rasusmilch/HAB/Weather_Balloon_Info/Sparkfun Geiger/Geiger_Counter-V_HW4.0_FW1.2/README.md

Geiger Counter
========================================
[Geiger Counter
*Geiger Counter (SEN-11345)*](https://www.sparkfun.com/products/11345)

This USB powered Geiger Counter is equipped with an ATMega328 that can be programmed in-circuit. Out of the box, the board works
at 9600 bps over any serial terminal and generates random bits in reaction to background radiation.

Repository Contents
-------------------
* **/Firmware** - Firmware that ships on the Geiger Counter
* **/Hardware** - All Eagle design files (.brd, .sch)
* **/Production** - Test bed files and production panel files

Product Versions
----------------
* [SEN-11345](https://www.sparkfun.com/products/11345)- Version 2.1. Current.
* [SEN-10742](https://www.sparkfun.com/products/retired/10742)- Version 1.2-Retired. 

Version History
---------------
* [v21](https://github.com/sparkfun/Geiger_Counter/tree/HW_2.1_FW_2.1) GitHub version 2.1 files.
* [v12](https://github.com/sparkfun/Geiger_Counter/tree/v12) GitHub version 1.2 files. 

License Information
-------------------
The hardware is released under [Creative Commons ShareAlike 4.0 International](https://creativecommons.org/licenses/by-sa/4.0/).
The code is beerware; if you see me (or any other SparkFun employee) at the local, and you've found our code helpful, please buy us a round!

Distributed as-is; no warranty is given.
