rasusmilch/HAB/Weather_Balloon_Info/Sparkfun Geiger/Geiger_Counter-V_HW4.0_FW1.2/firmware/default_firmware/README.md

This is v12 firmware, which ships on all Geiger Counter boards currently. It is a random number generator.
