rasusmilch/HAB/Weather_Balloon/Documentation/UML_Doxygen/latex/arduino-_zero_regs_2_r_e_a_d_m_e_8md.tex

\hypertarget{arduino-_zero_regs_2_r_e_a_d_m_e_8md}{}\section{Weather\+\_\+\+Balloon/library/arduino-\/\+Zero\+Regs/\+R\+E\+A\+D\+ME.md File Reference}
\label{arduino-_zero_regs_2_r_e_a_d_m_e_8md}\index{Weather\+\_\+\+Balloon/library/arduino-\/\+Zero\+Regs/\+R\+E\+A\+D\+M\+E.\+md@{Weather\+\_\+\+Balloon/library/arduino-\/\+Zero\+Regs/\+R\+E\+A\+D\+M\+E.\+md}}
