rasusmilch/HAB/Weather_Balloon/Documentation/UML_Doxygen/latex/arduino-ms5xxx-master_2_l_i_c_e_n_s_e_8md.tex

\hypertarget{arduino-ms5xxx-master_2_l_i_c_e_n_s_e_8md}{}\section{Weather\+\_\+\+Balloon/library/arduino-\/ms5xxx-\/master/\+L\+I\+C\+E\+N\+SE.md File Reference}
\label{arduino-ms5xxx-master_2_l_i_c_e_n_s_e_8md}\index{Weather\+\_\+\+Balloon/library/arduino-\/ms5xxx-\/master/\+L\+I\+C\+E\+N\+S\+E.\+md@{Weather\+\_\+\+Balloon/library/arduino-\/ms5xxx-\/master/\+L\+I\+C\+E\+N\+S\+E.\+md}}
