rasusmilch/HAB/Weather_Balloon/Documentation/UML_Doxygen/latex/device_8h.tex

\hypertarget{device_8h}{}\section{Weather\+\_\+\+Balloon/library/\+Lib\+A\+P\+R\+S/device.h File Reference}
\label{device_8h}\index{Weather\+\_\+\+Balloon/library/\+Lib\+A\+P\+R\+S/device.\+h@{Weather\+\_\+\+Balloon/library/\+Lib\+A\+P\+R\+S/device.\+h}}
{\ttfamily \#include \char`\"{}constants.\+h\char`\"{}}\\*
Include dependency graph for device.\+h\+:
\nopagebreak
\begin{figure}[H]
\begin{center}
\leavevmode
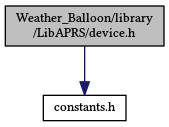
[picture p1: Weather_Balloon/Documentation/UML_Doxygen/html/device_8h__incl.png]

\end{center}
\end{figure}
This graph shows which files directly or indirectly include this file\+:
\nopagebreak
\begin{figure}[H]
\begin{center}
\leavevmode
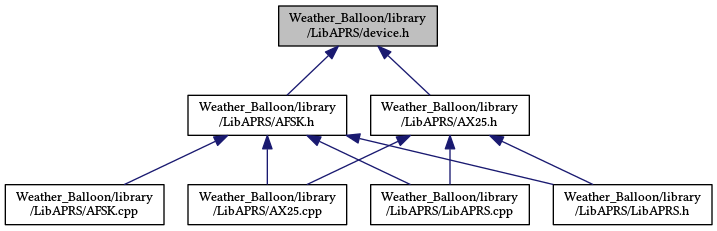
[picture p2: Weather_Balloon/Documentation/UML_Doxygen/html/device_8h__dep__incl.png]

\end{center}
\end{figure}
\subsection*{Macros}
\begin{DoxyCompactItemize}
\item 
\#define \hyperlink{device_8h_a7c97fac2f222d841b9b657b47b2aed87}{T\+A\+R\+G\+E\+T\+\_\+\+C\+PU}~\hyperlink{constants_8h_ab21c12c8b945e012e7cad672d64c6805}{m328p}
\item 
\#define \hyperlink{device_8h_a43bafb28b29491ec7f871319b5a3b2f8}{F\+\_\+\+C\+PU}~16000000
\item 
\#define \hyperlink{device_8h_ae0c5f12cd1a193d30e4e05bbe86ce45e}{F\+R\+E\+Q\+U\+E\+N\+C\+Y\+\_\+\+C\+O\+R\+R\+E\+C\+T\+I\+ON}~0
\item 
\#define \hyperlink{device_8h_a9e83bcb5c8fb1fd1712fc7c454546da9}{C\+O\+N\+F\+I\+G\+\_\+\+A\+F\+S\+K\+\_\+\+D\+A\+C\+\_\+\+S\+A\+M\+P\+L\+E\+R\+A\+TE}~9600
\item 
\#define \hyperlink{device_8h_afbdc123b0b82a37ee0e8272c6e39e66c}{D\+A\+C\+\_\+\+P\+O\+RT}~P\+O\+R\+TD
\item 
\#define \hyperlink{device_8h_a4f88bd60347c4c0ff4344fc8614f390c}{D\+A\+C\+\_\+\+D\+DR}~D\+D\+RD
\item 
\#define \hyperlink{device_8h_a663daa01e565aee93c6f20c5845b90b4}{L\+E\+D\+\_\+\+P\+O\+RT}~P\+O\+R\+TB
\item 
\#define \hyperlink{device_8h_a2eb4252b35effe1188cb61b6124fa617}{L\+E\+D\+\_\+\+D\+DR}~D\+D\+RB
\item 
\#define \hyperlink{device_8h_a1c6ce969ab3d12ac37f62c399a1e02c1}{A\+D\+C\+\_\+\+P\+O\+RT}~P\+O\+R\+TC
\item 
\#define \hyperlink{device_8h_a6f53fbd627478c7f56cdb17b5aa3ff44}{A\+D\+C\+\_\+\+D\+DR}~D\+D\+RC
\end{DoxyCompactItemize}

\subsection{Macro Definition Documentation}
\index{device.\+h@{device.\+h}!A\+D\+C\+\_\+\+D\+DR@{A\+D\+C\+\_\+\+D\+DR}}
\index{A\+D\+C\+\_\+\+D\+DR@{A\+D\+C\+\_\+\+D\+DR}!device.\+h@{device.\+h}}
\subsubsection[{\texorpdfstring{A\+D\+C\+\_\+\+D\+DR}{ADC\_DDR}}]{\setlength{\rightskip}{0pt plus 5cm}\#define A\+D\+C\+\_\+\+D\+DR~D\+D\+RC}\hypertarget{device_8h_a6f53fbd627478c7f56cdb17b5aa3ff44}{}\label{device_8h_a6f53fbd627478c7f56cdb17b5aa3ff44}

Definition at line 29 of file device.\+h.

\index{device.\+h@{device.\+h}!A\+D\+C\+\_\+\+P\+O\+RT@{A\+D\+C\+\_\+\+P\+O\+RT}}
\index{A\+D\+C\+\_\+\+P\+O\+RT@{A\+D\+C\+\_\+\+P\+O\+RT}!device.\+h@{device.\+h}}
\subsubsection[{\texorpdfstring{A\+D\+C\+\_\+\+P\+O\+RT}{ADC\_PORT}}]{\setlength{\rightskip}{0pt plus 5cm}\#define A\+D\+C\+\_\+\+P\+O\+RT~P\+O\+R\+TC}\hypertarget{device_8h_a1c6ce969ab3d12ac37f62c399a1e02c1}{}\label{device_8h_a1c6ce969ab3d12ac37f62c399a1e02c1}

Definition at line 28 of file device.\+h.

\index{device.\+h@{device.\+h}!C\+O\+N\+F\+I\+G\+\_\+\+A\+F\+S\+K\+\_\+\+D\+A\+C\+\_\+\+S\+A\+M\+P\+L\+E\+R\+A\+TE@{C\+O\+N\+F\+I\+G\+\_\+\+A\+F\+S\+K\+\_\+\+D\+A\+C\+\_\+\+S\+A\+M\+P\+L\+E\+R\+A\+TE}}
\index{C\+O\+N\+F\+I\+G\+\_\+\+A\+F\+S\+K\+\_\+\+D\+A\+C\+\_\+\+S\+A\+M\+P\+L\+E\+R\+A\+TE@{C\+O\+N\+F\+I\+G\+\_\+\+A\+F\+S\+K\+\_\+\+D\+A\+C\+\_\+\+S\+A\+M\+P\+L\+E\+R\+A\+TE}!device.\+h@{device.\+h}}
\subsubsection[{\texorpdfstring{C\+O\+N\+F\+I\+G\+\_\+\+A\+F\+S\+K\+\_\+\+D\+A\+C\+\_\+\+S\+A\+M\+P\+L\+E\+R\+A\+TE}{CONFIG\_AFSK\_DAC\_SAMPLERATE}}]{\setlength{\rightskip}{0pt plus 5cm}\#define C\+O\+N\+F\+I\+G\+\_\+\+A\+F\+S\+K\+\_\+\+D\+A\+C\+\_\+\+S\+A\+M\+P\+L\+E\+R\+A\+TE~9600}\hypertarget{device_8h_a9e83bcb5c8fb1fd1712fc7c454546da9}{}\label{device_8h_a9e83bcb5c8fb1fd1712fc7c454546da9}

Definition at line 20 of file device.\+h.

\index{device.\+h@{device.\+h}!D\+A\+C\+\_\+\+D\+DR@{D\+A\+C\+\_\+\+D\+DR}}
\index{D\+A\+C\+\_\+\+D\+DR@{D\+A\+C\+\_\+\+D\+DR}!device.\+h@{device.\+h}}
\subsubsection[{\texorpdfstring{D\+A\+C\+\_\+\+D\+DR}{DAC\_DDR}}]{\setlength{\rightskip}{0pt plus 5cm}\#define D\+A\+C\+\_\+\+D\+DR~D\+D\+RD}\hypertarget{device_8h_a4f88bd60347c4c0ff4344fc8614f390c}{}\label{device_8h_a4f88bd60347c4c0ff4344fc8614f390c}

Definition at line 25 of file device.\+h.

\index{device.\+h@{device.\+h}!D\+A\+C\+\_\+\+P\+O\+RT@{D\+A\+C\+\_\+\+P\+O\+RT}}
\index{D\+A\+C\+\_\+\+P\+O\+RT@{D\+A\+C\+\_\+\+P\+O\+RT}!device.\+h@{device.\+h}}
\subsubsection[{\texorpdfstring{D\+A\+C\+\_\+\+P\+O\+RT}{DAC\_PORT}}]{\setlength{\rightskip}{0pt plus 5cm}\#define D\+A\+C\+\_\+\+P\+O\+RT~P\+O\+R\+TD}\hypertarget{device_8h_afbdc123b0b82a37ee0e8272c6e39e66c}{}\label{device_8h_afbdc123b0b82a37ee0e8272c6e39e66c}

Definition at line 24 of file device.\+h.

\index{device.\+h@{device.\+h}!F\+\_\+\+C\+PU@{F\+\_\+\+C\+PU}}
\index{F\+\_\+\+C\+PU@{F\+\_\+\+C\+PU}!device.\+h@{device.\+h}}
\subsubsection[{\texorpdfstring{F\+\_\+\+C\+PU}{F\_CPU}}]{\setlength{\rightskip}{0pt plus 5cm}\#define F\+\_\+\+C\+PU~16000000}\hypertarget{device_8h_a43bafb28b29491ec7f871319b5a3b2f8}{}\label{device_8h_a43bafb28b29491ec7f871319b5a3b2f8}

Definition at line 12 of file device.\+h.

\index{device.\+h@{device.\+h}!F\+R\+E\+Q\+U\+E\+N\+C\+Y\+\_\+\+C\+O\+R\+R\+E\+C\+T\+I\+ON@{F\+R\+E\+Q\+U\+E\+N\+C\+Y\+\_\+\+C\+O\+R\+R\+E\+C\+T\+I\+ON}}
\index{F\+R\+E\+Q\+U\+E\+N\+C\+Y\+\_\+\+C\+O\+R\+R\+E\+C\+T\+I\+ON@{F\+R\+E\+Q\+U\+E\+N\+C\+Y\+\_\+\+C\+O\+R\+R\+E\+C\+T\+I\+ON}!device.\+h@{device.\+h}}
\subsubsection[{\texorpdfstring{F\+R\+E\+Q\+U\+E\+N\+C\+Y\+\_\+\+C\+O\+R\+R\+E\+C\+T\+I\+ON}{FREQUENCY\_CORRECTION}}]{\setlength{\rightskip}{0pt plus 5cm}\#define F\+R\+E\+Q\+U\+E\+N\+C\+Y\+\_\+\+C\+O\+R\+R\+E\+C\+T\+I\+ON~0}\hypertarget{device_8h_ae0c5f12cd1a193d30e4e05bbe86ce45e}{}\label{device_8h_ae0c5f12cd1a193d30e4e05bbe86ce45e}

Definition at line 16 of file device.\+h.

\index{device.\+h@{device.\+h}!L\+E\+D\+\_\+\+D\+DR@{L\+E\+D\+\_\+\+D\+DR}}
\index{L\+E\+D\+\_\+\+D\+DR@{L\+E\+D\+\_\+\+D\+DR}!device.\+h@{device.\+h}}
\subsubsection[{\texorpdfstring{L\+E\+D\+\_\+\+D\+DR}{LED\_DDR}}]{\setlength{\rightskip}{0pt plus 5cm}\#define L\+E\+D\+\_\+\+D\+DR~D\+D\+RB}\hypertarget{device_8h_a2eb4252b35effe1188cb61b6124fa617}{}\label{device_8h_a2eb4252b35effe1188cb61b6124fa617}

Definition at line 27 of file device.\+h.

\index{device.\+h@{device.\+h}!L\+E\+D\+\_\+\+P\+O\+RT@{L\+E\+D\+\_\+\+P\+O\+RT}}
\index{L\+E\+D\+\_\+\+P\+O\+RT@{L\+E\+D\+\_\+\+P\+O\+RT}!device.\+h@{device.\+h}}
\subsubsection[{\texorpdfstring{L\+E\+D\+\_\+\+P\+O\+RT}{LED\_PORT}}]{\setlength{\rightskip}{0pt plus 5cm}\#define L\+E\+D\+\_\+\+P\+O\+RT~P\+O\+R\+TB}\hypertarget{device_8h_a663daa01e565aee93c6f20c5845b90b4}{}\label{device_8h_a663daa01e565aee93c6f20c5845b90b4}

Definition at line 26 of file device.\+h.

\index{device.\+h@{device.\+h}!T\+A\+R\+G\+E\+T\+\_\+\+C\+PU@{T\+A\+R\+G\+E\+T\+\_\+\+C\+PU}}
\index{T\+A\+R\+G\+E\+T\+\_\+\+C\+PU@{T\+A\+R\+G\+E\+T\+\_\+\+C\+PU}!device.\+h@{device.\+h}}
\subsubsection[{\texorpdfstring{T\+A\+R\+G\+E\+T\+\_\+\+C\+PU}{TARGET\_CPU}}]{\setlength{\rightskip}{0pt plus 5cm}\#define T\+A\+R\+G\+E\+T\+\_\+\+C\+PU~{\bf m328p}}\hypertarget{device_8h_a7c97fac2f222d841b9b657b47b2aed87}{}\label{device_8h_a7c97fac2f222d841b9b657b47b2aed87}

Definition at line 8 of file device.\+h.
