rasusmilch/HAB/Weather_Balloon/Documentation/UML_Doxygen/latex/hierarchy.tex

\section{Class Hierarchy}
This inheritance list is sorted roughly, but not completely, alphabetically\+:\begin{DoxyCompactList}
\item \contentsline{section}{accel\+Settings}{\pageref{_l_s_m9_d_s1___types_8h}}{}
\item \contentsline{section}{Adafruit\+\_\+\+Sensor}{\pageref{class_adafruit___sensor}}{}
\begin{DoxyCompactList}
\item \contentsline{section}{Adafruit\+\_\+\+A\+D\+X\+L345\+\_\+\+Unified}{\pageref{class_adafruit___a_d_x_l345___unified}}{}
\item \contentsline{section}{Adafruit\+\_\+\+T\+S\+L2561\+\_\+\+Unified}{\pageref{class_adafruit___t_s_l2561___unified}}{}
\end{DoxyCompactList}
\item \contentsline{section}{Adafruit\+\_\+\+S\+H\+T31}{\pageref{class_adafruit___s_h_t31}}{}
\item \contentsline{section}{Adafruit\+\_\+\+S\+I1145}{\pageref{class_adafruit___s_i1145}}{}
\item B\+L\+E\+Peripheral\begin{DoxyCompactList}
\item \contentsline{section}{B\+L\+E\+Stream}{\pageref{class_b_l_e_stream}}{}
\end{DoxyCompactList}
\item \contentsline{section}{cid\+\_\+t}{\pageref{_sd_info_8h}}{}
\item \contentsline{section}{csd1\+\_\+t}{\pageref{_sd_info_8h}}{}
\item \contentsline{section}{csd2\+\_\+t}{\pageref{_sd_info_8h}}{}
\item \contentsline{section}{csd\+\_\+t}{\pageref{_sd_info_8h}}{}
\item \contentsline{section}{Dallas\+Temperature}{\pageref{class_dallas_temperature}}{}
\item \contentsline{section}{data\+\_\+struct}{\pageref{_weather___balloon_8cpp}}{}
\item \contentsline{section}{data\+\_\+struct.\+accel}{\pageref{_weather___balloon_8cpp}}{}
\item \contentsline{section}{data\+\_\+struct.\+battery}{\pageref{_weather___balloon_8cpp}}{}
\item \contentsline{section}{data\+\_\+struct.\+enabled}{\pageref{_weather___balloon_8cpp}}{}
\item \contentsline{section}{data\+\_\+struct.\+found}{\pageref{_weather___balloon_8cpp}}{}
\item \contentsline{section}{data\+\_\+struct.\+geiger}{\pageref{_weather___balloon_8cpp}}{}
\item \contentsline{section}{data\+\_\+struct.\+gps}{\pageref{_weather___balloon_8cpp}}{}
\item \contentsline{section}{data\+\_\+struct.\+gyro}{\pageref{_weather___balloon_8cpp}}{}
\item \contentsline{section}{data\+\_\+struct.\+mag}{\pageref{_weather___balloon_8cpp}}{}
\item \contentsline{section}{data\+\_\+struct.\+ms5607}{\pageref{_weather___balloon_8cpp}}{}
\item \contentsline{section}{data\+\_\+struct.\+pwm}{\pageref{_weather___balloon_8cpp}}{}
\item \contentsline{section}{data\+\_\+struct.\+sht31}{\pageref{_weather___balloon_8cpp}}{}
\item \contentsline{section}{data\+\_\+struct.\+temp}{\pageref{_weather___balloon_8cpp}}{}
\item \contentsline{section}{data\+\_\+struct.\+tsl}{\pageref{_weather___balloon_8cpp}}{}
\item \contentsline{section}{Date\+Time}{\pageref{class_date_time}}{}
\item \contentsline{section}{device\+Settings}{\pageref{_l_s_m9_d_s1___types_8h}}{}
\item \contentsline{section}{D\+S3231}{\pageref{class_d_s3231}}{}
\item \contentsline{section}{eeprom\+\_\+struct}{\pageref{_weather___balloon_8cpp}}{}
\item \contentsline{section}{Filter\+Derivative}{\pageref{struct_filter_derivative}}{}
\item \contentsline{section}{Filter\+One\+Pole}{\pageref{struct_filter_one_pole}}{}
\item \contentsline{section}{Filter\+One\+Pole\+Cascade}{\pageref{struct_filter_one_pole_cascade}}{}
\item \contentsline{section}{Filter\+Two\+Pole}{\pageref{struct_filter_two_pole}}{}
\item \contentsline{section}{Firmata\+Class}{\pageref{class_firmata_class}}{}
\item \contentsline{section}{Firmata\+Feature}{\pageref{class_firmata_feature}}{}
\begin{DoxyCompactList}
\item \contentsline{section}{Serial\+Firmata}{\pageref{class_serial_firmata}}{}
\end{DoxyCompactList}
\item \contentsline{section}{gyro\+Settings}{\pageref{_l_s_m9_d_s1___types_8h}}{}
\item \contentsline{section}{I\+M\+U\+Settings}{\pageref{_l_s_m9_d_s1___types_8h}}{}
\item \contentsline{section}{Led\+Control}{\pageref{class_led_control}}{}
\item \contentsline{section}{L\+S\+M9\+D\+S1}{\pageref{class_l_s_m9_d_s1}}{}
\item \contentsline{section}{M\+A\+G3110}{\pageref{class_m_a_g3110}}{}
\item \contentsline{section}{mag\+Settings}{\pageref{_l_s_m9_d_s1___types_8h}}{}
\item \contentsline{section}{M\+A\+X17043}{\pageref{class_m_a_x17043}}{}
\item \contentsline{section}{M\+S5xxx}{\pageref{class_m_s5xxx}}{}
\begin{DoxyCompactList}
\item \contentsline{section}{M\+S5611}{\pageref{class_m_s5611}}{}
\end{DoxyCompactList}
\item \contentsline{section}{One\+Wire}{\pageref{class_one_wire}}{}
\item \contentsline{section}{P\+ID}{\pageref{class_p_i_d}}{}
\item \contentsline{section}{Port\+\_\+\+Pin}{\pageref{_zero_regs_8cpp}}{}
\item \contentsline{section}{Raw\+Degrees}{\pageref{struct_raw_degrees}}{}
\item \contentsline{section}{R\+T\+C\+\_\+\+D\+S1307}{\pageref{class_r_t_c___d_s1307}}{}
\item \contentsline{section}{R\+T\+C\+\_\+\+D\+S3231}{\pageref{class_r_t_c___d_s3231}}{}
\item \contentsline{section}{R\+T\+C\+\_\+\+D\+S3234}{\pageref{class_r_t_c___d_s3234}}{}
\item \contentsline{section}{R\+T\+C\+\_\+\+Millis}{\pageref{class_r_t_c___millis}}{}
\item \contentsline{section}{R\+T\+C\+Alarm\+Time}{\pageref{_d_s3231_8h}}{}
\item \contentsline{section}{R\+T\+C\+Date\+Time}{\pageref{_d_s3231_8h}}{}
\item \contentsline{section}{R\+T\+C\+Zero}{\pageref{class_r_t_c_zero}}{}
\item \contentsline{section}{Running\+Statistics}{\pageref{struct_running_statistics}}{}
\item \contentsline{section}{Sd2\+Card}{\pageref{class_sd2_card}}{}
\item \contentsline{section}{sd\+\_\+data}{\pageref{_weather___balloon_8cpp}}{}
\item \contentsline{section}{sensor\+\_\+t}{\pageref{_adafruit___sensor_8h}}{}
\item \contentsline{section}{sensors\+\_\+color\+\_\+t}{\pageref{_adafruit___sensor_8h}}{}
\item \contentsline{section}{sensors\+\_\+color\+\_\+t.\+\_\+\+\_\+unnamed\+\_\+\+\_\+}{\pageref{_adafruit___sensor_8h}}{}
\item \contentsline{section}{sensors\+\_\+color\+\_\+t.\+\_\+\+\_\+unnamed\+\_\+\+\_\+.\+\_\+\+\_\+unnamed\+\_\+\+\_\+}{\pageref{_adafruit___sensor_8h}}{}
\item \contentsline{section}{sensors\+\_\+event\+\_\+t}{\pageref{_adafruit___sensor_8h}}{}
\item \contentsline{section}{sensors\+\_\+event\+\_\+t.\+\_\+\+\_\+unnamed\+\_\+\+\_\+}{\pageref{_adafruit___sensor_8h}}{}
\item \contentsline{section}{sensors\+\_\+vec\+\_\+t}{\pageref{_adafruit___sensor_8h}}{}
\item \contentsline{section}{sensors\+\_\+vec\+\_\+t.\+\_\+\+\_\+unnamed\+\_\+\+\_\+}{\pageref{_adafruit___sensor_8h}}{}
\item \contentsline{section}{sensors\+\_\+vec\+\_\+t.\+\_\+\+\_\+unnamed\+\_\+\+\_\+.\+\_\+\+\_\+unnamed\+\_\+\+\_\+}{\pageref{_adafruit___sensor_8h}}{}
\item \contentsline{section}{sensors\+\_\+vec\+\_\+t.\+\_\+\+\_\+unnamed\+\_\+\+\_\+.\+\_\+\+\_\+unnamed\+\_\+\+\_\+}{\pageref{_adafruit___sensor_8h}}{}
\item Stream\begin{DoxyCompactList}
\item \contentsline{section}{B\+L\+E\+Stream}{\pageref{class_b_l_e_stream}}{}
\item \contentsline{section}{Ethernet\+Client\+Stream}{\pageref{class_ethernet_client_stream}}{}
\item \contentsline{section}{Wi\+Fi\+Stream}{\pageref{class_wi_fi_stream}}{}
\begin{DoxyCompactList}
\item \contentsline{section}{Wi\+Fi\+Client\+Stream}{\pageref{class_wi_fi_client_stream}}{}
\item \contentsline{section}{Wi\+Fi\+Server\+Stream}{\pageref{class_wi_fi_server_stream}}{}
\end{DoxyCompactList}
\end{DoxyCompactList}
\item \contentsline{section}{temperature\+Settings}{\pageref{_l_s_m9_d_s1___types_8h}}{}
\item \contentsline{section}{Tiny\+G\+P\+S\+Custom}{\pageref{class_tiny_g_p_s_custom}}{}
\item \contentsline{section}{Tiny\+G\+P\+S\+Date}{\pageref{struct_tiny_g_p_s_date}}{}
\item \contentsline{section}{Tiny\+G\+P\+S\+Decimal}{\pageref{struct_tiny_g_p_s_decimal}}{}
\begin{DoxyCompactList}
\item \contentsline{section}{Tiny\+G\+P\+S\+Altitude}{\pageref{struct_tiny_g_p_s_altitude}}{}
\item \contentsline{section}{Tiny\+G\+P\+S\+Course}{\pageref{struct_tiny_g_p_s_course}}{}
\item \contentsline{section}{Tiny\+G\+P\+S\+Speed}{\pageref{struct_tiny_g_p_s_speed}}{}
\end{DoxyCompactList}
\item \contentsline{section}{Tiny\+G\+P\+S\+Integer}{\pageref{struct_tiny_g_p_s_integer}}{}
\item \contentsline{section}{Tiny\+G\+P\+S\+Location}{\pageref{struct_tiny_g_p_s_location}}{}
\item \contentsline{section}{Tiny\+G\+P\+S\+Plus}{\pageref{class_tiny_g_p_s_plus}}{}
\item \contentsline{section}{Tiny\+G\+P\+S\+Time}{\pageref{struct_tiny_g_p_s_time}}{}
\item \contentsline{section}{Zero\+Reg\+Options}{\pageref{_zero_regs_8h}}{}
\end{DoxyCompactList}
