rasusmilch/HAB/Weather_Balloon/Documentation/UML_Doxygen/latex/md_Weather_Balloon_library_Adafruit_TSL2561-master_README.tex

\#\+Adafruit T\+S\+L2561 Light Sensor Driver \#

This driver is for the Adafruit T\+S\+L2561 Breakout, and is based on Adafruit\textquotesingle{}s Unified Sensor Library (\hyperlink{class_adafruit___sensor}{Adafruit\+\_\+\+Sensor}).

The driver supports manual or \textquotesingle{}auto\textquotesingle{} gain. Adjusting the gain allows you to make the sensor more or less \textquotesingle{}sensitive\textquotesingle{} to light (depending on if you are indoors or outdoors, for example)\+: 
\begin{DoxyCode}
1 tsl.setGain(TSL2561\_GAIN\_1X);      /* No gain ... use in bright light to avoid sensor saturation */
2 tsl.setGain(TSL2561\_GAIN\_16X);     /* 16x gain ... use in low light to boost sensitivity */
3 tsl.enableAutoGain(true);          /* Auto-gain ... switches automatically between 1x and 16x */
\end{DoxyCode}

The driver also supports as automatic clipping detection, and will return \textquotesingle{}65536\textquotesingle{} lux when the sensor is saturated and data is unreliable. tsl.\+get\+Event will return false in case of saturation and true in case of valid light data.

\subsection*{About the T\+S\+L2561}

The T\+S\+L2561 is a 16-\/bit digital (I2C) light sensor, with adjustable gain and \textquotesingle{}integration time\textquotesingle{}.

Adjusting the \textquotesingle{}integration time\textquotesingle{} essentially increases the resolution of the device, since the analog converter inside the chip has time to take more samples. The integration time can be set as follows\+: 
\begin{DoxyCode}
1 tsl.setIntegrationTime(TSL2561\_INTEGRATIONTIME\_13MS);      /* fast but low resolution */
2 tsl.setIntegrationTime(TSL2561\_INTEGRATIONTIME\_101MS);  /* medium resolution and speed   */
3 tsl.setIntegrationTime(TSL2561\_INTEGRATIONTIME\_402MS);  /* 16-bit data but slowest conversions */
\end{DoxyCode}

One of the big advantages of the T\+S\+L2561 is that it is capable of measuring both broadband (visible plus infrared) and infrared light thanks to two distinct sensing units on the device. This is important in certain lighting environments to be able to read the light level reliably.

More information on the T\+S\+L2561 can be found in the datasheet\+: \href{http://www.adafruit.com/datasheets/TSL2561.pdf}{\tt http\+://www.\+adafruit.\+com/datasheets/\+T\+S\+L2561.\+pdf}

\subsection*{What is the Adafruit Unified Sensor Library?}

The Adafruit Unified Sensor Library (\hyperlink{class_adafruit___sensor}{Adafruit\+\_\+\+Sensor}) provides a common interface and data type for any supported sensor. It defines some basic information about the sensor (sensor limits, etc.), and returns standard SI units of a specific type and scale for each supported sensor type.

It provides a simple abstraction layer between your application and the actual sensor HW, allowing you to drop in any comparable sensor with only one or two lines of code to change in your project (essentially the constructor since the functions to read sensor data and get information about the sensor are defined in the base \hyperlink{class_adafruit___sensor}{Adafruit\+\_\+\+Sensor} class).

This is imporant useful for two reasons\+:

1.) You can use the data right away because it\textquotesingle{}s already converted to SI units that you understand and can compare, rather than meaningless values like 0..1023.

2.) Because SI units are standardised in the sensor library, you can also do quick sanity checks working with new sensors, or drop in any comparable sensor if you need better sensitivity or if a lower cost unit becomes available, etc.

Light sensors will always report units in lux, gyroscopes will always report units in rad/s, etc. ... freeing you up to focus on the data, rather than digging through the datasheet to understand what the sensor\textquotesingle{}s raw numbers really mean.

\subsection*{About this Driver}

Adafruit invests time and resources providing this open source code. Please support Adafruit and open-\/source hardware by purchasing products from Adafruit!

Written by Kevin (K\+T\+O\+WN) Townsend for Adafruit Industries.
