rasusmilch/HAB/Weather_Balloon/Documentation/UML_Doxygen/latex/md_Weather_Balloon_library_Arduino-Temperature-Control-Library_README.tex

\subsection*{Usage}

This library supports the following devices \+:

\begin{DoxyItemize}
\item D\+S18\+B20
\item D\+S18\+S20 -\/ Please note there appears to be an issue with this series.
\item D\+S1822
\item D\+S1820
\end{DoxyItemize}

You will need a pull-\/up resistor of about 5 K\+Ohm between the 1-\/\+Wire data line and your 5V power. If you are using the D\+S18\+B20, ground pins 1 and 3. The centre pin is the data line \textquotesingle{}1-\/wire\textquotesingle{}.

We have included a \char`\"{}\+R\+E\+Q\+U\+I\+R\+E\+S\+N\+E\+W\char`\"{} and \char`\"{}\+R\+E\+Q\+U\+I\+R\+E\+S\+A\+L\+A\+R\+M\+S\char`\"{} definition. If you want to slim down the code feel free to use either of these by including

\begin{DoxyVerb}#define REQUIRESNEW 
\end{DoxyVerb}

or \begin{DoxyVerb}#define REQUIRESALARMS
\end{DoxyVerb}

at the top of \hyperlink{_dallas_temperature_8h}{Dallas\+Temperature.\+h}

\subsection*{Credits}

The \hyperlink{class_one_wire}{One\+Wire} code has been derived from \href{http://www.arduino.cc/playground/Learning/OneWire}{\tt http\+://www.\+arduino.\+cc/playground/\+Learning/\+One\+Wire}. Miles Burton \href{mailto:miles@mnetcs.com}{\tt miles@mnetcs.\+com} originally developed this library. Tim Newsome \href{mailto:nuisance@casualhacker.net}{\tt nuisance@casualhacker.\+net} added support for multiple sensors on the same bus. Guil Barros \mbox{[}\href{mailto:gfbarros@bappos.com}{\tt gfbarros@bappos.\+com}\mbox{]} added get\+Temp\+By\+Address (v3.\+5) Rob Tillaart \mbox{[}\href{mailto:rob.tillaart@gmail.com}{\tt rob.\+tillaart@gmail.\+com}\mbox{]} added async modus (v3.\+7.\+0)

\subsection*{Website}

You can find the latest version of the library at \href{http://milesburton.com/index.php?title=Dallas_Temperature_Control_Library}{\tt http\+://milesburton.\+com/index.\+php?title=\+Dallas\+\_\+\+Temperature\+\_\+\+Control\+\_\+\+Library}

\section*{License}

This library is free software; you can redistribute it and/or modify it under the terms of the G\+NU Lesser General Public License as published by the Free Software Foundation; either version 2.\+1 of the License, or (at your option) any later version.

This library is distributed in the hope that it will be useful, but W\+I\+T\+H\+O\+UT A\+NY W\+A\+R\+R\+A\+N\+TY; without even the implied warranty of M\+E\+R\+C\+H\+A\+N\+T\+A\+B\+I\+L\+I\+TY or F\+I\+T\+N\+E\+SS F\+OR A P\+A\+R\+T\+I\+C\+U\+L\+AR P\+U\+R\+P\+O\+SE. See the G\+NU Lesser General Public License for more details.

You should have received a copy of the G\+NU Lesser General Public License along with this library; if not, write to the Free Software Foundation, Inc., 51 Franklin St, Fifth Floor, Boston, MA 02110-\/1301 U\+SA
