rasusmilch/HAB/Weather_Balloon/Documentation/UML_Doxygen/latex/md_Weather_Balloon_library_arduino-ZeroRegs_README.tex

prints the configuration registers for the Arduino Zero (and similar boards)

{\bfseries Intended Audience\+:} advanced users who have already looked at the S\+AM D21 datasheet

\subsection*{Simple Example }

\begin{DoxyCode}
\textcolor{preprocessor}{#include <\hyperlink{_zero_regs_8h}{ZeroRegs.h}>}
\textcolor{keywordtype}{void} \hyperlink{_m_a_x17043___simple_8cpp_a4fc01d736fe50cf5b977f755b675f11d}{setup}() \{
    SerialUSB.begin(9600);
    \textcolor{keywordflow}{while} (! SerialUSB) \{\}  \textcolor{comment}{// wait for serial monitor to attach}
    \hyperlink{_zero_regs_8h_struct_zero_reg_options}{ZeroRegOptions} opts = \{ SerialUSB, \textcolor{keyword}{false} \};
    \hyperlink{_zero_regs_8cpp_af97a7289c40861b813fab70cfb71db67}{printZeroRegs}(opts);
\}
\end{DoxyCode}

\subsection*{Function Reference }

\subsubsection*{struct \hyperlink{_zero_regs_8h_struct_zero_reg_options}{Zero\+Reg\+Options}}

\tabulinesep=1mm
\begin{longtabu} spread 0pt [c]{*3{|X[-1]}|}
\hline
\rowcolor{\tableheadbgcolor}{\bf type }&{\bf name }&{\bf description  }\\\cline{1-3}
\endfirsthead
\hline
\endfoot
\hline
\rowcolor{\tableheadbgcolor}{\bf type }&{\bf name }&{\bf description  }\\\cline{1-3}
\endhead
{\ttfamily Stream\&} &{\ttfamily ser} &stream used for printing output \\\cline{1-3}
{\ttfamily bool} &{\ttfamily show\+Disabled} &whether to show itmes which are disabled \\\cline{1-3}
\end{longtabu}

\subsubsection*{void \hyperlink{_zero_regs_8h_af97a7289c40861b813fab70cfb71db67}{print\+Zero\+Regs(\+Zero\+Reg\+Options \&opts)}}

Prints out configuration registers, as many as the library knows how.

\subsubsection*{void \hyperlink{_zero_regs_8h_a147a30d688c41a0d39922ca6d2cd6bfb}{print\+Zero\+Reg\+A\+C(\+Zero\+Reg\+Options \&opts)} -- {\bfseries N\+OT Y\+ET I\+M\+P\+L\+E\+M\+E\+N\+T\+ED}}

Prints out the configuration registers for the {\ttfamily AC} peripheral.

\subsubsection*{void \hyperlink{_zero_regs_8h_a67d77c008fc2ce98d2d78168aa64e9d8}{print\+Zero\+Reg\+A\+D\+C(\+Zero\+Reg\+Options \&opts)} -- {\bfseries N\+OT Y\+ET I\+M\+P\+L\+E\+M\+E\+N\+T\+ED}}

Prints out the configuration registers for the {\ttfamily A\+DC} peripheral.

\subsubsection*{void \hyperlink{_zero_regs_8h_a1095e7bbe04b7d3f6b4d58d8e7a42df8}{print\+Zero\+Reg\+D\+A\+C(\+Zero\+Reg\+Options \&opts)} -- {\bfseries N\+OT Y\+ET I\+M\+P\+L\+E\+M\+E\+N\+T\+ED}}

Prints out the configuration registers for the {\ttfamily D\+AC} peripheral.

\subsubsection*{void \hyperlink{_zero_regs_8h_a9a5372cd2135bb853cfdbf3db45dd79c}{print\+Zero\+Reg\+D\+M\+A\+C(\+Zero\+Reg\+Options \&opts)} -- {\bfseries N\+OT Y\+ET I\+M\+P\+L\+E\+M\+E\+N\+T\+ED}}

Prints out the configuration registers for the {\ttfamily D\+M\+AC} peripheral.

\subsubsection*{void \hyperlink{_zero_regs_8h_a06b2995104e4c1cbc2f61e11e3a3e484}{print\+Zero\+Reg\+D\+S\+U(\+Zero\+Reg\+Options \&opts)} -- {\bfseries N\+OT Y\+ET I\+M\+P\+L\+E\+M\+E\+N\+T\+ED}}

Prints out the configuration registers for the {\ttfamily D\+SU} peripheral.

\subsubsection*{void \hyperlink{_zero_regs_8h_ac587593ee2a9ae02c2cfc677fe773c28}{print\+Zero\+Reg\+E\+I\+C(\+Zero\+Reg\+Options \&opts)}}

Prints out the configuration registers for the {\ttfamily E\+IC} peripheral.

\subsubsection*{void \hyperlink{_zero_regs_8h_aab346cdb76613ed12e521b2e3ab8e585}{print\+Zero\+Reg\+E\+V\+S\+Y\+S(\+Zero\+Reg\+Options \&opts)}}

Prints out the configuration registers for the {\ttfamily E\+V\+S\+YS} peripheral.

\subsubsection*{void \hyperlink{_zero_regs_8h_a4f780af586626841f0bfd07761caae27}{print\+Zero\+Reg\+G\+C\+L\+K(\+Zero\+Reg\+Options \&opts)}}

Prints out the configuration registers for the {\ttfamily G\+C\+LK} peripheral.

\subsubsection*{void \hyperlink{_zero_regs_8h_ad986e6312220f31739dbe2c5e4c9326d}{print\+Zero\+Reg\+I2\+S(\+Zero\+Reg\+Options \&opts)} -- {\bfseries N\+OT Y\+ET I\+M\+P\+L\+E\+M\+E\+N\+T\+ED}}

Prints out the configuration registers for the {\ttfamily I2S} peripheral.

\subsubsection*{void \hyperlink{_zero_regs_8h_aaac9e29b52fd1df890dfa14c2f502420}{print\+Zero\+Reg\+M\+T\+B(\+Zero\+Reg\+Options \&opts)} -- {\bfseries N\+OT Y\+ET I\+M\+P\+L\+E\+M\+E\+N\+T\+ED}}

Prints out the configuration registers for the {\ttfamily M\+TB} peripheral.

\subsubsection*{void \hyperlink{_zero_regs_8h_a6db7f49d374fa825b83040a5acaf04b2}{print\+Zero\+Reg\+N\+V\+M\+C\+T\+R\+L(\+Zero\+Reg\+Options \&opts)}}

Prints out the configuration registers for the {\ttfamily N\+V\+M\+C\+T\+RL} peripheral.

\subsubsection*{void print\+Zero\+Reg\+P\+A\+Cs(\+Zero\+Reg\+Options \&opts)}

Prints out the configuration registers for the {\ttfamily P\+AC} peripherals.

\subsubsection*{void \hyperlink{_zero_regs_8h_a1807ae19c29483ee063bd225c40e0d36}{print\+Zero\+Reg\+P\+M(\+Zero\+Reg\+Options \&opts)}}

Prints out the configuration registers for the {\ttfamily PM} peripheral.

\subsubsection*{void \hyperlink{_zero_regs_8h_ac515fdec9d58f6339d3e38cc33c6f74f}{print\+Zero\+Reg\+P\+O\+R\+T(\+Zero\+Reg\+Options \&opts)}}

Prints out the configuration registers for the {\ttfamily P\+O\+RT} peripheral.

\subsubsection*{void \hyperlink{_zero_regs_8h_abd5756f7cbf2e09db78469867a6c5051}{print\+Zero\+Reg\+R\+T\+C(\+Zero\+Reg\+Options \&opts)}}

Prints out the configuration registers for the {\ttfamily R\+TC} peripheral.

\subsubsection*{void \hyperlink{_zero_regs_8h_a91755cc900313248c2a65a925cd46c41}{print\+Zero\+Reg\+S\+B\+M\+A\+T\+R\+I\+X(\+Zero\+Reg\+Options \&opts)}}

Prints out the configuration registers for the {\ttfamily S\+B\+M\+A\+T\+R\+IX} peripheral.

\subsubsection*{void \hyperlink{_zero_regs_8h_a7db1a4f0d10e2e3efcd108837d85ee49}{print\+Zero\+Reg\+S\+E\+R\+C\+O\+M(\+Zero\+Reg\+Options \&opts, Sercom$\ast$ sercom, uint8\+\_\+t idx)}}

Prints out the configuration registers for a {\ttfamily S\+E\+R\+C\+OM} peripheral.

\subsubsection*{void \hyperlink{_zero_regs_8h_a7b606cb3f1144532412356243668c1ce}{print\+Zero\+Reg\+S\+Y\+S\+C\+T\+R\+L(\+Zero\+Reg\+Options \&opts)}}

Prints out the configuration registers for the {\ttfamily S\+Y\+S\+C\+T\+RL} peripheral.

\subsubsection*{void \hyperlink{_zero_regs_8h_a0f776ca1e5a274dd72257e015eba2f98}{print\+Zero\+Reg\+T\+C(\+Zero\+Reg\+Options \&opts, Tc$\ast$ tc, uint8\+\_\+t idx)} -- {\bfseries N\+OT Y\+ET I\+M\+P\+L\+E\+M\+E\+N\+T\+ED}}

Prints out the configuration registers for a {\ttfamily TC} peripheral.

\subsubsection*{void \hyperlink{_zero_regs_8h_acdcf41658b0d0b0747a170019743e2b8}{print\+Zero\+Reg\+T\+C\+C(\+Zero\+Reg\+Options \&opts, Tcc$\ast$ tcc, uint8\+\_\+t idx)} -- {\bfseries N\+OT Y\+ET I\+M\+P\+L\+E\+M\+E\+N\+T\+ED}}

Prints out the configuration registers for a {\ttfamily T\+CC} peripheral.

\subsubsection*{void \hyperlink{_zero_regs_8h_a0f50e185fe18ba9749b55a6d7ac781f1}{print\+Zero\+Reg\+U\+S\+B(\+Zero\+Reg\+Options \&opts)} -- {\bfseries N\+OT Y\+ET I\+M\+P\+L\+E\+M\+E\+N\+T\+ED}}

Prints out the configuration registers for the {\ttfamily U\+SB} peripheral.

\subsubsection*{void \hyperlink{_zero_regs_8h_a8dd36048a3979014ebb8d385046c91e1}{print\+Zero\+Reg\+W\+D\+T(\+Zero\+Reg\+Options \&opts)}}

Prints out the configuration registers for the {\ttfamily W\+DT} peripheral.

\subsection*{License }

This code is licensed under the M\+IT license. See the {\ttfamily L\+I\+C\+E\+N\+SE} file for details.
