rasusmilch/HAB/Weather_Balloon/Documentation/UML_Doxygen/latex/md_Weather_Balloon_library_LedControl-master_README.tex

\hyperlink{class_led_control}{Led\+Control} is an \href{http://arduino.cc}{\tt Arduino} library for M\+A\+X7219 and M\+A\+X7221 Led display drivers. The code also works with the \href{https://www.pjrc.com/teensy/}{\tt Teensy (3.\+1)}

\subsection*{Documentation }

Documentation for the library is on the \href{http://wayoda.github.io/LedControl/}{\tt Github Project Pages}

\subsection*{Download }

The lastest binary version of the Library is always available from the \href{https://github.com/wayoda/LedControl/releases}{\tt Led\+Control Release Page}

\subsection*{Install }

The library can be installed using the \href{http://arduino.cc/en/Guide/Libraries}{\tt standard Arduino library install procedure}
