rasusmilch/HAB/Weather_Balloon/Documentation/UML_Doxygen/latex/md_Weather_Balloon_library_SparkFun_LSM9DS1_README.tex

\href{https://www.sparkfun.com/products/13284}{\tt }

{\itshape \href{https://www.sparkfun.com/products/13284}{\tt L\+S\+M9\+D\+S1 Breakout Board (S\+E\+N-\/13284)}}

This is a breakout board for ST Micro\textquotesingle{}s \hyperlink{class_l_s_m9_d_s1}{L\+S\+M9\+D\+S1} -- a 3D accelerometer, gyroscope, and magnetometer.

\subsection*{Repository Contents }

\begin{DoxyItemize}
\item $\ast$$\ast$/examples$\ast$$\ast$ -\/ Example sketches for the library (.ino). Run these from the Arduino I\+DE.
\item $\ast$$\ast$/extras$\ast$$\ast$ -\/ \hyperlink{class_l_s_m9_d_s1}{L\+S\+M9\+D\+S1} documentation.
\item $\ast$$\ast$/src$\ast$$\ast$ -\/ Source files for the library (.cpp, .h).
\item {\bfseries keywords.\+txt} -\/ Keywords from this library that will be highlighted in the Arduino I\+DE.
\item {\bfseries library.\+properties} -\/ General library properties for the Arduino package manager.
\end{DoxyItemize}

\subsection*{Documentation }

\begin{DoxyItemize}
\item {\bfseries \href{https://learn.sparkfun.com/tutorials/installing-an-arduino-library}{\tt Installing an Arduino Library Guide}} -\/ Basic information on how to install an Arduino library.
\item {\bfseries \href{https://github.com/sparkfun/LSM9DS1_Breakout}{\tt Product Repository}} -\/ Main repository (including hardware files) for the \hyperlink{class_l_s_m9_d_s1}{L\+S\+M9\+D\+S1} Breakout.
\item {\bfseries \href{https://learn.sparkfun.com/tutorials/lsm9ds1-breakout-hookup-guide}{\tt L\+S\+M9\+D\+S1 Breakout Hookup Guide}} -\/ Basic hookup guide for the \hyperlink{class_l_s_m9_d_s1}{L\+S\+M9\+D\+S1} Breakout.
\end{DoxyItemize}

\subsection*{Products that use this Library }

\begin{DoxyItemize}
\item \href{https://www.sparkfun.com/products/13284}{\tt L\+S\+M9\+D\+S1 Breakout Board (S\+E\+N-\/13284)}-\/ \hyperlink{class_l_s_m9_d_s1}{L\+S\+M9\+D\+S1} Breakout board.
\end{DoxyItemize}

\subsection*{Version History }

\begin{DoxyItemize}
\item \href{https://github.com/sparkfun/SparkFun_LSM9DS1_Arduino_Library/releases/tag/V_1.0.0}{\tt V 1.\+0.\+0} -\/ Initial release
\end{DoxyItemize}

\subsection*{License Information }

This product is \+\_\+$\ast$$\ast$open source$\ast$$\ast$\+\_\+!

The {\bfseries code} is beerware; if you see me (or any other Spark\+Fun employee) at the local, and you\textquotesingle{}ve found our code helpful, please buy us a round!

Please use, reuse, and modify these files as you see fit. Please maintain attribution to Spark\+Fun Electronics and release anything derivative under the same license.

Distributed as-\/is; no warranty is given.

\begin{DoxyItemize}
\item Your friends at Spark\+Fun. 
\end{DoxyItemize}
