rasusmilch/HAB/Weather_Balloon_Info/AVR/28Pins-Schematic-Page.pdf

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
D | D
C | C
B | B
A | A

Size:

Date:

DWG NO

Revision:

Sheet | of

Title:

Page Contents:

(c) 2015 FEDEVEL Academy

V1I1

[03] - 28PINS SCHEMATIC.SchDoc
3. 4. 2015

28Pins

3 | 5

[No Variations]

Variant:

Checked by

# 28PINS - SCHEMATIC

http://www.fedevel.com/academy

# 5VD-D+IDG 1234

10

5

86

97
11

J7
10118193-0001LF

USER_BUTTON_BUF

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
AD4/SDA

AD5/SCL

IO8

IO9

SS

MOSI

MISO

SCK

+AREF

+AREF

AD4/SDA

AD5/SCL

D4
Orange

D3
Orange

16U2_TX_LED
16U2_RX_LED

16U2_PB4

16U2_PB5

16U2_PB6

16U2_PB7

16U2_TXD
16U2_RXD

MOSI

D1
Green

# POWER LED

MISO
SCK
328P_RESETn

16U2_RESETn

SCK

16U2_RESETn

16U2_BUF_RESETn

D5
BAT54HT1G

16U2_RESETn

328P_RESETn

16U2_HDR_RESETn

1

2

3

4

SW2

1825910-6

C26
100n

R19
10k

C31
100n

C30
100n

R21
10k

C29
100n

C33
100n

C8
100n

C17
100n
1k | R11
1k | R10

R4
10k

R14
10k

C20
100n

C23
100n

C24
100n

+

1

2

C1
100u / 10V

+

1

2

C2
100u / 10V

+5V

1 | 2

FB2

MPZ2012S601AT000

1 1 | 2 2 | 3 3 | 4 4 | 5 5 | 6 6 | 7 7 | 8 8 | 9 9 | 10 10

J4

HDR FMALE 1x10 2.54mm

1 1 | 2 2 | 3 3 | 4 4 | 5 5 | 6 6 | 7 7 | 8 8

J3

HDR FMALE 1x8 2.54mm

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
SN74AHC1G09DBVR | AND
| 1
| 2

4

5

3

U7
SN74AHC1G09DBVR

AND

1

2

4

5

3

U4
SN74AHC1G09DBVR

328P_AUTORESETn

C11

100n

1k | R12

16U2PROG_328P_RESETn

16U2PROG_328P_RESETn

16U2_MOSI

16U2_MISO

16U2_SCLK

+5V | +3V3
| C16 100n

C15
100n
1 | 1
2 | 2
3 | 3
4 | 4
5 | 5
6 | 6
7 | 7
8 | 8

J1

HDR FMALE 1x8 2.54mm

C5
100n

C6
100n
1 | 2

FB1

MPZ2012S601AT000 | C3
10uF / 16V

C19
10uF / 16V

C21
10uF / 16V

C4
100n

+5V_USB

0R R8

C13
10uF / 16V
+5V | +3V3

328P_BUF_RESETn

D6
BAT54HT1G

328P_RESETn
1

2

3

4

SW1

1825910-6

R20
10k

C28
100n

C32
100n

AND

1

2

4

5

3

U6
SN74AHC1G09DBVR

328P_AUTORESETn

R18
10k
RESET (16U2) | RESET (328P) | USER BUTTON

# USER LED

328P

16U2

# 3V3 LDO

# micro USB

# POWER ICSP

JP3

# ICSP1

JP2

JP1

# IOH

AD

# IOL

IO8

328P_RESETn
16U2_PB4

328P_RESETn
+5V/3V3_328P_VCC

+5V/3V3_16U2

BUTTON_RESETn | USER_BUTTON

+3V3_16U2_UCAP

16U2_16MHZ_XTAL2

16U2_16MHZ_XTAL1

328P_16MHZ_XTAL1

328P_16MHZ_XTAL2

CON_USB_N

CON_USB_P

USB_N
USB_P

GND

1 1
2 2
3 3
4 4

JP3

HDR 1x4

1 1 | 2 | 2
3 3 | 4 | 4
5 5 | 6 | 6

J5

HDR 2x3

1 1 | 2 | 2
3 3 | 4 | 4
5 5 | 6 | 6

J6

HDR 2x3

R1
100k
22R | R6
22R | R7
1u | C7

Z1
CG0603MLC-05E

Z2
CG0603MLC-05E
16U2_SCLK_R | 22R | R5

### 28-DIP SOCKET

SCKT FOR U1

28-DIP Socket

# DIP SOCKET

# POWER PADS

J8

4MMx1.5MM

J9

4MMx1.5MM

+5V

# MOUNTING HOLES

BOARD MOUNTING HOLES

Mounting holes 7.4mm pad 3.2mm drill

MH1 | MH2 | MH3

ONE IN EACH CORNER

# FIDUCIALS

FID1 | FID2 | FID3 | FID4

FIDICIALS 4x TOP

1 1 | 2 | 2 3 3 | 4 | 4

JP2

HDR 2x2

1 1
2 2
3 3

JP1

HDR 1x3

LINK1

LINK

C22
10uF / 16V
1 | 2

FB3

MPZ2012S601AT000

+5V/3V3_328P_AVCC | SCK_R | 22R | R13

C14
100n

LINK2

LINK

# http://www.28pins.com

(c) 2015 Designed by FEDEVEL Academy http://www.fedevel.com/academy. Based on Arduino: http://www.arduino.cc. Released under Creative Commons Attribution-ShareAlike 3.0 Unported.
This means you can use it on your own derived works, in part or completely, as long as you also adopt the same licence. You find the complete text of the licence here.: http://creativecommons.org/licenses/by-sa/3.0/legalcode
Reset Button | User Button

## Differential pair

DESIGN NOTE:
This LED is inverted:
- SCK High = LED
OFF
- SCK Low = LED ON

DESIGN NOTE:
Pin 8 (VIN) is not
supported

DESIGN NOTE:

About JP3:
1) DebugWire support - Short 1&2. This was added to support possible debugWire debugging (programming?) of 328P through 16U2. In this case, the 16U2 needs to have a correct firmware and has to behave as a debugWire tool.
2) ISP programmer mode - Short 2&3. In this case, take a cable and connect J5 & J6 together. Upload AVRISP MKII firmware into 16U2 and you can program 328P. Example of AVRISP MKII firmware can be found at LUFA projects: http://www.fourwalledcubicle.com/LUFA.php (Tip: remap LEDs of the default AVRISP MKII LUFA project to the RX and TX LEDs on the 28Pin board)
3) ISP header - Short 3 & 4. In this mode, the ICSP1 header is used as a standard ISP header

DESIGN NOTE:

About JP1:
1) Autoreset Enabled - Short 1&2. In this case, 16U2 is used to reset 328P when firmware inside 328P is updated from Arduino IDE.
2) 16U2 DFU mode Enabled - Short 2&3. 16U2 HWB pin is sampled by 16U2 during RESET. If pulled low, then after Reset the 16U2 will go into DFU mode (it's the mode when you can flash 16U2 firmware through USB and Atmel Flip software: http://www.atmel.com/tools/flip.aspx ).
22R | R23 | 22R | R24 | 22R | R25

MH4

XTAL1 1

XTAL2 / PC0 2

GND 3

VCC 4

AIN2 / PCINT11 / PC2 | | | | | | | | 5
OC.0B / INT0 / PD0 | 6 AIN0 / INT1 / PD1 | 7 RXD1 / AIN1 / INT2 / PD2 | 8 TXD1 / INT3 / PD3 | 9 AIN3 / INT5 / PD4 | 10 XCK / AIN4 / PCINT12 / PD5 | 11 RTS / AIN5 / INT6 / PD6 | 12 CTS / HWB / T0 / AIN6 / INT7 / PD7 | 13
SS / PCINT0 / PB0 | 14 SCLK / PCINT1 / PB1 | 15 PDI / MOSI / PCINT2 / PB2 | 16 PDO / MISO / PCINT3 / PB3 | 17 T1 / PCINT4 / PB4 | 18 PCINT5 / PB5 | 19 PCINT6 / PB6 | 20 OC.0A / OC.1C / PCINT7 / PB7 | 21
CLKO / ICP1 / INT4 / PC7 | 22
OC.1A / PCINT8 / PC6 | 23

PC1 / RESET / DW 24

OC.1B / PCINT9 / PC5 | 25
PCINT10 / PC4 | 26

UCAP 27

UGND 28

D+ 29 | D- 30
UVCC 31 | AVCC 32

U2

ATMEGA16U2-AU

PC6 / PCINT14 / RESET 1

RXD / PCINT16 / PD0 | 2 TXD / PCINT17 / PD1 | 3 INT0 / PCINT18 / PD2 | 4 OC2B / INT1 / PCINT19 / PD3 | 5 XCK / T0 / PCINT20 / PD4 | 6

VCC 7

GND_1 8

PB6 / PCINT6 / TOSC1 / XTAL1 9

PB7 / PCINT7 / TOSC2 / XTAL2 10

OC0B / T1 / PCINT21 / PD5 | 11 OC0A / AIN0 / PCINT22 / PD6 | 12 AIN1 / PCINT23 / PD7 | 13
CLKO / ICP1 / PCINT0 / PB0 | 14 OC1A / PCINT1 / PB1 | 15 SS / OC1B / PCINT2 / PB2 | 16 MOSI / OC2A / PCINT3 / PB3 | 17 MISO / PCINT4 / PB4 | 18 SCK / PCINT5 / PB5 | 19 AVCC 20 | AREF 21

GND_2 22

PCINT8 / ADC0 / PC0 | 23 PCINT9 / ADC1 / PC1 | 24 PCINT10 / ADC2 / PC2 | 25 PCINT11 / ADC3 / PC3 | 26 SDA / PCINT12 / ADC4 / PC4 | 27 SCL / PCINT13 / ADC5 / PC5 | 28

U1

ATMEGA328P-PU

C34
10uF / 16V

+5V/3V3

+5V/3V3

+5V/3V3 | +5V/3V3 | +5V/3V3

+5V/3V3

+5V/3V3

+5V/3V3

+5V/3V3

+5V/3V3 | +5V/3V3
+5V/3V3 +5V/3V3 | +5V/3V3 | +5V/3V3 +5V/3V3

+5V/3V3

+5V/3V3 | +5V/3V3

+5V/3V3

+5V/3V3

+5V/3V3

+5V

C12
10uF / 16V

R17
560R

R15
560R

R2
560R

R3
560R
18p | C27
18p | C25
18p | C9
18p | C10

R26
0R NF | NF

+5V/3V3

SHDN 1

IN 2

GND 3

OUT | 4
SENSE | 5

EPAD 6

U3

TL1963A-33DCQR

560R R22

## Learn Schematic and PCB Design - ONLINE

+5V/3V3

1

1

2

2

3

3

JP4
HDR 1x3

# Power Selection

+5V | +5V/3V3 | +3V3 R27

0R

NF

R28
0RNF | DESIGN NOTE: This board can be powered from micro USB

connector (J7) or a single +3.3V power rail (through J1 pin 4). If +3.3V is used, fit R26 and R28. In this case, JP4 & R27 must NOT be fitted, otherwise the board may be damaged.

DESIGN NOTE:
This board supports 5V or 3V3 voltage level on the IO pins:
1) 5V IO - Fit everything as defined in this schematic. NF means, do not fit this component.
2) 3.3V IO - Remove R27, Fit R28, *Replace Y1 (change from 16MHz to 10MHz), *Replace Y2 (change from 16MHz to 8MHz).
3) Both 5V and 3V3, selected through JP4 - Remove R27, Remove R28, Fit JP4, *Replace Y1 (change from 16MHz to 10MHz), *Replace Y2 (change from 16MHz to 8MHz).

*Note: The 16MHz crystals are not recommended for 3.3V operation. We need to adjust their values, thatsh why the change.

IMPORTANT: Once you change the crystal value, you may need to re-compile your source code.

1 1 | 2 2 | 3 3 | 4 4 | 5 5 | 6 6

J2

HDR FMALE 1x6 2.54mm

LAYOUT NOTE:
1) Route all the POWER tracks with minimum track width 0.4mm.
2) Route all the other tracks by 0.4mm and change them by the end of the design to 0.2mm. To change all of them at once, use this filter "(not InNet('+*') and not InNet('GND')) and IsTrack and (OnLayer('L1') or OnLayer ('L2'))" and then set 0.2mm width in PCB Inspector panel.

Y2

ABM7-16.000MHZ-D2Y-T

Y1

ABM7-16.000MHZ-D2Y-T

L1
2u2 / 2A

D2
Orange
