rasusmilch/HAB/Weather_Balloon/Documentation/UML_Doxygen/latex/constants_8h.tex

\hypertarget{constants_8h}{}\section{Weather\+\_\+\+Balloon/library/\+Lib\+A\+P\+R\+S/constants.h File Reference}
\label{constants_8h}\index{Weather\+\_\+\+Balloon/library/\+Lib\+A\+P\+R\+S/constants.\+h@{Weather\+\_\+\+Balloon/library/\+Lib\+A\+P\+R\+S/constants.\+h}}
This graph shows which files directly or indirectly include this file\+:
\nopagebreak
\begin{figure}[H]
\begin{center}
\leavevmode
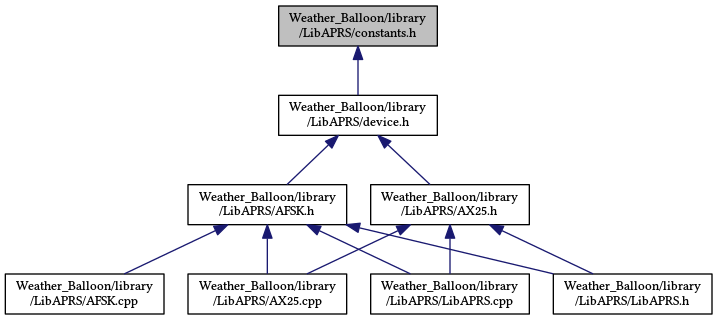
[picture p30: Weather_Balloon/Documentation/UML_Doxygen/html/constants_8h__dep__incl.png]

\end{center}
\end{figure}
\subsection*{Macros}
\begin{DoxyCompactItemize}
\item 
\#define \hyperlink{constants_8h_ab21c12c8b945e012e7cad672d64c6805}{m328p}~0x01
\item 
\#define \hyperlink{constants_8h_aea46a6aa09a8e59c584bbd10c9ec2cda}{m1284p}~0x02
\item 
\#define \hyperlink{constants_8h_a1cdf793c0063bc1d49ef376fa038f8a7}{m644p}~0x03
\item 
\#define \hyperlink{constants_8h_afb85aba9013ac48aedc1a81b7c2ff2ff}{R\+E\+F\+\_\+3\+V3}~0x01
\end{DoxyCompactItemize}

\subsection{Macro Definition Documentation}
\index{constants.\+h@{constants.\+h}!m1284p@{m1284p}}
\index{m1284p@{m1284p}!constants.\+h@{constants.\+h}}
\subsubsection[{\texorpdfstring{m1284p}{m1284p}}]{\setlength{\rightskip}{0pt plus 5cm}\#define m1284p~0x02}\hypertarget{constants_8h_aea46a6aa09a8e59c584bbd10c9ec2cda}{}\label{constants_8h_aea46a6aa09a8e59c584bbd10c9ec2cda}

Definition at line 2 of file constants.\+h.

\index{constants.\+h@{constants.\+h}!m328p@{m328p}}
\index{m328p@{m328p}!constants.\+h@{constants.\+h}}
\subsubsection[{\texorpdfstring{m328p}{m328p}}]{\setlength{\rightskip}{0pt plus 5cm}\#define m328p~0x01}\hypertarget{constants_8h_ab21c12c8b945e012e7cad672d64c6805}{}\label{constants_8h_ab21c12c8b945e012e7cad672d64c6805}

Definition at line 1 of file constants.\+h.

\index{constants.\+h@{constants.\+h}!m644p@{m644p}}
\index{m644p@{m644p}!constants.\+h@{constants.\+h}}
\subsubsection[{\texorpdfstring{m644p}{m644p}}]{\setlength{\rightskip}{0pt plus 5cm}\#define m644p~0x03}\hypertarget{constants_8h_a1cdf793c0063bc1d49ef376fa038f8a7}{}\label{constants_8h_a1cdf793c0063bc1d49ef376fa038f8a7}

Definition at line 3 of file constants.\+h.

\index{constants.\+h@{constants.\+h}!R\+E\+F\+\_\+3\+V3@{R\+E\+F\+\_\+3\+V3}}
\index{R\+E\+F\+\_\+3\+V3@{R\+E\+F\+\_\+3\+V3}!constants.\+h@{constants.\+h}}
\subsubsection[{\texorpdfstring{R\+E\+F\+\_\+3\+V3}{REF\_3V3}}]{\setlength{\rightskip}{0pt plus 5cm}\#define R\+E\+F\+\_\+3\+V3~0x01}\hypertarget{constants_8h_afb85aba9013ac48aedc1a81b7c2ff2ff}{}\label{constants_8h_afb85aba9013ac48aedc1a81b7c2ff2ff}

Definition at line 5 of file constants.\+h.
