rasusmilch/HAB/Weather_Balloon/Documentation/UML_Doxygen/latex/pgmspace_8h.tex

\hypertarget{pgmspace_8h}{}\section{Weather\+\_\+\+Balloon/library/\+Adafruit\+\_\+\+T\+S\+L2561-\/master/pgmspace.h File Reference}
\label{pgmspace_8h}\index{Weather\+\_\+\+Balloon/library/\+Adafruit\+\_\+\+T\+S\+L2561-\/master/pgmspace.\+h@{Weather\+\_\+\+Balloon/library/\+Adafruit\+\_\+\+T\+S\+L2561-\/master/pgmspace.\+h}}
{\ttfamily \#include $<$inttypes.\+h$>$}\\*
Include dependency graph for pgmspace.\+h\+:\nopagebreak
\begin{figure}[H]
\begin{center}
\leavevmode
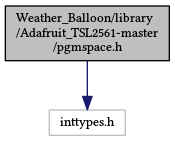
[picture p32: Weather_Balloon/Documentation/UML_Doxygen/html/pgmspace_8h__incl.png]

\end{center}
\end{figure}
This graph shows which files directly or indirectly include this file\+:\nopagebreak
\begin{figure}[H]
\begin{center}
\leavevmode
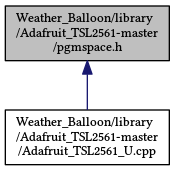
[picture p33: Weather_Balloon/Documentation/UML_Doxygen/html/pgmspace_8h__dep__incl.png]

\end{center}
\end{figure}
\subsection*{Macros}
\begin{DoxyCompactItemize}
\item 
\#define \hyperlink{pgmspace_8h_a75acaba9e781937468d0911423bc0c35}{P\+R\+O\+G\+M\+EM}
\item 
\#define \hyperlink{pgmspace_8h_a963f816fc88a5d8479c285ed4c630229}{P\+G\+M\+\_\+P}~const char $\ast$
\item 
\#define \hyperlink{pgmspace_8h_a73809107539df84eaf01f6a4dea4fbff}{P\+S\+TR}(str)~(str)
\item 
\#define \hyperlink{pgmspace_8h_ae74941b597bdd8ffb5c35f45b636946b}{strcpy\+\_\+P}(dest,  src)~strcpy((dest), (src))
\item 
\#define \hyperlink{pgmspace_8h_a2ca9304dda7dc2472812baa9e9ede965}{strcat\+\_\+P}(dest,  src)~strcat((dest), (src))
\item 
\#define \hyperlink{pgmspace_8h_abbb2cd396dde2d1575948bb16ce2853a}{strcmp\+\_\+P}(a,  b)~strcmp((a), (b))
\item 
\#define \hyperlink{pgmspace_8h_a48c60b057902adf805797f183286728d}{pgm\+\_\+read\+\_\+byte}(addr)~($\ast$(const unsigned char $\ast$)(addr))
\item 
\#define \hyperlink{pgmspace_8h_a910fb5f01313d339d3b835d45e1e5ad0}{pgm\+\_\+read\+\_\+word}(addr)~($\ast$(const unsigned short $\ast$)(addr))
\item 
\#define \hyperlink{pgmspace_8h_a73cf3e57e32321cb193b3cc4b041cc6c}{pgm\+\_\+read\+\_\+dword}(addr)~($\ast$(const unsigned long $\ast$)(addr))
\item 
\#define \hyperlink{pgmspace_8h_a334426a3824fc08cee3a557ded696128}{pgm\+\_\+read\+\_\+float}(addr)~($\ast$(const float $\ast$)(addr))
\item 
\#define \hyperlink{pgmspace_8h_ad2b71a6faa0583b51569b531a443cb0a}{pgm\+\_\+read\+\_\+byte\+\_\+near}(addr)~\hyperlink{_date_strings_8cpp_a48c60b057902adf805797f183286728d}{pgm\+\_\+read\+\_\+byte}(addr)
\item 
\#define \hyperlink{pgmspace_8h_a515a845ea5139d8cf1c7f09ad6dad243}{pgm\+\_\+read\+\_\+word\+\_\+near}(addr)~\hyperlink{_date_strings_8cpp_a910fb5f01313d339d3b835d45e1e5ad0}{pgm\+\_\+read\+\_\+word}(addr)
\item 
\#define \hyperlink{pgmspace_8h_a27619bf0e01033f6049a11a6d5d754f3}{pgm\+\_\+read\+\_\+dword\+\_\+near}(addr)~\hyperlink{pgmspace_8h_a73cf3e57e32321cb193b3cc4b041cc6c}{pgm\+\_\+read\+\_\+dword}(addr)
\item 
\#define \hyperlink{pgmspace_8h_a93b33ee6ceaf1dd3ebcfa6f4c96f8b27}{pgm\+\_\+read\+\_\+float\+\_\+near}(addr)~\hyperlink{pgmspace_8h_a334426a3824fc08cee3a557ded696128}{pgm\+\_\+read\+\_\+float}(addr)
\item 
\#define \hyperlink{pgmspace_8h_a96c2bf865e6b08ed5f881ad25f5d47d4}{pgm\+\_\+read\+\_\+byte\+\_\+far}(addr)~\hyperlink{_date_strings_8cpp_a48c60b057902adf805797f183286728d}{pgm\+\_\+read\+\_\+byte}(addr)
\item 
\#define \hyperlink{pgmspace_8h_a3aaf70e2e58f5749ccbcd36032b1d1b3}{pgm\+\_\+read\+\_\+word\+\_\+far}(addr)~\hyperlink{_date_strings_8cpp_a910fb5f01313d339d3b835d45e1e5ad0}{pgm\+\_\+read\+\_\+word}(addr)
\item 
\#define \hyperlink{pgmspace_8h_a2829b030e67c660d451045dd1ee6b1e9}{pgm\+\_\+read\+\_\+dword\+\_\+far}(addr)~\hyperlink{pgmspace_8h_a73cf3e57e32321cb193b3cc4b041cc6c}{pgm\+\_\+read\+\_\+dword}(addr)
\item 
\#define \hyperlink{pgmspace_8h_ac9201560d03a0cfa240d0421a22c74d1}{pgm\+\_\+read\+\_\+float\+\_\+far}(addr)~\hyperlink{pgmspace_8h_a334426a3824fc08cee3a557ded696128}{pgm\+\_\+read\+\_\+float}(addr)
\end{DoxyCompactItemize}
\subsection*{Typedefs}
\begin{DoxyCompactItemize}
\item 
typedef void \hyperlink{pgmspace_8h_a132cade895232da163e344f296267817}{prog\+\_\+void}
\item 
typedef char \hyperlink{pgmspace_8h_a8c58c1a4bc98cdbf19a2a070cf889524}{prog\+\_\+char}
\item 
typedef unsigned char \hyperlink{pgmspace_8h_a5c79ab4508e17a83c5d89c787cbd6774}{prog\+\_\+uchar}
\item 
typedef int8\+\_\+t \hyperlink{pgmspace_8h_ae2aefb42a042fa5cb20e06f7fcfa327e}{prog\+\_\+int8\+\_\+t}
\item 
typedef uint8\+\_\+t \hyperlink{pgmspace_8h_a1292f2f164a1997206e9cf714f2372fe}{prog\+\_\+uint8\+\_\+t}
\item 
typedef int16\+\_\+t \hyperlink{pgmspace_8h_a8a3c5c6e2c14ced6f6bb5c68ffc70082}{prog\+\_\+int16\+\_\+t}
\item 
typedef uint16\+\_\+t \hyperlink{pgmspace_8h_a05ca2f20b55933ad782917161d54287d}{prog\+\_\+uint16\+\_\+t}
\item 
typedef int32\+\_\+t \hyperlink{pgmspace_8h_a9d67538d7ddfd038ce8b0068d03dd679}{prog\+\_\+int32\+\_\+t}
\item 
typedef uint32\+\_\+t \hyperlink{pgmspace_8h_a0756e93e3e7d572f24952cbd8e35b158}{prog\+\_\+uint32\+\_\+t}
\end{DoxyCompactItemize}

\subsection{Detailed Description}
\begin{DoxyAuthor}{Author}
Mike Roberts
\end{DoxyAuthor}
\hypertarget{pgmspace_8h_LICENSE}{}\subsection{L\+I\+C\+E\+N\+SE}\label{pgmspace_8h_LICENSE}
Software License Agreement (B\+SD License)

Copyright (c) 2013, Mike Roberts All rights reserved.

Redistribution and use in source and binary forms, with or without modification, are permitted provided that the following conditions are met\+:
\begin{DoxyEnumerate}
\item Redistributions of source code must retain the above copyright notice, this list of conditions and the following disclaimer.
\item Redistributions in binary form must reproduce the above copyright notice, this list of conditions and the following disclaimer in the documentation and/or other materials provided with the distribution.
\item Neither the name of the copyright holders nor the names of its contributors may be used to endorse or promote products derived from this software without specific prior written permission.
\end{DoxyEnumerate}

T\+H\+IS S\+O\+F\+T\+W\+A\+RE IS P\+R\+O\+V\+I\+D\+ED BY T\+HE C\+O\+P\+Y\+R\+I\+G\+HT H\+O\+L\+D\+E\+RS \textquotesingle{}\textquotesingle{}AS IS\textquotesingle{}\textquotesingle{} A\+ND A\+NY E\+X\+P\+R\+E\+SS OR I\+M\+P\+L\+I\+ED W\+A\+R\+R\+A\+N\+T\+I\+ES, I\+N\+C\+L\+U\+D\+I\+NG, B\+UT N\+OT L\+I\+M\+I\+T\+ED TO, T\+HE I\+M\+P\+L\+I\+ED W\+A\+R\+R\+A\+N\+T\+I\+ES OF M\+E\+R\+C\+H\+A\+N\+T\+A\+B\+I\+L\+I\+TY A\+ND F\+I\+T\+N\+E\+SS F\+OR A P\+A\+R\+T\+I\+C\+U\+L\+AR P\+U\+R\+P\+O\+SE A\+RE D\+I\+S\+C\+L\+A\+I\+M\+ED. IN NO E\+V\+E\+NT S\+H\+A\+LL T\+HE C\+O\+P\+Y\+R\+I\+G\+HT H\+O\+L\+D\+ER BE L\+I\+A\+B\+LE F\+OR A\+NY D\+I\+R\+E\+CT, I\+N\+D\+I\+R\+E\+CT, I\+N\+C\+I\+D\+E\+N\+T\+AL, S\+P\+E\+C\+I\+AL, E\+X\+E\+M\+P\+L\+A\+RY, OR C\+O\+N\+S\+E\+Q\+U\+E\+N\+T\+I\+AL D\+A\+M\+A\+G\+ES (I\+N\+C\+L\+U\+D\+I\+NG, B\+UT N\+OT L\+I\+M\+I\+T\+ED TO, P\+R\+O\+C\+U\+R\+E\+M\+E\+NT OF S\+U\+B\+S\+T\+I\+T\+U\+TE G\+O\+O\+DS OR S\+E\+R\+V\+I\+C\+ES; L\+O\+SS OF U\+SE, D\+A\+TA, OR P\+R\+O\+F\+I\+TS; OR B\+U\+S\+I\+N\+E\+SS I\+N\+T\+E\+R\+R\+U\+P\+T\+I\+ON) H\+O\+W\+E\+V\+ER C\+A\+U\+S\+ED A\+ND ON A\+NY T\+H\+E\+O\+RY OF L\+I\+A\+B\+I\+L\+I\+TY, W\+H\+E\+T\+H\+ER IN C\+O\+N\+T\+R\+A\+CT, S\+T\+R\+I\+CT L\+I\+A\+B\+I\+L\+I\+TY, OR T\+O\+RT (I\+N\+C\+L\+U\+D\+I\+NG N\+E\+G\+L\+I\+G\+E\+N\+CE OR O\+T\+H\+E\+R\+W\+I\+SE) A\+R\+I\+S\+I\+NG IN A\+NY W\+AY O\+UT OF T\+HE U\+SE OF T\+H\+IS S\+O\+F\+T\+W\+A\+RE, E\+V\+EN IF A\+D\+V\+I\+S\+ED OF T\+HE P\+O\+S\+S\+I\+B\+I\+L\+I\+TY OF S\+U\+CH D\+A\+M\+A\+GE. 

\subsection{Macro Definition Documentation}
\index{pgmspace.\+h@{pgmspace.\+h}!P\+G\+M\+\_\+P@{P\+G\+M\+\_\+P}}
\index{P\+G\+M\+\_\+P@{P\+G\+M\+\_\+P}!pgmspace.\+h@{pgmspace.\+h}}
\subsubsection[{\texorpdfstring{P\+G\+M\+\_\+P}{PGM\_P}}]{\setlength{\rightskip}{0pt plus 5cm}\#define P\+G\+M\+\_\+P~const char $\ast$}\hypertarget{pgmspace_8h_a963f816fc88a5d8479c285ed4c630229}{}\label{pgmspace_8h_a963f816fc88a5d8479c285ed4c630229}

Definition at line 43 of file pgmspace.\+h.

\index{pgmspace.\+h@{pgmspace.\+h}!pgm\+\_\+read\+\_\+byte@{pgm\+\_\+read\+\_\+byte}}
\index{pgm\+\_\+read\+\_\+byte@{pgm\+\_\+read\+\_\+byte}!pgmspace.\+h@{pgmspace.\+h}}
\subsubsection[{\texorpdfstring{pgm\+\_\+read\+\_\+byte}{pgm\_read\_byte}}]{\setlength{\rightskip}{0pt plus 5cm}\#define pgm\+\_\+read\+\_\+byte(
\begin{DoxyParamCaption}
\item[{}]{addr}
\end{DoxyParamCaption}
)~($\ast$(const unsigned char $\ast$)(addr))}\hypertarget{pgmspace_8h_a48c60b057902adf805797f183286728d}{}\label{pgmspace_8h_a48c60b057902adf805797f183286728d}

Definition at line 60 of file pgmspace.\+h.

Referenced by One\+Wire\+::crc8(), Date\+Time\+::\+Date\+Time(), D\+S3231\+::is\+Alarm2(), and D\+S3231\+::set\+Date\+Time().

\index{pgmspace.\+h@{pgmspace.\+h}!pgm\+\_\+read\+\_\+byte\+\_\+far@{pgm\+\_\+read\+\_\+byte\+\_\+far}}
\index{pgm\+\_\+read\+\_\+byte\+\_\+far@{pgm\+\_\+read\+\_\+byte\+\_\+far}!pgmspace.\+h@{pgmspace.\+h}}
\subsubsection[{\texorpdfstring{pgm\+\_\+read\+\_\+byte\+\_\+far}{pgm\_read\_byte\_far}}]{\setlength{\rightskip}{0pt plus 5cm}\#define pgm\+\_\+read\+\_\+byte\+\_\+far(
\begin{DoxyParamCaption}
\item[{}]{addr}
\end{DoxyParamCaption}
)~{\bf pgm\+\_\+read\+\_\+byte}(addr)}\hypertarget{pgmspace_8h_a96c2bf865e6b08ed5f881ad25f5d47d4}{}\label{pgmspace_8h_a96c2bf865e6b08ed5f881ad25f5d47d4}

Definition at line 69 of file pgmspace.\+h.

\index{pgmspace.\+h@{pgmspace.\+h}!pgm\+\_\+read\+\_\+byte\+\_\+near@{pgm\+\_\+read\+\_\+byte\+\_\+near}}
\index{pgm\+\_\+read\+\_\+byte\+\_\+near@{pgm\+\_\+read\+\_\+byte\+\_\+near}!pgmspace.\+h@{pgmspace.\+h}}
\subsubsection[{\texorpdfstring{pgm\+\_\+read\+\_\+byte\+\_\+near}{pgm\_read\_byte\_near}}]{\setlength{\rightskip}{0pt plus 5cm}\#define pgm\+\_\+read\+\_\+byte\+\_\+near(
\begin{DoxyParamCaption}
\item[{}]{addr}
\end{DoxyParamCaption}
)~{\bf pgm\+\_\+read\+\_\+byte}(addr)}\hypertarget{pgmspace_8h_ad2b71a6faa0583b51569b531a443cb0a}{}\label{pgmspace_8h_ad2b71a6faa0583b51569b531a443cb0a}

Definition at line 65 of file pgmspace.\+h.

Referenced by Led\+Control\+::set\+Char(), and Led\+Control\+::set\+Digit().

\index{pgmspace.\+h@{pgmspace.\+h}!pgm\+\_\+read\+\_\+dword@{pgm\+\_\+read\+\_\+dword}}
\index{pgm\+\_\+read\+\_\+dword@{pgm\+\_\+read\+\_\+dword}!pgmspace.\+h@{pgmspace.\+h}}
\subsubsection[{\texorpdfstring{pgm\+\_\+read\+\_\+dword}{pgm\_read\_dword}}]{\setlength{\rightskip}{0pt plus 5cm}\#define pgm\+\_\+read\+\_\+dword(
\begin{DoxyParamCaption}
\item[{}]{addr}
\end{DoxyParamCaption}
)~($\ast$(const unsigned long $\ast$)(addr))}\hypertarget{pgmspace_8h_a73cf3e57e32321cb193b3cc4b041cc6c}{}\label{pgmspace_8h_a73cf3e57e32321cb193b3cc4b041cc6c}

Definition at line 62 of file pgmspace.\+h.

\index{pgmspace.\+h@{pgmspace.\+h}!pgm\+\_\+read\+\_\+dword\+\_\+far@{pgm\+\_\+read\+\_\+dword\+\_\+far}}
\index{pgm\+\_\+read\+\_\+dword\+\_\+far@{pgm\+\_\+read\+\_\+dword\+\_\+far}!pgmspace.\+h@{pgmspace.\+h}}
\subsubsection[{\texorpdfstring{pgm\+\_\+read\+\_\+dword\+\_\+far}{pgm\_read\_dword\_far}}]{\setlength{\rightskip}{0pt plus 5cm}\#define pgm\+\_\+read\+\_\+dword\+\_\+far(
\begin{DoxyParamCaption}
\item[{}]{addr}
\end{DoxyParamCaption}
)~{\bf pgm\+\_\+read\+\_\+dword}(addr)}\hypertarget{pgmspace_8h_a2829b030e67c660d451045dd1ee6b1e9}{}\label{pgmspace_8h_a2829b030e67c660d451045dd1ee6b1e9}

Definition at line 71 of file pgmspace.\+h.

\index{pgmspace.\+h@{pgmspace.\+h}!pgm\+\_\+read\+\_\+dword\+\_\+near@{pgm\+\_\+read\+\_\+dword\+\_\+near}}
\index{pgm\+\_\+read\+\_\+dword\+\_\+near@{pgm\+\_\+read\+\_\+dword\+\_\+near}!pgmspace.\+h@{pgmspace.\+h}}
\subsubsection[{\texorpdfstring{pgm\+\_\+read\+\_\+dword\+\_\+near}{pgm\_read\_dword\_near}}]{\setlength{\rightskip}{0pt plus 5cm}\#define pgm\+\_\+read\+\_\+dword\+\_\+near(
\begin{DoxyParamCaption}
\item[{}]{addr}
\end{DoxyParamCaption}
)~{\bf pgm\+\_\+read\+\_\+dword}(addr)}\hypertarget{pgmspace_8h_a27619bf0e01033f6049a11a6d5d754f3}{}\label{pgmspace_8h_a27619bf0e01033f6049a11a6d5d754f3}

Definition at line 67 of file pgmspace.\+h.

\index{pgmspace.\+h@{pgmspace.\+h}!pgm\+\_\+read\+\_\+float@{pgm\+\_\+read\+\_\+float}}
\index{pgm\+\_\+read\+\_\+float@{pgm\+\_\+read\+\_\+float}!pgmspace.\+h@{pgmspace.\+h}}
\subsubsection[{\texorpdfstring{pgm\+\_\+read\+\_\+float}{pgm\_read\_float}}]{\setlength{\rightskip}{0pt plus 5cm}\#define pgm\+\_\+read\+\_\+float(
\begin{DoxyParamCaption}
\item[{}]{addr}
\end{DoxyParamCaption}
)~($\ast$(const float $\ast$)(addr))}\hypertarget{pgmspace_8h_a334426a3824fc08cee3a557ded696128}{}\label{pgmspace_8h_a334426a3824fc08cee3a557ded696128}

Definition at line 63 of file pgmspace.\+h.

\index{pgmspace.\+h@{pgmspace.\+h}!pgm\+\_\+read\+\_\+float\+\_\+far@{pgm\+\_\+read\+\_\+float\+\_\+far}}
\index{pgm\+\_\+read\+\_\+float\+\_\+far@{pgm\+\_\+read\+\_\+float\+\_\+far}!pgmspace.\+h@{pgmspace.\+h}}
\subsubsection[{\texorpdfstring{pgm\+\_\+read\+\_\+float\+\_\+far}{pgm\_read\_float\_far}}]{\setlength{\rightskip}{0pt plus 5cm}\#define pgm\+\_\+read\+\_\+float\+\_\+far(
\begin{DoxyParamCaption}
\item[{}]{addr}
\end{DoxyParamCaption}
)~{\bf pgm\+\_\+read\+\_\+float}(addr)}\hypertarget{pgmspace_8h_ac9201560d03a0cfa240d0421a22c74d1}{}\label{pgmspace_8h_ac9201560d03a0cfa240d0421a22c74d1}

Definition at line 72 of file pgmspace.\+h.

\index{pgmspace.\+h@{pgmspace.\+h}!pgm\+\_\+read\+\_\+float\+\_\+near@{pgm\+\_\+read\+\_\+float\+\_\+near}}
\index{pgm\+\_\+read\+\_\+float\+\_\+near@{pgm\+\_\+read\+\_\+float\+\_\+near}!pgmspace.\+h@{pgmspace.\+h}}
\subsubsection[{\texorpdfstring{pgm\+\_\+read\+\_\+float\+\_\+near}{pgm\_read\_float\_near}}]{\setlength{\rightskip}{0pt plus 5cm}\#define pgm\+\_\+read\+\_\+float\+\_\+near(
\begin{DoxyParamCaption}
\item[{}]{addr}
\end{DoxyParamCaption}
)~{\bf pgm\+\_\+read\+\_\+float}(addr)}\hypertarget{pgmspace_8h_a93b33ee6ceaf1dd3ebcfa6f4c96f8b27}{}\label{pgmspace_8h_a93b33ee6ceaf1dd3ebcfa6f4c96f8b27}

Definition at line 68 of file pgmspace.\+h.

\index{pgmspace.\+h@{pgmspace.\+h}!pgm\+\_\+read\+\_\+word@{pgm\+\_\+read\+\_\+word}}
\index{pgm\+\_\+read\+\_\+word@{pgm\+\_\+read\+\_\+word}!pgmspace.\+h@{pgmspace.\+h}}
\subsubsection[{\texorpdfstring{pgm\+\_\+read\+\_\+word}{pgm\_read\_word}}]{\setlength{\rightskip}{0pt plus 5cm}\#define pgm\+\_\+read\+\_\+word(
\begin{DoxyParamCaption}
\item[{}]{addr}
\end{DoxyParamCaption}
)~($\ast$(const unsigned short $\ast$)(addr))}\hypertarget{pgmspace_8h_a910fb5f01313d339d3b835d45e1e5ad0}{}\label{pgmspace_8h_a910fb5f01313d339d3b835d45e1e5ad0}

Definition at line 61 of file pgmspace.\+h.

\index{pgmspace.\+h@{pgmspace.\+h}!pgm\+\_\+read\+\_\+word\+\_\+far@{pgm\+\_\+read\+\_\+word\+\_\+far}}
\index{pgm\+\_\+read\+\_\+word\+\_\+far@{pgm\+\_\+read\+\_\+word\+\_\+far}!pgmspace.\+h@{pgmspace.\+h}}
\subsubsection[{\texorpdfstring{pgm\+\_\+read\+\_\+word\+\_\+far}{pgm\_read\_word\_far}}]{\setlength{\rightskip}{0pt plus 5cm}\#define pgm\+\_\+read\+\_\+word\+\_\+far(
\begin{DoxyParamCaption}
\item[{}]{addr}
\end{DoxyParamCaption}
)~{\bf pgm\+\_\+read\+\_\+word}(addr)}\hypertarget{pgmspace_8h_a3aaf70e2e58f5749ccbcd36032b1d1b3}{}\label{pgmspace_8h_a3aaf70e2e58f5749ccbcd36032b1d1b3}

Definition at line 70 of file pgmspace.\+h.

\index{pgmspace.\+h@{pgmspace.\+h}!pgm\+\_\+read\+\_\+word\+\_\+near@{pgm\+\_\+read\+\_\+word\+\_\+near}}
\index{pgm\+\_\+read\+\_\+word\+\_\+near@{pgm\+\_\+read\+\_\+word\+\_\+near}!pgmspace.\+h@{pgmspace.\+h}}
\subsubsection[{\texorpdfstring{pgm\+\_\+read\+\_\+word\+\_\+near}{pgm\_read\_word\_near}}]{\setlength{\rightskip}{0pt plus 5cm}\#define pgm\+\_\+read\+\_\+word\+\_\+near(
\begin{DoxyParamCaption}
\item[{}]{addr}
\end{DoxyParamCaption}
)~{\bf pgm\+\_\+read\+\_\+word}(addr)}\hypertarget{pgmspace_8h_a515a845ea5139d8cf1c7f09ad6dad243}{}\label{pgmspace_8h_a515a845ea5139d8cf1c7f09ad6dad243}

Definition at line 66 of file pgmspace.\+h.

\index{pgmspace.\+h@{pgmspace.\+h}!P\+R\+O\+G\+M\+EM@{P\+R\+O\+G\+M\+EM}}
\index{P\+R\+O\+G\+M\+EM@{P\+R\+O\+G\+M\+EM}!pgmspace.\+h@{pgmspace.\+h}}
\subsubsection[{\texorpdfstring{P\+R\+O\+G\+M\+EM}{PROGMEM}}]{\setlength{\rightskip}{0pt plus 5cm}\#define P\+R\+O\+G\+M\+EM}\hypertarget{pgmspace_8h_a75acaba9e781937468d0911423bc0c35}{}\label{pgmspace_8h_a75acaba9e781937468d0911423bc0c35}

Definition at line 42 of file pgmspace.\+h.

Referenced by One\+Wire\+::search().

\index{pgmspace.\+h@{pgmspace.\+h}!P\+S\+TR@{P\+S\+TR}}
\index{P\+S\+TR@{P\+S\+TR}!pgmspace.\+h@{pgmspace.\+h}}
\subsubsection[{\texorpdfstring{P\+S\+TR}{PSTR}}]{\setlength{\rightskip}{0pt plus 5cm}\#define P\+S\+TR(
\begin{DoxyParamCaption}
\item[{}]{str}
\end{DoxyParamCaption}
)~(str)}\hypertarget{pgmspace_8h_a73809107539df84eaf01f6a4dea4fbff}{}\label{pgmspace_8h_a73809107539df84eaf01f6a4dea4fbff}

Definition at line 44 of file pgmspace.\+h.

\index{pgmspace.\+h@{pgmspace.\+h}!strcat\+\_\+P@{strcat\+\_\+P}}
\index{strcat\+\_\+P@{strcat\+\_\+P}!pgmspace.\+h@{pgmspace.\+h}}
\subsubsection[{\texorpdfstring{strcat\+\_\+P}{strcat\_P}}]{\setlength{\rightskip}{0pt plus 5cm}\#define strcat\+\_\+P(
\begin{DoxyParamCaption}
\item[{}]{dest, }
\item[{}]{src}
\end{DoxyParamCaption}
)~strcat((dest), (src))}\hypertarget{pgmspace_8h_a2ca9304dda7dc2472812baa9e9ede965}{}\label{pgmspace_8h_a2ca9304dda7dc2472812baa9e9ede965}

Definition at line 57 of file pgmspace.\+h.

\index{pgmspace.\+h@{pgmspace.\+h}!strcmp\+\_\+P@{strcmp\+\_\+P}}
\index{strcmp\+\_\+P@{strcmp\+\_\+P}!pgmspace.\+h@{pgmspace.\+h}}
\subsubsection[{\texorpdfstring{strcmp\+\_\+P}{strcmp\_P}}]{\setlength{\rightskip}{0pt plus 5cm}\#define strcmp\+\_\+P(
\begin{DoxyParamCaption}
\item[{}]{a, }
\item[{}]{b}
\end{DoxyParamCaption}
)~strcmp((a), (b))}\hypertarget{pgmspace_8h_abbb2cd396dde2d1575948bb16ce2853a}{}\label{pgmspace_8h_abbb2cd396dde2d1575948bb16ce2853a}

Definition at line 58 of file pgmspace.\+h.

\index{pgmspace.\+h@{pgmspace.\+h}!strcpy\+\_\+P@{strcpy\+\_\+P}}
\index{strcpy\+\_\+P@{strcpy\+\_\+P}!pgmspace.\+h@{pgmspace.\+h}}
\subsubsection[{\texorpdfstring{strcpy\+\_\+P}{strcpy\_P}}]{\setlength{\rightskip}{0pt plus 5cm}\#define strcpy\+\_\+P(
\begin{DoxyParamCaption}
\item[{}]{dest, }
\item[{}]{src}
\end{DoxyParamCaption}
)~strcpy((dest), (src))}\hypertarget{pgmspace_8h_ae74941b597bdd8ffb5c35f45b636946b}{}\label{pgmspace_8h_ae74941b597bdd8ffb5c35f45b636946b}

Definition at line 56 of file pgmspace.\+h.

\subsection{Typedef Documentation}
\index{pgmspace.\+h@{pgmspace.\+h}!prog\+\_\+char@{prog\+\_\+char}}
\index{prog\+\_\+char@{prog\+\_\+char}!pgmspace.\+h@{pgmspace.\+h}}
\subsubsection[{\texorpdfstring{prog\+\_\+char}{prog\_char}}]{\setlength{\rightskip}{0pt plus 5cm}typedef char {\bf prog\+\_\+char}}\hypertarget{pgmspace_8h_a8c58c1a4bc98cdbf19a2a070cf889524}{}\label{pgmspace_8h_a8c58c1a4bc98cdbf19a2a070cf889524}

Definition at line 47 of file pgmspace.\+h.

\index{pgmspace.\+h@{pgmspace.\+h}!prog\+\_\+int16\+\_\+t@{prog\+\_\+int16\+\_\+t}}
\index{prog\+\_\+int16\+\_\+t@{prog\+\_\+int16\+\_\+t}!pgmspace.\+h@{pgmspace.\+h}}
\subsubsection[{\texorpdfstring{prog\+\_\+int16\+\_\+t}{prog\_int16\_t}}]{\setlength{\rightskip}{0pt plus 5cm}typedef int16\+\_\+t {\bf prog\+\_\+int16\+\_\+t}}\hypertarget{pgmspace_8h_a8a3c5c6e2c14ced6f6bb5c68ffc70082}{}\label{pgmspace_8h_a8a3c5c6e2c14ced6f6bb5c68ffc70082}

Definition at line 51 of file pgmspace.\+h.

\index{pgmspace.\+h@{pgmspace.\+h}!prog\+\_\+int32\+\_\+t@{prog\+\_\+int32\+\_\+t}}
\index{prog\+\_\+int32\+\_\+t@{prog\+\_\+int32\+\_\+t}!pgmspace.\+h@{pgmspace.\+h}}
\subsubsection[{\texorpdfstring{prog\+\_\+int32\+\_\+t}{prog\_int32\_t}}]{\setlength{\rightskip}{0pt plus 5cm}typedef int32\+\_\+t {\bf prog\+\_\+int32\+\_\+t}}\hypertarget{pgmspace_8h_a9d67538d7ddfd038ce8b0068d03dd679}{}\label{pgmspace_8h_a9d67538d7ddfd038ce8b0068d03dd679}

Definition at line 53 of file pgmspace.\+h.

\index{pgmspace.\+h@{pgmspace.\+h}!prog\+\_\+int8\+\_\+t@{prog\+\_\+int8\+\_\+t}}
\index{prog\+\_\+int8\+\_\+t@{prog\+\_\+int8\+\_\+t}!pgmspace.\+h@{pgmspace.\+h}}
\subsubsection[{\texorpdfstring{prog\+\_\+int8\+\_\+t}{prog\_int8\_t}}]{\setlength{\rightskip}{0pt plus 5cm}typedef int8\+\_\+t {\bf prog\+\_\+int8\+\_\+t}}\hypertarget{pgmspace_8h_ae2aefb42a042fa5cb20e06f7fcfa327e}{}\label{pgmspace_8h_ae2aefb42a042fa5cb20e06f7fcfa327e}

Definition at line 49 of file pgmspace.\+h.

\index{pgmspace.\+h@{pgmspace.\+h}!prog\+\_\+uchar@{prog\+\_\+uchar}}
\index{prog\+\_\+uchar@{prog\+\_\+uchar}!pgmspace.\+h@{pgmspace.\+h}}
\subsubsection[{\texorpdfstring{prog\+\_\+uchar}{prog\_uchar}}]{\setlength{\rightskip}{0pt plus 5cm}typedef unsigned char {\bf prog\+\_\+uchar}}\hypertarget{pgmspace_8h_a5c79ab4508e17a83c5d89c787cbd6774}{}\label{pgmspace_8h_a5c79ab4508e17a83c5d89c787cbd6774}

Definition at line 48 of file pgmspace.\+h.

\index{pgmspace.\+h@{pgmspace.\+h}!prog\+\_\+uint16\+\_\+t@{prog\+\_\+uint16\+\_\+t}}
\index{prog\+\_\+uint16\+\_\+t@{prog\+\_\+uint16\+\_\+t}!pgmspace.\+h@{pgmspace.\+h}}
\subsubsection[{\texorpdfstring{prog\+\_\+uint16\+\_\+t}{prog\_uint16\_t}}]{\setlength{\rightskip}{0pt plus 5cm}typedef uint16\+\_\+t {\bf prog\+\_\+uint16\+\_\+t}}\hypertarget{pgmspace_8h_a05ca2f20b55933ad782917161d54287d}{}\label{pgmspace_8h_a05ca2f20b55933ad782917161d54287d}

Definition at line 52 of file pgmspace.\+h.

\index{pgmspace.\+h@{pgmspace.\+h}!prog\+\_\+uint32\+\_\+t@{prog\+\_\+uint32\+\_\+t}}
\index{prog\+\_\+uint32\+\_\+t@{prog\+\_\+uint32\+\_\+t}!pgmspace.\+h@{pgmspace.\+h}}
\subsubsection[{\texorpdfstring{prog\+\_\+uint32\+\_\+t}{prog\_uint32\_t}}]{\setlength{\rightskip}{0pt plus 5cm}typedef uint32\+\_\+t {\bf prog\+\_\+uint32\+\_\+t}}\hypertarget{pgmspace_8h_a0756e93e3e7d572f24952cbd8e35b158}{}\label{pgmspace_8h_a0756e93e3e7d572f24952cbd8e35b158}

Definition at line 54 of file pgmspace.\+h.

\index{pgmspace.\+h@{pgmspace.\+h}!prog\+\_\+uint8\+\_\+t@{prog\+\_\+uint8\+\_\+t}}
\index{prog\+\_\+uint8\+\_\+t@{prog\+\_\+uint8\+\_\+t}!pgmspace.\+h@{pgmspace.\+h}}
\subsubsection[{\texorpdfstring{prog\+\_\+uint8\+\_\+t}{prog\_uint8\_t}}]{\setlength{\rightskip}{0pt plus 5cm}typedef uint8\+\_\+t {\bf prog\+\_\+uint8\+\_\+t}}\hypertarget{pgmspace_8h_a1292f2f164a1997206e9cf714f2372fe}{}\label{pgmspace_8h_a1292f2f164a1997206e9cf714f2372fe}

Definition at line 50 of file pgmspace.\+h.

\index{pgmspace.\+h@{pgmspace.\+h}!prog\+\_\+void@{prog\+\_\+void}}
\index{prog\+\_\+void@{prog\+\_\+void}!pgmspace.\+h@{pgmspace.\+h}}
\subsubsection[{\texorpdfstring{prog\+\_\+void}{prog\_void}}]{\setlength{\rightskip}{0pt plus 5cm}typedef void {\bf prog\+\_\+void}}\hypertarget{pgmspace_8h_a132cade895232da163e344f296267817}{}\label{pgmspace_8h_a132cade895232da163e344f296267817}

Definition at line 46 of file pgmspace.\+h.
