rasusmilch/HAB/Weather_Balloon/Documentation/UML_Doxygen/latex/unioncsd__t.tex

\hypertarget{unioncsd__t}{}\section{csd\+\_\+t Union Reference}
\label{unioncsd__t}\index{csd\+\_\+t@{csd\+\_\+t}}

{\ttfamily \#include $<$Sd\+Info.\+h$>$}

Collaboration diagram for csd\+\_\+t\+:\nopagebreak
\begin{figure}[H]
\begin{center}
\leavevmode
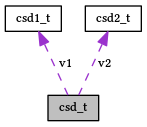
[picture p34: Weather_Balloon/Documentation/UML_Doxygen/html/unioncsd__t__coll__graph.png]

\end{center}
\end{figure}
\subsection*{Public Attributes}
\begin{DoxyCompactItemize}
\item 
\hyperlink{_sd_info_8h_a4dc5a2aea3d7715c82094bce06e1b3a7}{csd1\+\_\+t} \hyperlink{unioncsd__t_acb1d09f122f32629d8d6faa9edcc943b}{v1}
\item 
\hyperlink{_sd_info_8h_a3e07997926302b26d47ffb0535da9d01}{csd2\+\_\+t} \hyperlink{unioncsd__t_a19b60555856c9a485bcf4a84c248bfea}{v2}
\end{DoxyCompactItemize}

\subsection{Detailed Description}

Definition at line 228 of file Sd\+Info.\+h.

\subsection{Member Data Documentation}
\index{csd\+\_\+t@{csd\+\_\+t}!v1@{v1}}
\index{v1@{v1}!csd\+\_\+t@{csd\+\_\+t}}
\subsubsection[{\texorpdfstring{v1}{v1}}]{\setlength{\rightskip}{0pt plus 5cm}{\bf csd1\+\_\+t} csd\+\_\+t\+::v1}\hypertarget{unioncsd__t_acb1d09f122f32629d8d6faa9edcc943b}{}\label{unioncsd__t_acb1d09f122f32629d8d6faa9edcc943b}

Definition at line 229 of file Sd\+Info.\+h.

\index{csd\+\_\+t@{csd\+\_\+t}!v2@{v2}}
\index{v2@{v2}!csd\+\_\+t@{csd\+\_\+t}}
\subsubsection[{\texorpdfstring{v2}{v2}}]{\setlength{\rightskip}{0pt plus 5cm}{\bf csd2\+\_\+t} csd\+\_\+t\+::v2}\hypertarget{unioncsd__t_a19b60555856c9a485bcf4a84c248bfea}{}\label{unioncsd__t_a19b60555856c9a485bcf4a84c248bfea}

Definition at line 230 of file Sd\+Info.\+h.

The documentation for this union was generated from the following file\+:\begin{DoxyCompactItemize}
\item 
Weather\+\_\+\+Balloon/library/\+S\+D-\/master/\hyperlink{_sd_info_8h}{Sd\+Info.\+h}\end{DoxyCompactItemize}
