rasusmilch/HAB/Weather_Balloon/Documentation/UML_Doxygen/latex/wifi_config_8h.tex

\hypertarget{wifi_config_8h}{}\section{Weather\+\_\+\+Balloon/library/\+Firmata/examples/\+Standard\+Firmata\+Wi\+Fi/wifi\+Config.h File Reference}
\label{wifi_config_8h}\index{Weather\+\_\+\+Balloon/library/\+Firmata/examples/\+Standard\+Firmata\+Wi\+Fi/wifi\+Config.\+h@{Weather\+\_\+\+Balloon/library/\+Firmata/examples/\+Standard\+Firmata\+Wi\+Fi/wifi\+Config.\+h}}
\subsection*{Macros}
\begin{DoxyCompactItemize}
\item 
\#define \hyperlink{wifi_config_8h_ac42367fe5c999ec6650de83e9d72fe8c}{S\+E\+R\+V\+E\+R\+\_\+\+P\+O\+RT}~3030
\item 
\#define \hyperlink{wifi_config_8h_a4b5942a797892f1fed6ef1b5d6f2f81d}{W\+I\+F\+I\+\_\+\+W\+P\+A\+\_\+\+S\+E\+C\+U\+R\+I\+TY}
\end{DoxyCompactItemize}
\subsection*{Functions}
\begin{DoxyCompactItemize}
\item 
\hyperlink{class_wi_fi_server_stream}{Wi\+Fi\+Server\+Stream} \hyperlink{wifi_config_8h_a77a9d2319914e80a4858a3c76ec39113}{stream} (\hyperlink{wifi_config_8h_ac42367fe5c999ec6650de83e9d72fe8c}{S\+E\+R\+V\+E\+R\+\_\+\+P\+O\+RT})
\end{DoxyCompactItemize}
\subsection*{Variables}
\begin{DoxyCompactItemize}
\item 
char \hyperlink{wifi_config_8h_a375b545f86fd7e1d5d44926f28b75800}{ssid} \mbox{[}$\,$\mbox{]} = \char`\"{}your\+\_\+network\+\_\+name\char`\"{}
\item 
char \hyperlink{wifi_config_8h_af835aa6ca63e9a101de93aac1f859878}{wpa\+\_\+passphrase} \mbox{[}$\,$\mbox{]} = \char`\"{}your\+\_\+wpa\+\_\+passphrase\char`\"{}
\end{DoxyCompactItemize}

\subsection{Macro Definition Documentation}
\index{wifi\+Config.\+h@{wifi\+Config.\+h}!S\+E\+R\+V\+E\+R\+\_\+\+P\+O\+RT@{S\+E\+R\+V\+E\+R\+\_\+\+P\+O\+RT}}
\index{S\+E\+R\+V\+E\+R\+\_\+\+P\+O\+RT@{S\+E\+R\+V\+E\+R\+\_\+\+P\+O\+RT}!wifi\+Config.\+h@{wifi\+Config.\+h}}
\subsubsection[{\texorpdfstring{S\+E\+R\+V\+E\+R\+\_\+\+P\+O\+RT}{SERVER\_PORT}}]{\setlength{\rightskip}{0pt plus 5cm}\#define S\+E\+R\+V\+E\+R\+\_\+\+P\+O\+RT~3030}\hypertarget{wifi_config_8h_ac42367fe5c999ec6650de83e9d72fe8c}{}\label{wifi_config_8h_ac42367fe5c999ec6650de83e9d72fe8c}

Definition at line 133 of file wifi\+Config.\+h.

\index{wifi\+Config.\+h@{wifi\+Config.\+h}!W\+I\+F\+I\+\_\+\+W\+P\+A\+\_\+\+S\+E\+C\+U\+R\+I\+TY@{W\+I\+F\+I\+\_\+\+W\+P\+A\+\_\+\+S\+E\+C\+U\+R\+I\+TY}}
\index{W\+I\+F\+I\+\_\+\+W\+P\+A\+\_\+\+S\+E\+C\+U\+R\+I\+TY@{W\+I\+F\+I\+\_\+\+W\+P\+A\+\_\+\+S\+E\+C\+U\+R\+I\+TY}!wifi\+Config.\+h@{wifi\+Config.\+h}}
\subsubsection[{\texorpdfstring{W\+I\+F\+I\+\_\+\+W\+P\+A\+\_\+\+S\+E\+C\+U\+R\+I\+TY}{WIFI\_WPA\_SECURITY}}]{\setlength{\rightskip}{0pt plus 5cm}\#define W\+I\+F\+I\+\_\+\+W\+P\+A\+\_\+\+S\+E\+C\+U\+R\+I\+TY}\hypertarget{wifi_config_8h_a4b5942a797892f1fed6ef1b5d6f2f81d}{}\label{wifi_config_8h_a4b5942a797892f1fed6ef1b5d6f2f81d}

Definition at line 148 of file wifi\+Config.\+h.

\subsection{Function Documentation}
\index{wifi\+Config.\+h@{wifi\+Config.\+h}!stream@{stream}}
\index{stream@{stream}!wifi\+Config.\+h@{wifi\+Config.\+h}}
\subsubsection[{\texorpdfstring{stream(\+S\+E\+R\+V\+E\+R\+\_\+\+P\+O\+R\+T)}{stream(SERVER\_PORT)}}]{\setlength{\rightskip}{0pt plus 5cm}{\bf Wi\+Fi\+Server\+Stream} stream (
\begin{DoxyParamCaption}
\item[{{\bf S\+E\+R\+V\+E\+R\+\_\+\+P\+O\+RT}}]{}
\end{DoxyParamCaption}
)}\hypertarget{wifi_config_8h_a77a9d2319914e80a4858a3c76ec39113}{}\label{wifi_config_8h_a77a9d2319914e80a4858a3c76ec39113}

\subsection{Variable Documentation}
\index{wifi\+Config.\+h@{wifi\+Config.\+h}!ssid@{ssid}}
\index{ssid@{ssid}!wifi\+Config.\+h@{wifi\+Config.\+h}}
\subsubsection[{\texorpdfstring{ssid}{ssid}}]{\setlength{\rightskip}{0pt plus 5cm}char ssid\mbox{[}$\,$\mbox{]} = \char`\"{}your\+\_\+network\+\_\+name\char`\"{}}\hypertarget{wifi_config_8h_a375b545f86fd7e1d5d44926f28b75800}{}\label{wifi_config_8h_a375b545f86fd7e1d5d44926f28b75800}

Definition at line 119 of file wifi\+Config.\+h.

Referenced by Wi\+Fi\+Stream\+::begin().

\index{wifi\+Config.\+h@{wifi\+Config.\+h}!wpa\+\_\+passphrase@{wpa\+\_\+passphrase}}
\index{wpa\+\_\+passphrase@{wpa\+\_\+passphrase}!wifi\+Config.\+h@{wifi\+Config.\+h}}
\subsubsection[{\texorpdfstring{wpa\+\_\+passphrase}{wpa\_passphrase}}]{\setlength{\rightskip}{0pt plus 5cm}char wpa\+\_\+passphrase\mbox{[}$\,$\mbox{]} = \char`\"{}your\+\_\+wpa\+\_\+passphrase\char`\"{}}\hypertarget{wifi_config_8h_af835aa6ca63e9a101de93aac1f859878}{}\label{wifi_config_8h_af835aa6ca63e9a101de93aac1f859878}

Definition at line 151 of file wifi\+Config.\+h.
