rasusmilch/HAB/Weather_Balloon/Board/g8060.png

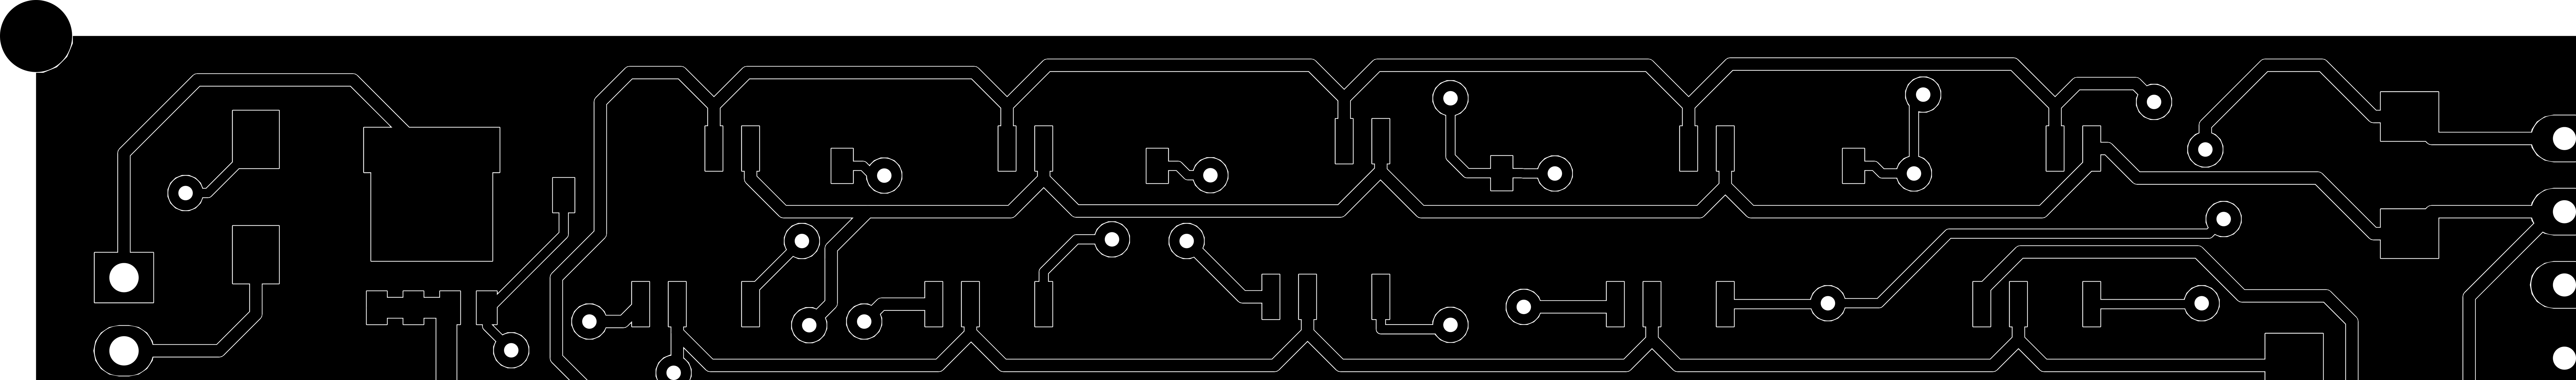
Weather_Balloon/Board/g8060.png
