rasusmilch/HAB/Weather_Balloon/Board/Weather Balloon-F.Cu.svg.png

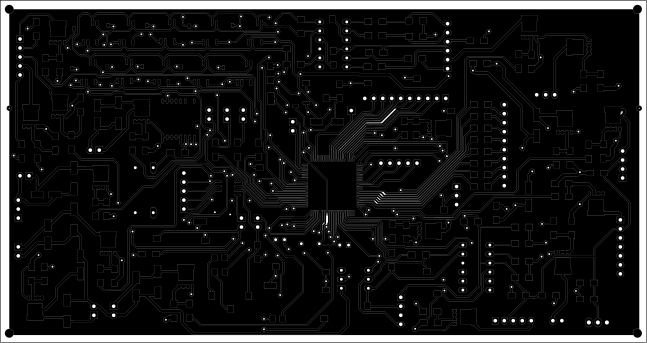
Weather_Balloon/Board/Weather Balloon-F.Cu.svg.png
