rasusmilch/HAB/Weather_Balloon/Data/Flight_1/accel_alt.png

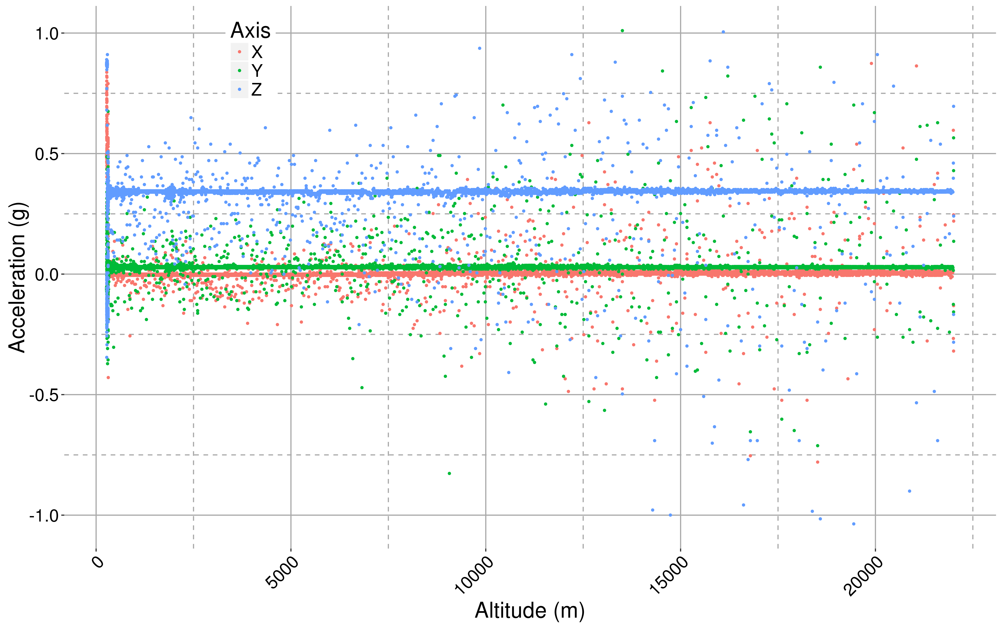
Weather_Balloon/Data/Flight_1/accel_alt.png
