rasusmilch/HAB/Weather_Balloon/Data/Flight_1/accel_alt_10_min.png

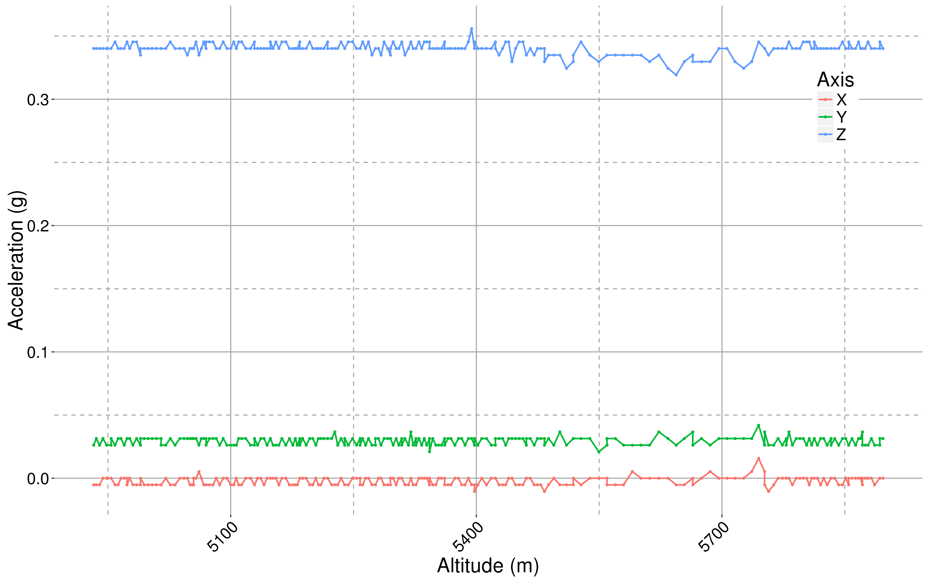
Weather_Balloon/Data/Flight_1/accel_alt_10_min.png
