rasusmilch/HAB/Weather_Balloon/Data/Flight_1/accel_mag_altitude.png

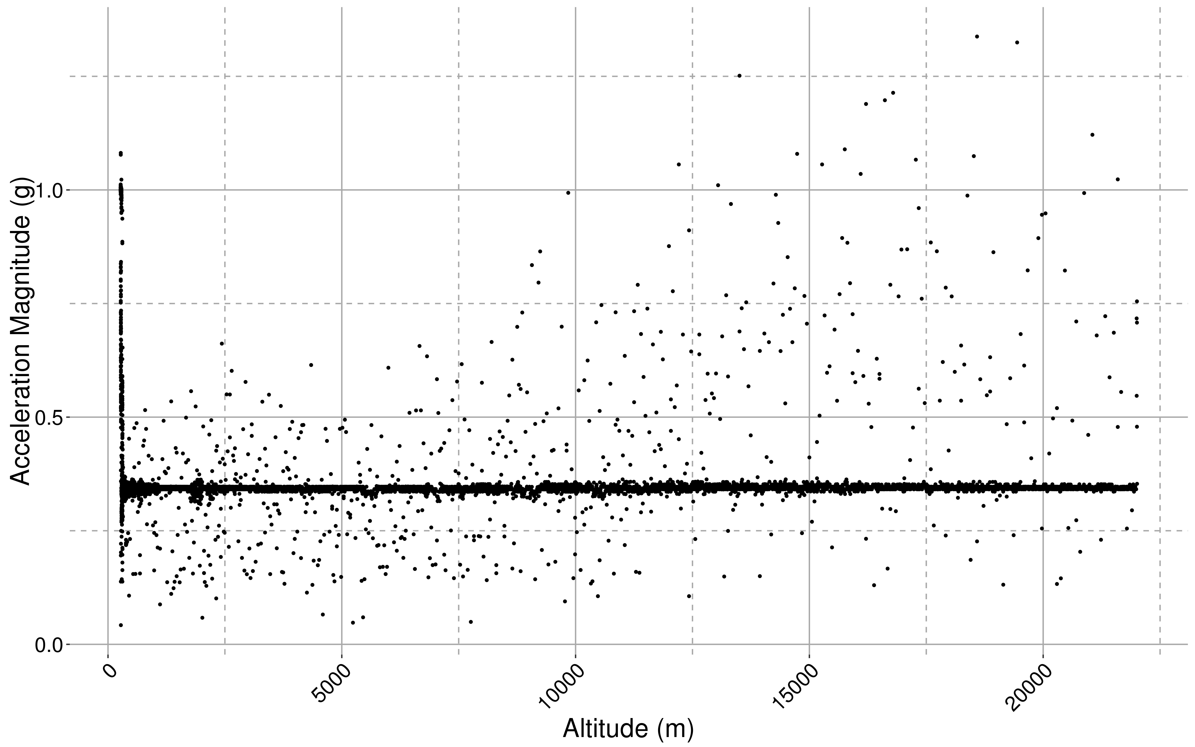
Weather_Balloon/Data/Flight_1/accel_mag_altitude.png
