rasusmilch/HAB/Weather_Balloon/Data/Flight_1/accel_mag_time_10_min.png

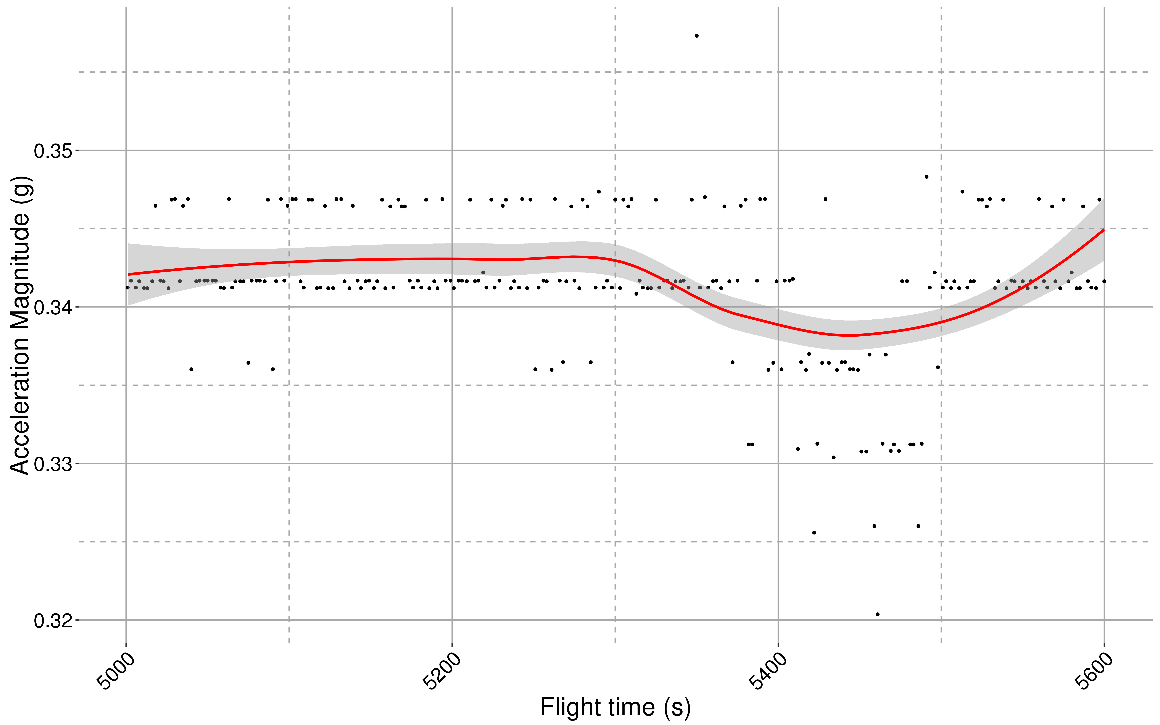
Weather_Balloon/Data/Flight_1/accel_mag_time_10_min.png
