rasusmilch/HAB/Weather_Balloon/Data/Flight_1/altitude_time.png

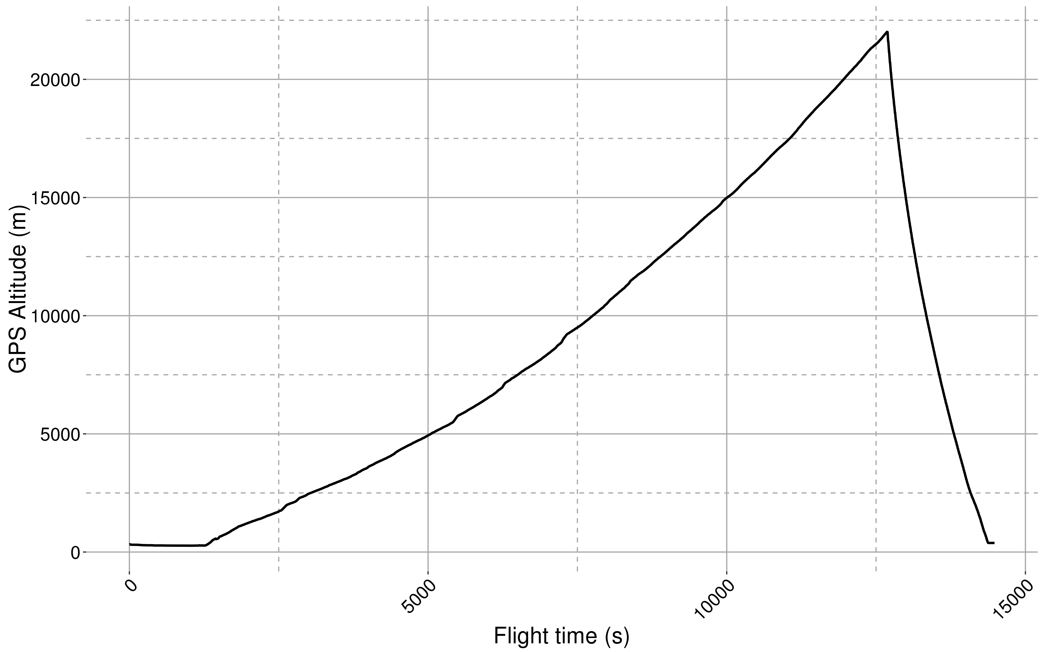
Weather_Balloon/Data/Flight_1/altitude_time.png
