rasusmilch/HAB/Weather_Balloon/Data/Flight_1/decent_accel_alt.png

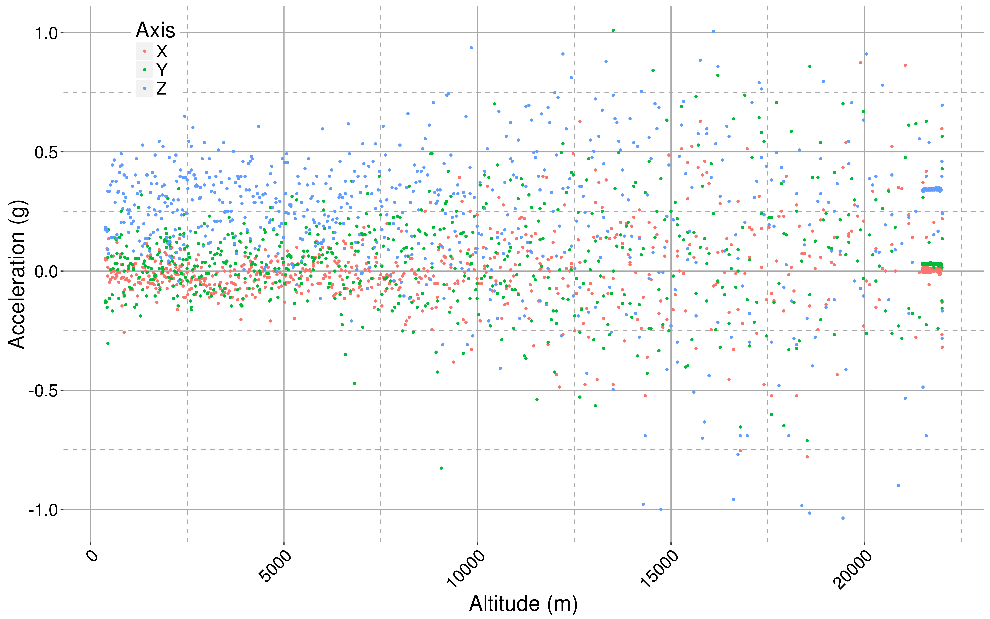
Weather_Balloon/Data/Flight_1/decent_accel_alt.png
