rasusmilch/HAB/Weather_Balloon/Data/Flight_1/decent_accel_time.png

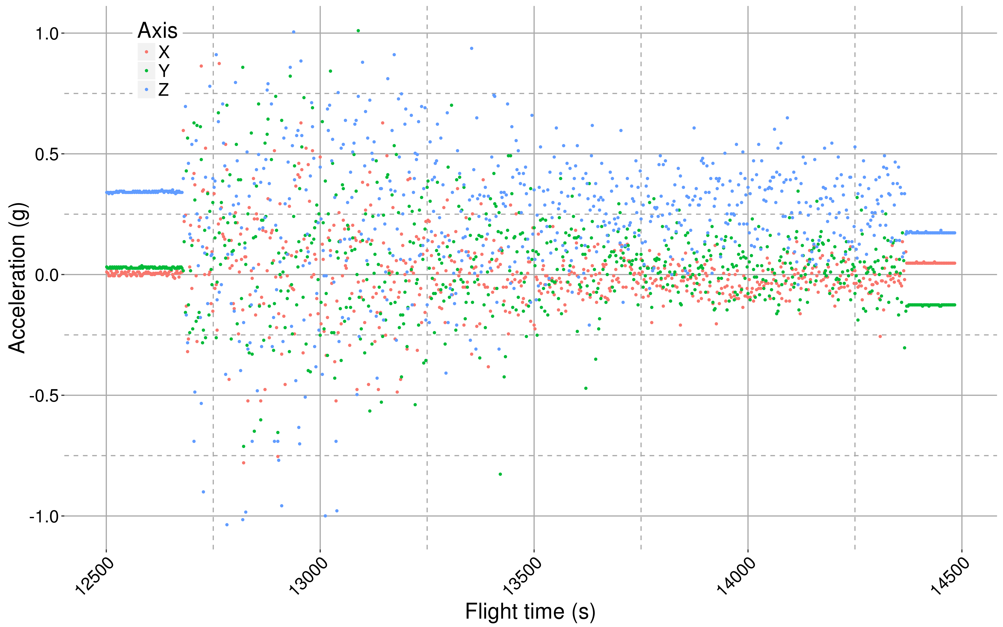
Weather_Balloon/Data/Flight_1/decent_accel_time.png
