rasusmilch/HAB/Weather_Balloon/Data/Flight_1/decent_gyro_time.png

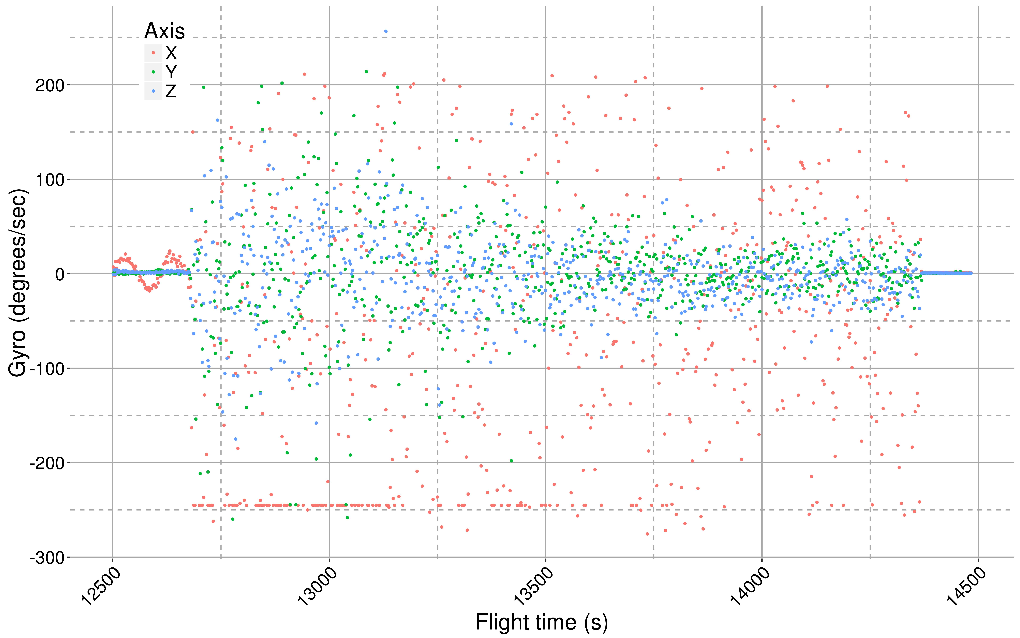
Weather_Balloon/Data/Flight_1/decent_gyro_time.png
