rasusmilch/HAB/Weather_Balloon/Data/Flight_1/external_altitude.png

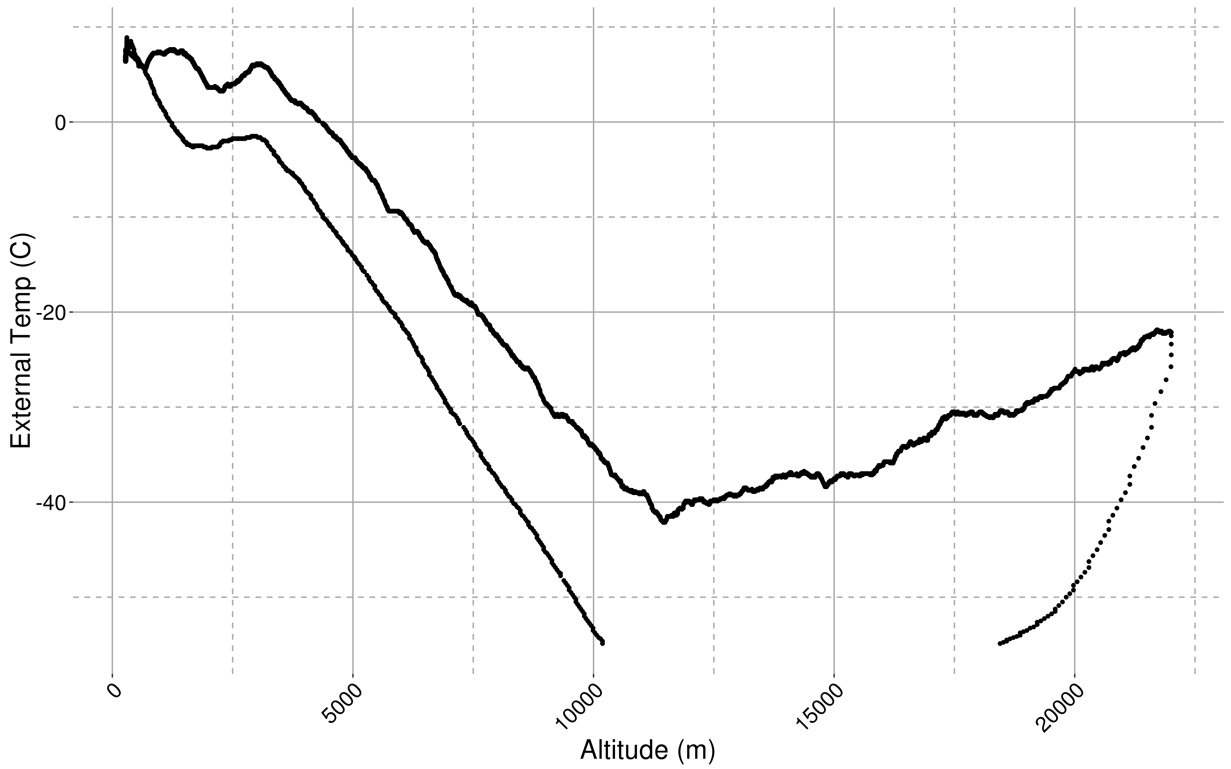
Weather_Balloon/Data/Flight_1/external_altitude.png
