rasusmilch/HAB/Weather_Balloon/Data/Flight_1/external_time.png

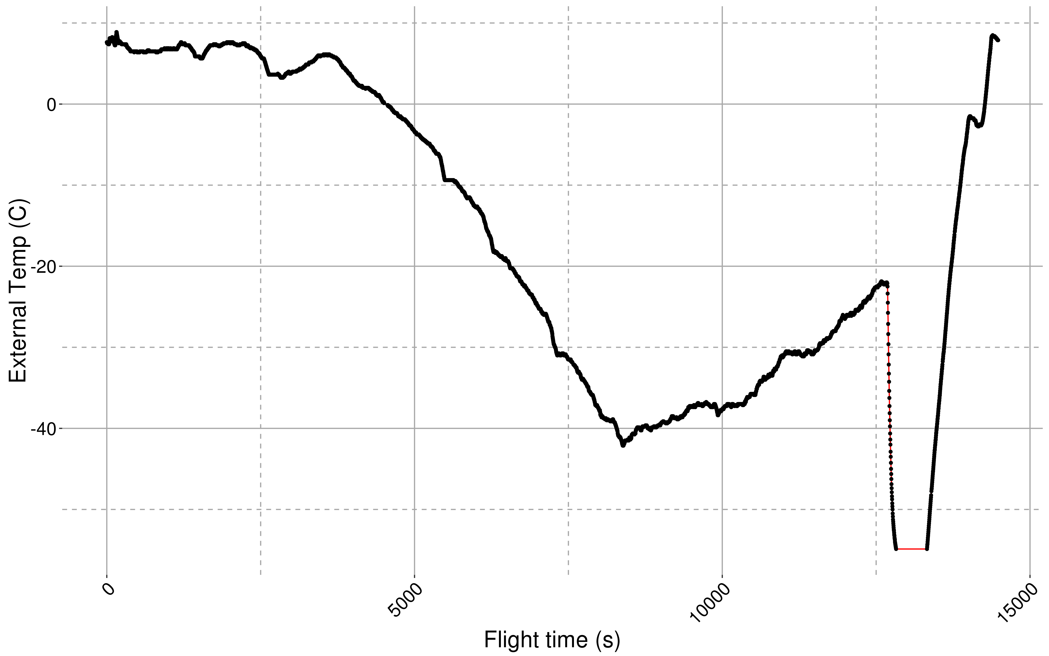
Weather_Balloon/Data/Flight_1/external_time.png
