rasusmilch/HAB/Weather_Balloon/Data/Flight_1/GPS_course_time.png

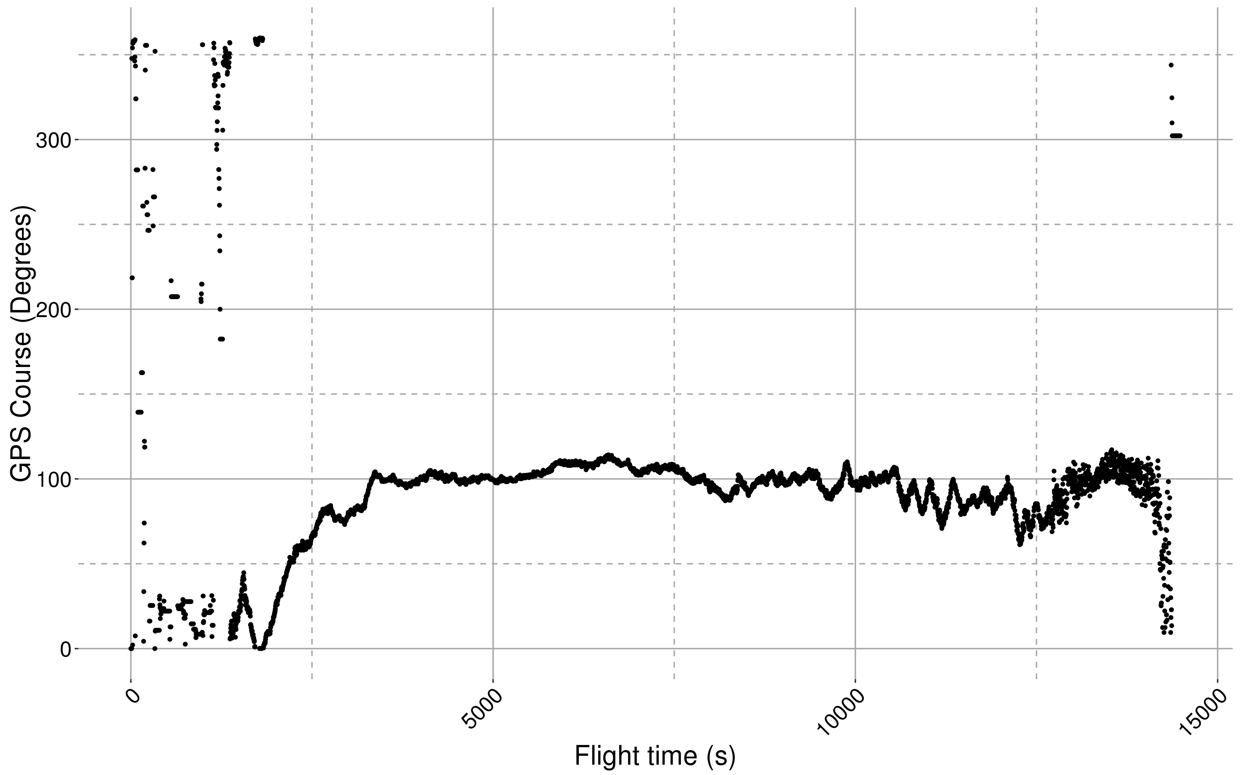
Weather_Balloon/Data/Flight_1/GPS_course_time.png
