rasusmilch/HAB/Weather_Balloon/Data/Flight_1/gyro_time.png

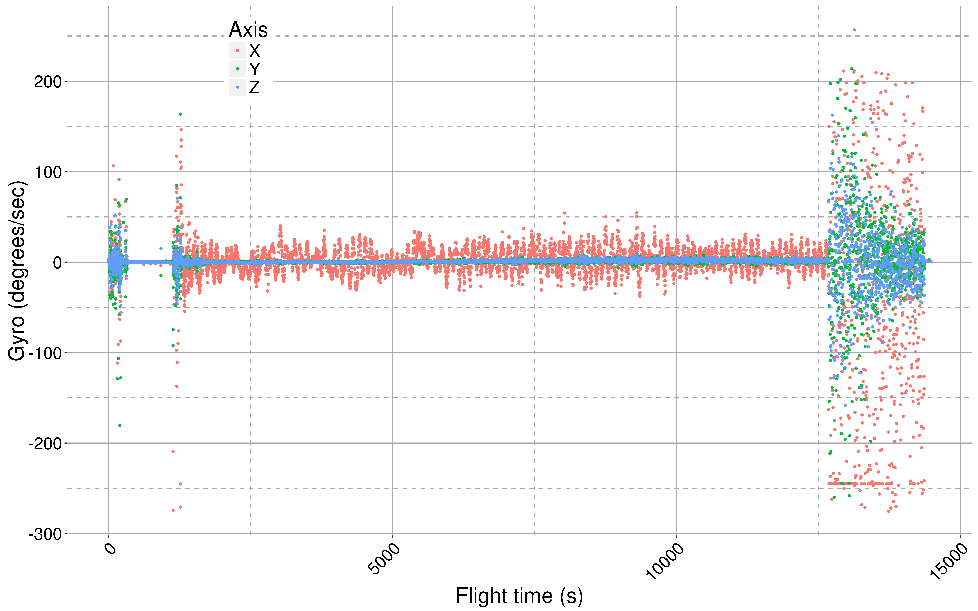
Weather_Balloon/Data/Flight_1/gyro_time.png
