rasusmilch/HAB/Weather_Balloon/Data/Flight_1/gyro_time_10_min.png

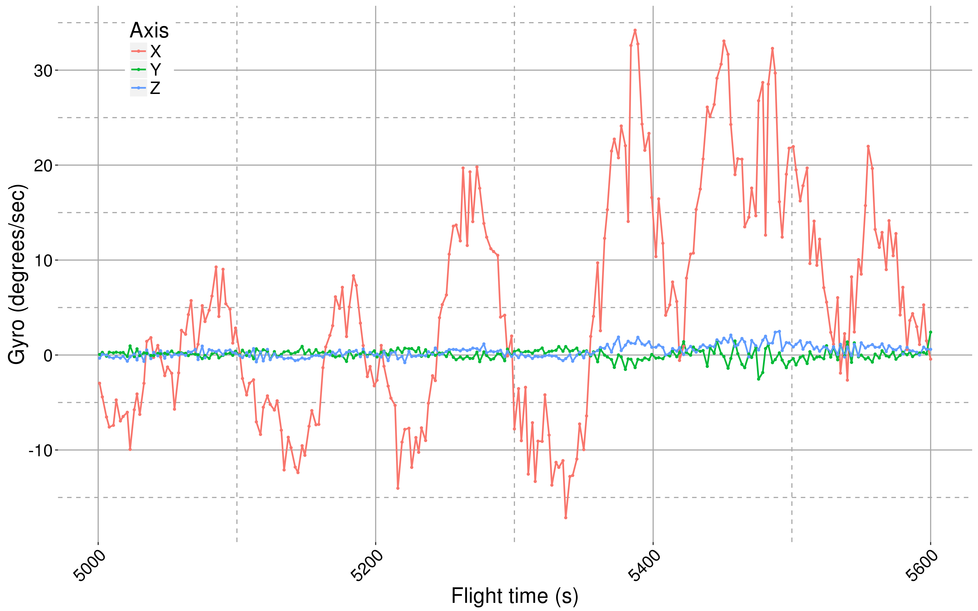
Weather_Balloon/Data/Flight_1/gyro_time_10_min.png
