rasusmilch/HAB/Weather_Balloon/Data/Flight_1/humidity_alt.png

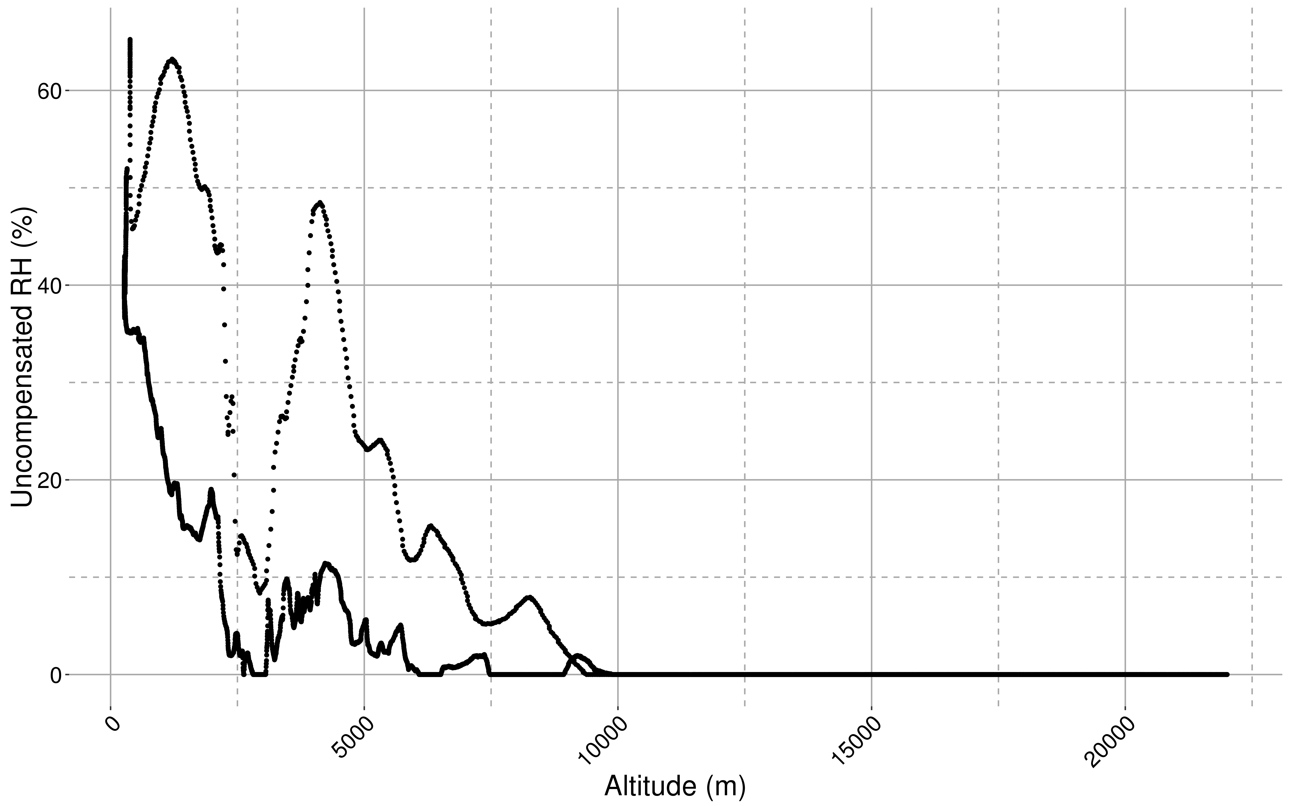
Weather_Balloon/Data/Flight_1/humidity_alt.png
