rasusmilch/HAB/Weather_Balloon/Data/Flight_1/humidity_time.png

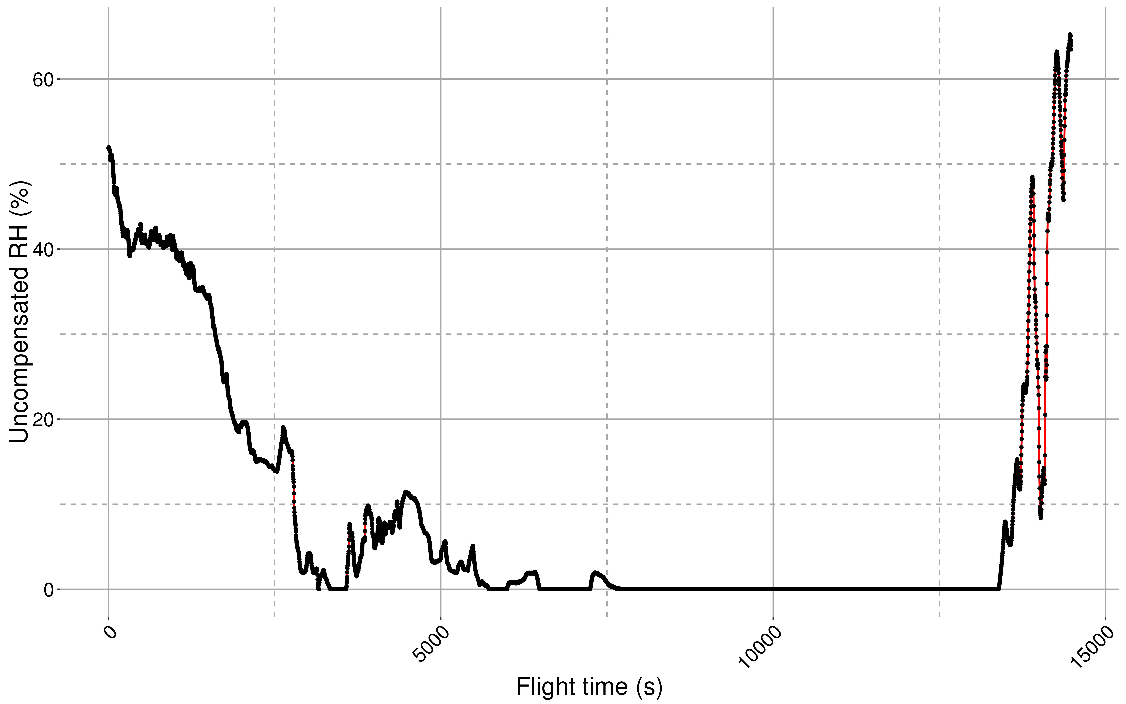
Weather_Balloon/Data/Flight_1/humidity_time.png
