rasusmilch/HAB/Weather_Balloon/Data/Flight_1/internal_altitude.png

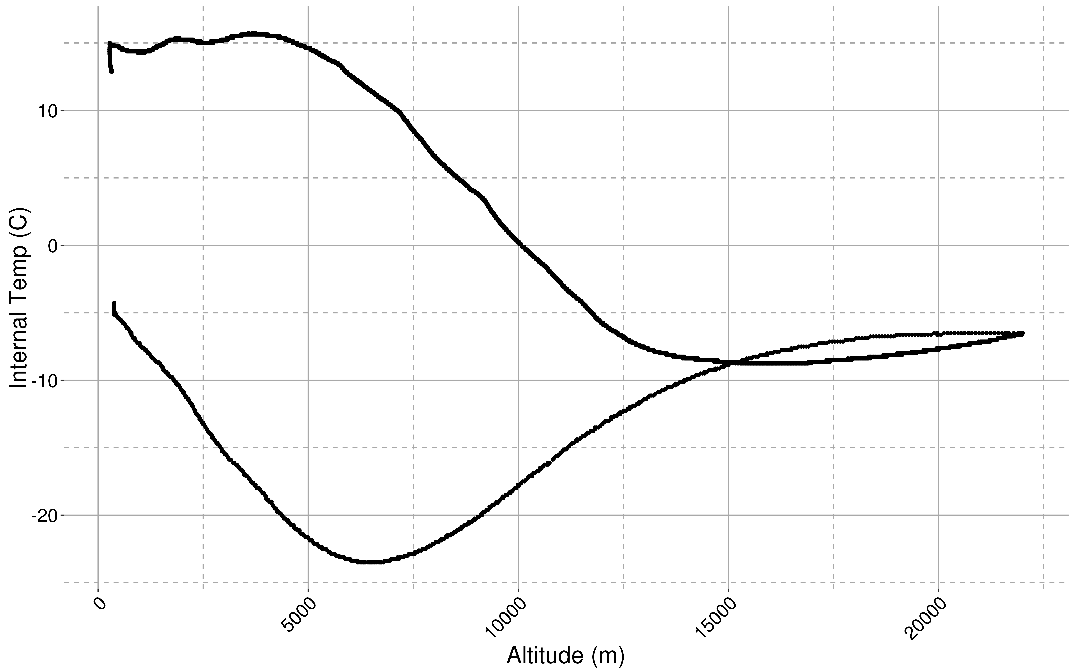
Weather_Balloon/Data/Flight_1/internal_altitude.png
