rasusmilch/HAB/Weather_Balloon/Data/Flight_1/internal_time.png

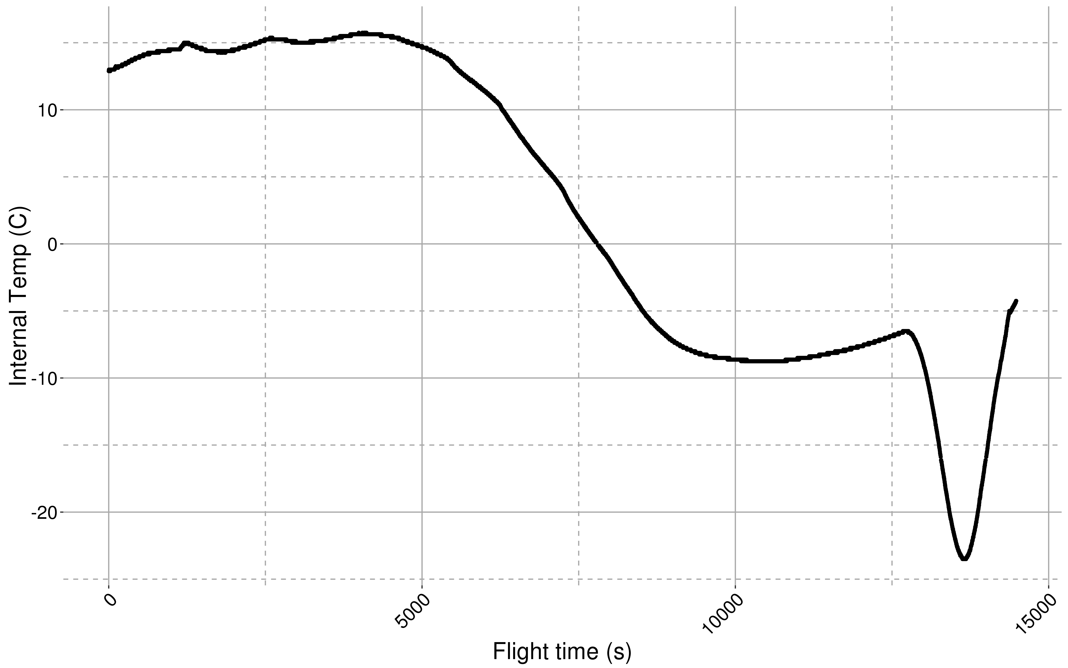
Weather_Balloon/Data/Flight_1/internal_time.png
