rasusmilch/HAB/Weather_Balloon/Data/Flight_1/main_altitude.png

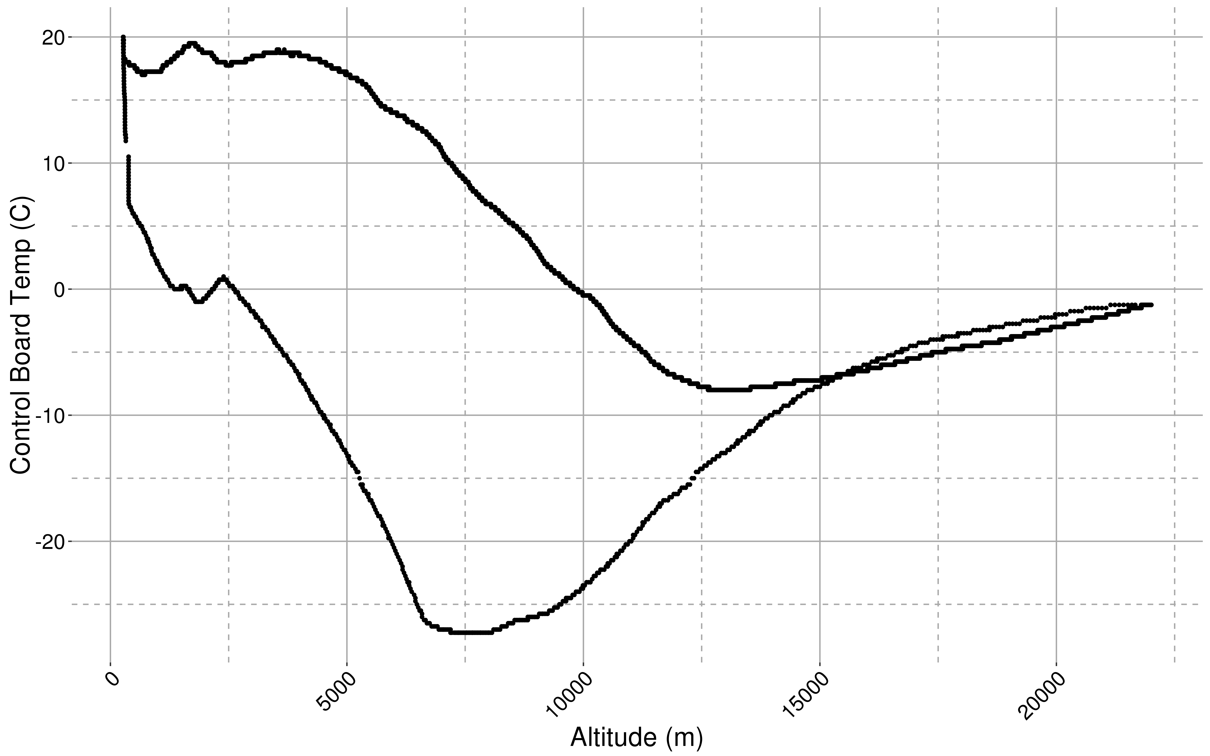
Weather_Balloon/Data/Flight_1/main_altitude.png
