rasusmilch/HAB/Weather_Balloon/Data/Flight_1/main_time.png

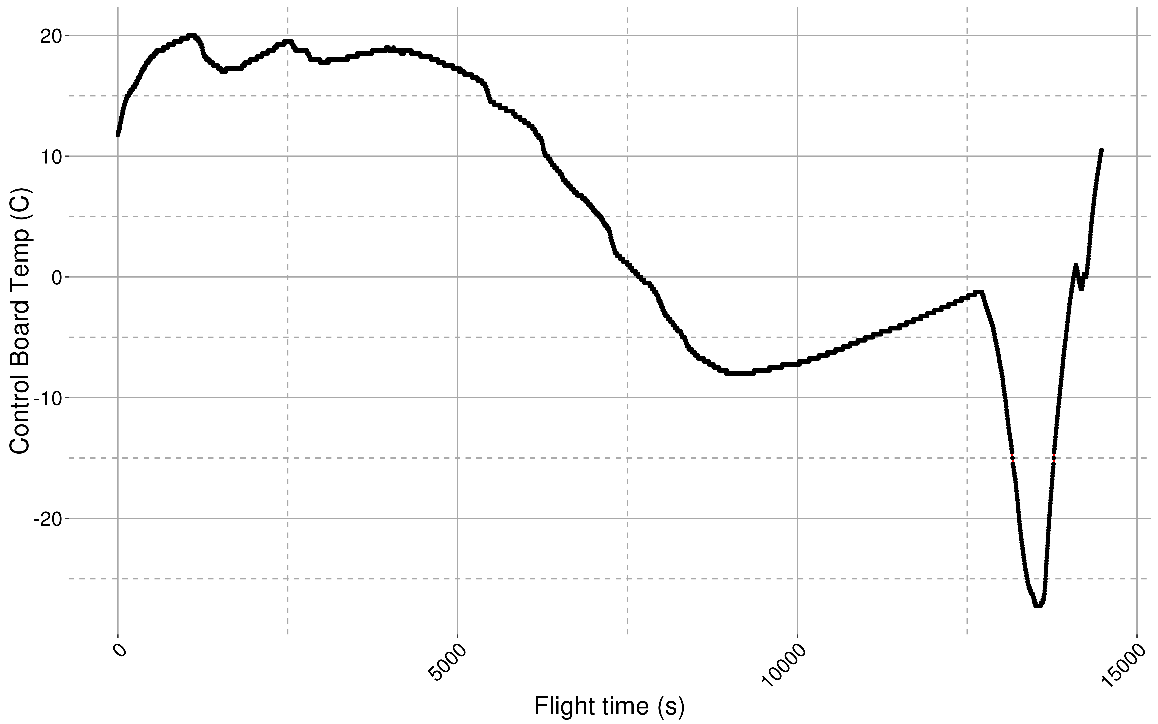
Weather_Balloon/Data/Flight_1/main_time.png
