rasusmilch/HAB/Weather_Balloon/Data/Flight_1/pressure_altitude.png

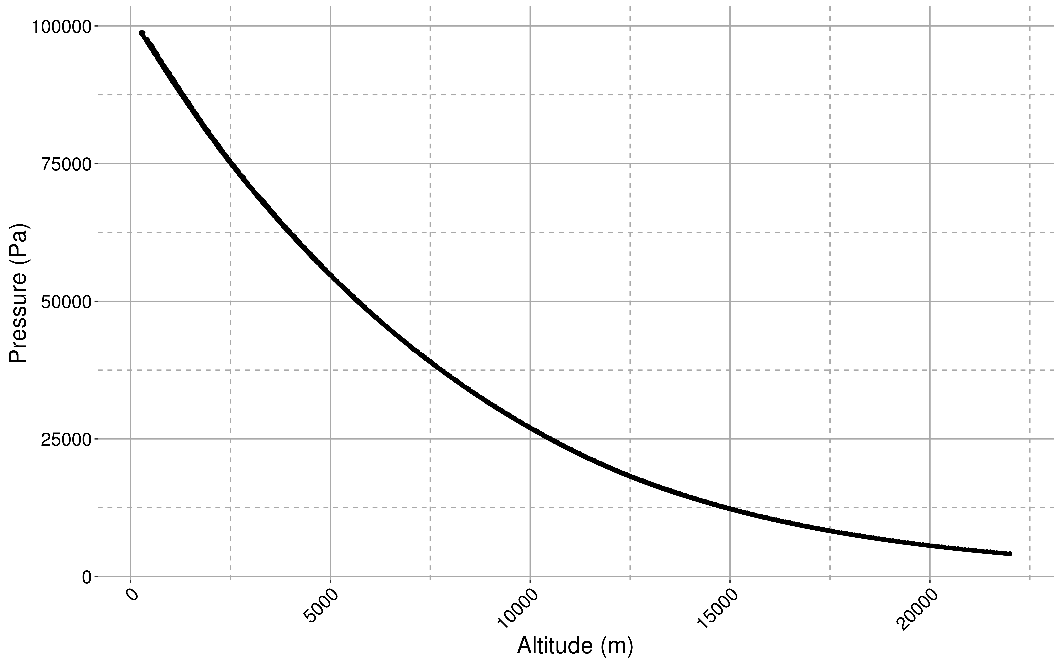
Weather_Balloon/Data/Flight_1/pressure_altitude.png
