rasusmilch/HAB/Weather_Balloon/Data/Flight_1/pressure_time.png

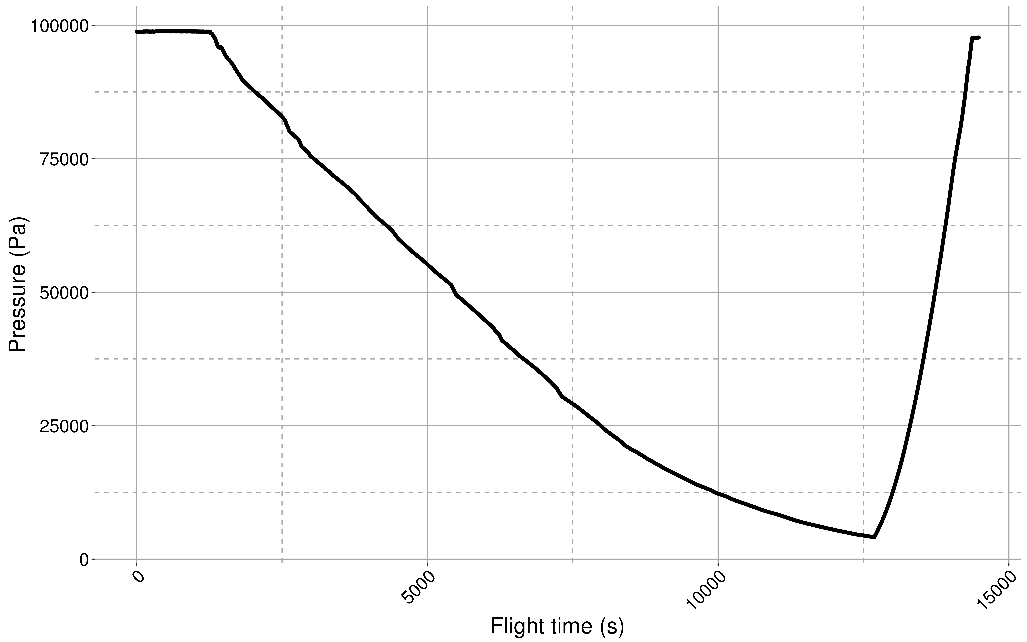
Weather_Balloon/Data/Flight_1/pressure_time.png
