rasusmilch/HAB/Weather_Balloon/Data/Flight_1/rad_alt.png

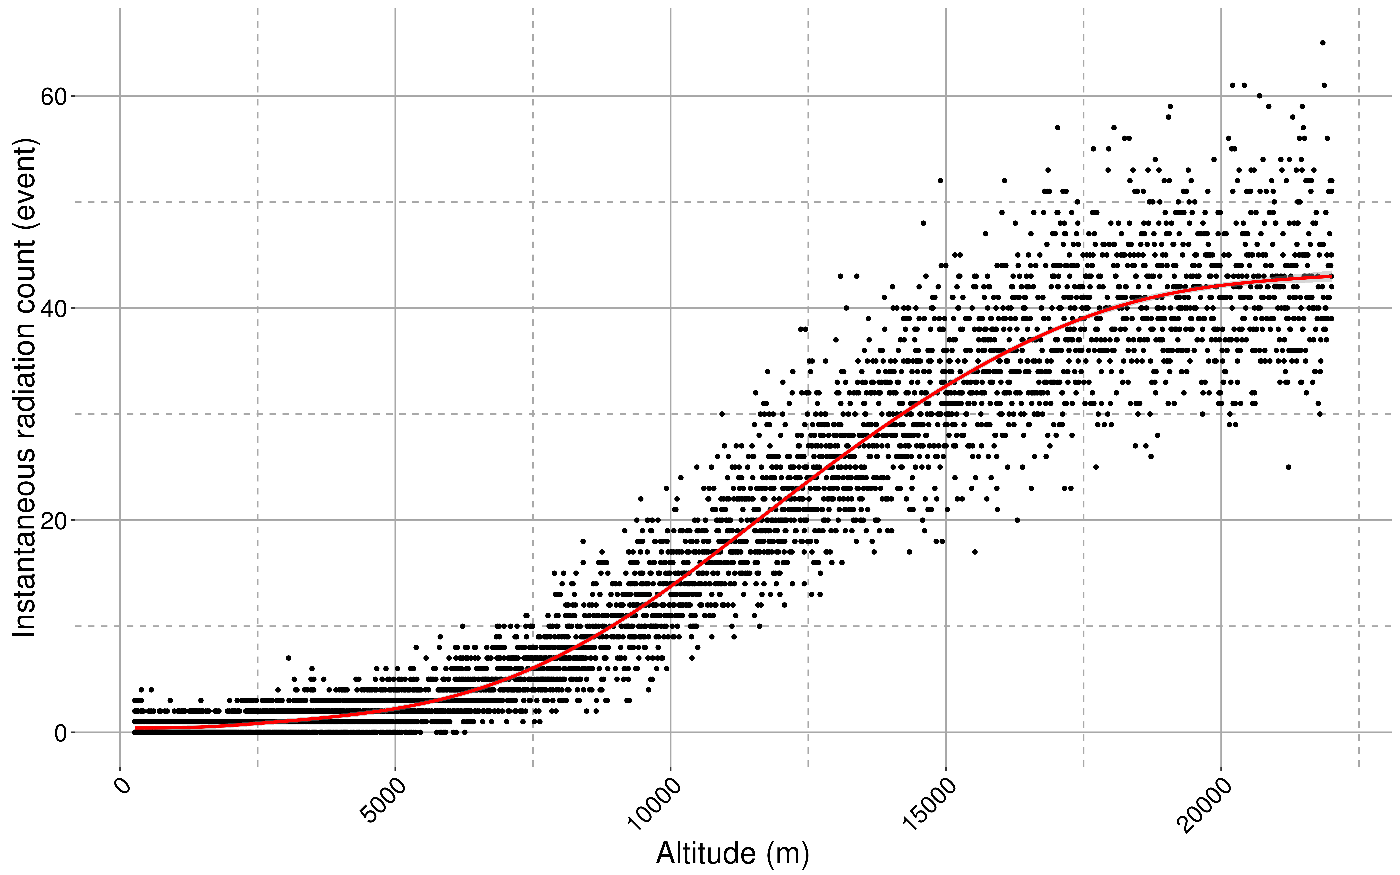
Weather_Balloon/Data/Flight_1/rad_alt.png
