rasusmilch/HAB/Weather_Balloon/Data/Flight_1/rad_time.png

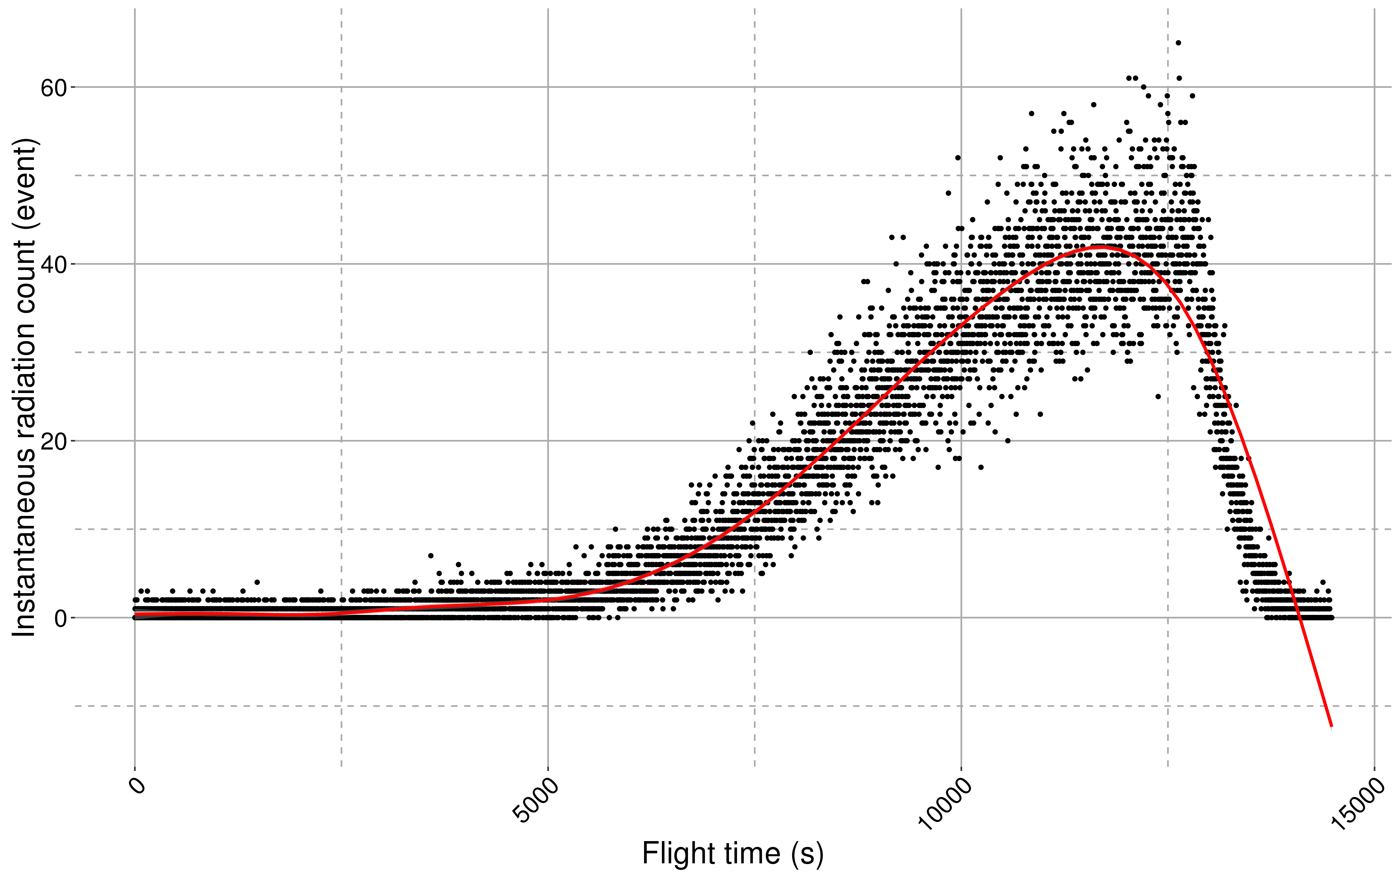
Weather_Balloon/Data/Flight_1/rad_time.png
