rasusmilch/HAB/Weather_Balloon/Data/Flight_1/soc_time.png

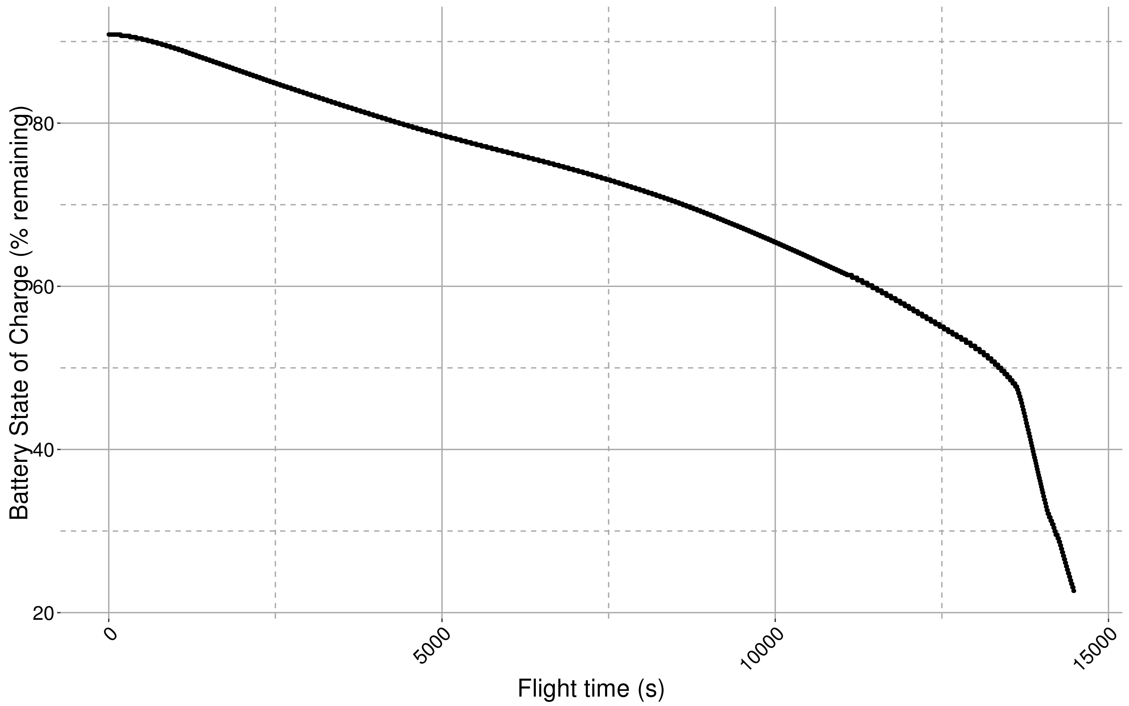
Weather_Balloon/Data/Flight_1/soc_time.png
