rasusmilch/HAB/Weather_Balloon/Data/Flight_1/speed_altitude.png

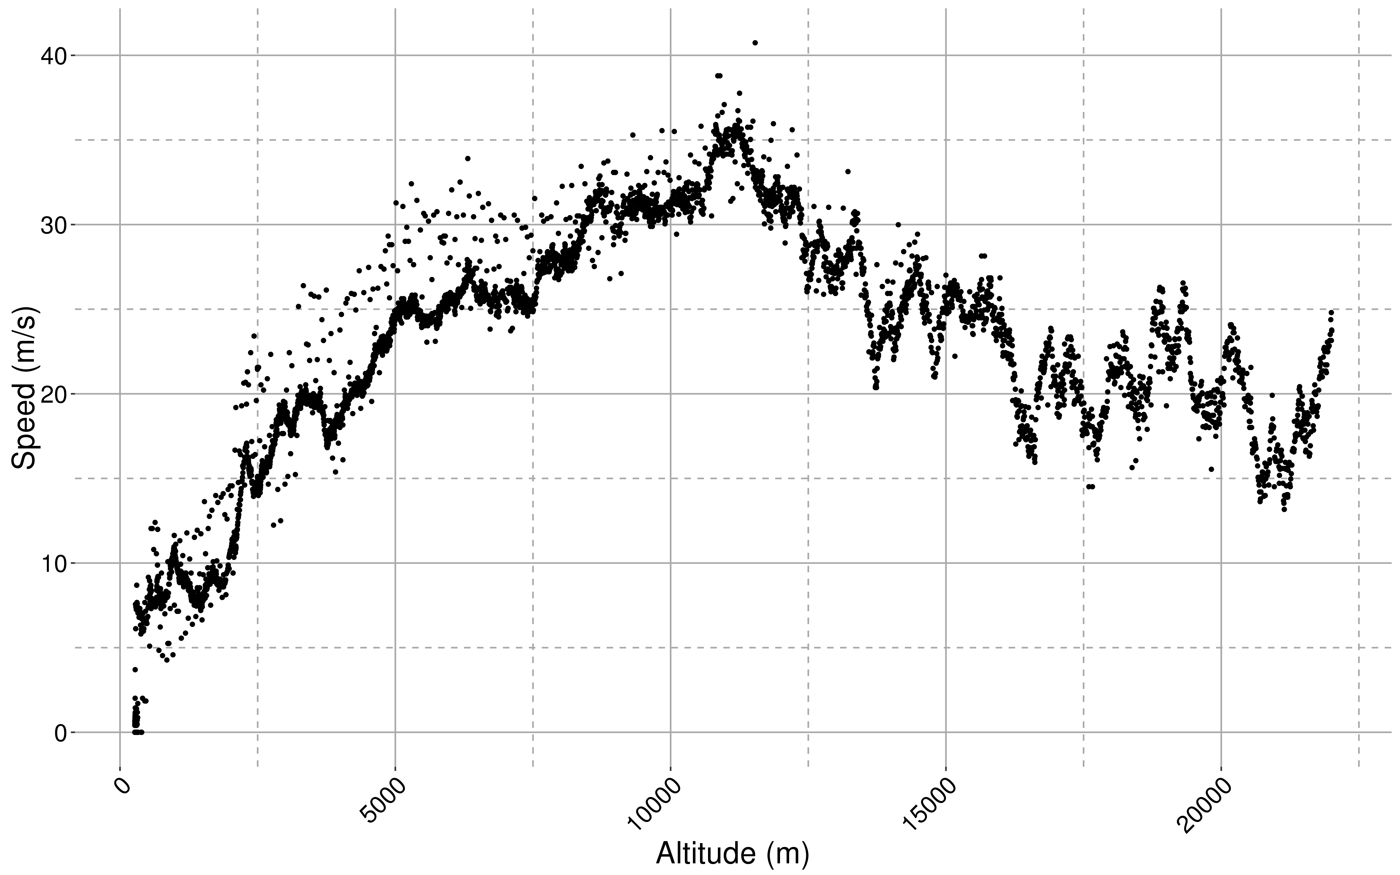
Weather_Balloon/Data/Flight_1/speed_altitude.png
