rasusmilch/HAB/Weather_Balloon/Data/Flight_1/speed_time.png

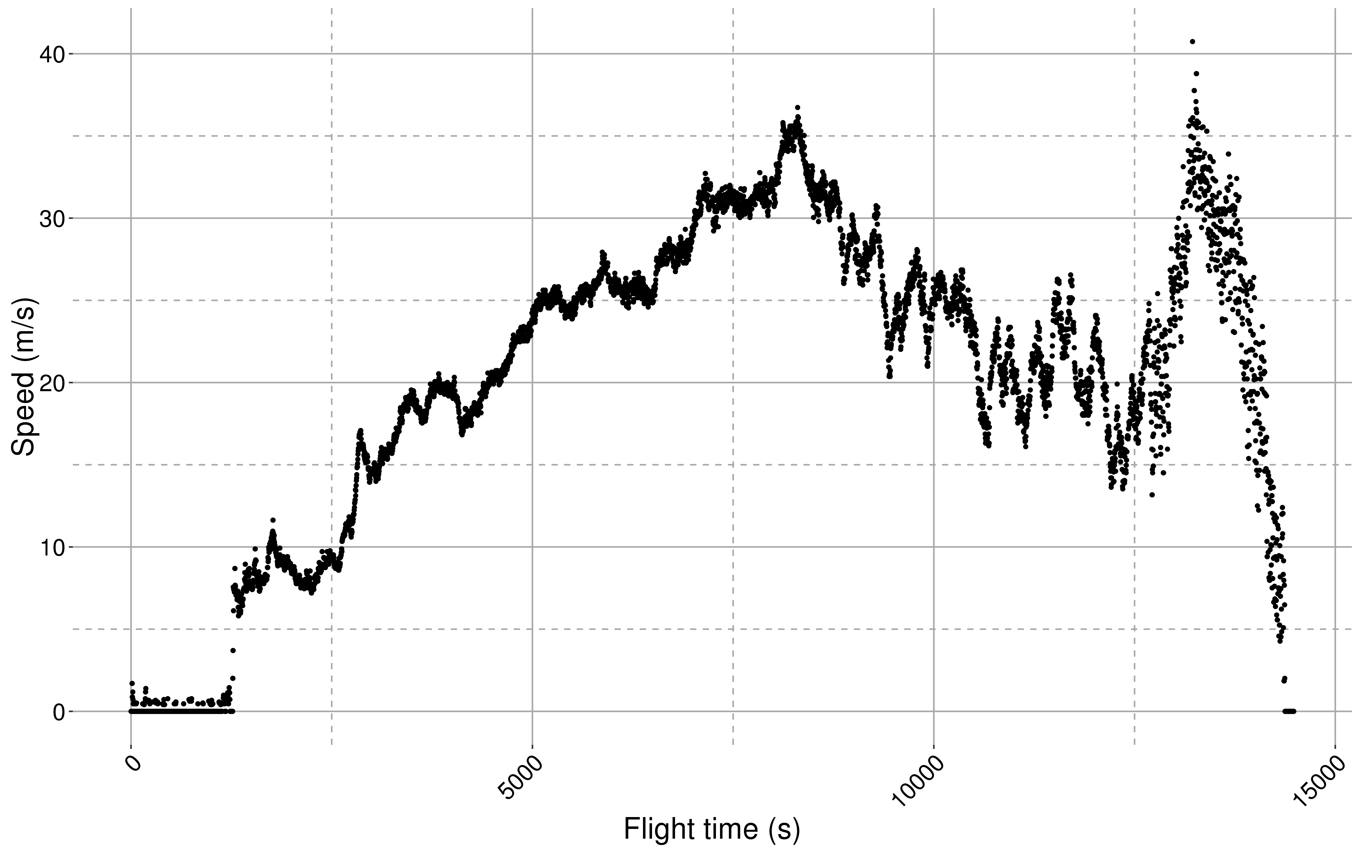
Weather_Balloon/Data/Flight_1/speed_time.png
