rasusmilch/HAB/Weather_Balloon/Data/Flight_1/tsl2561_alt.png

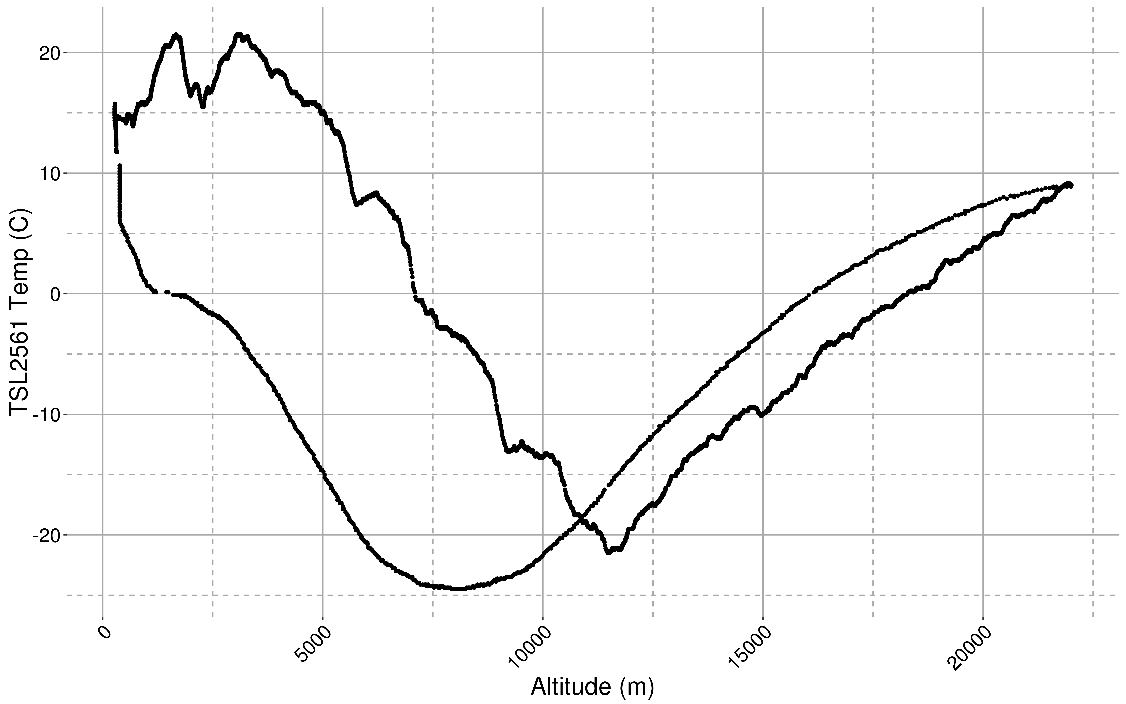
Weather_Balloon/Data/Flight_1/tsl2561_alt.png
