rasusmilch/HAB/Weather_Balloon/Data/Flight_1/uv_alt.png

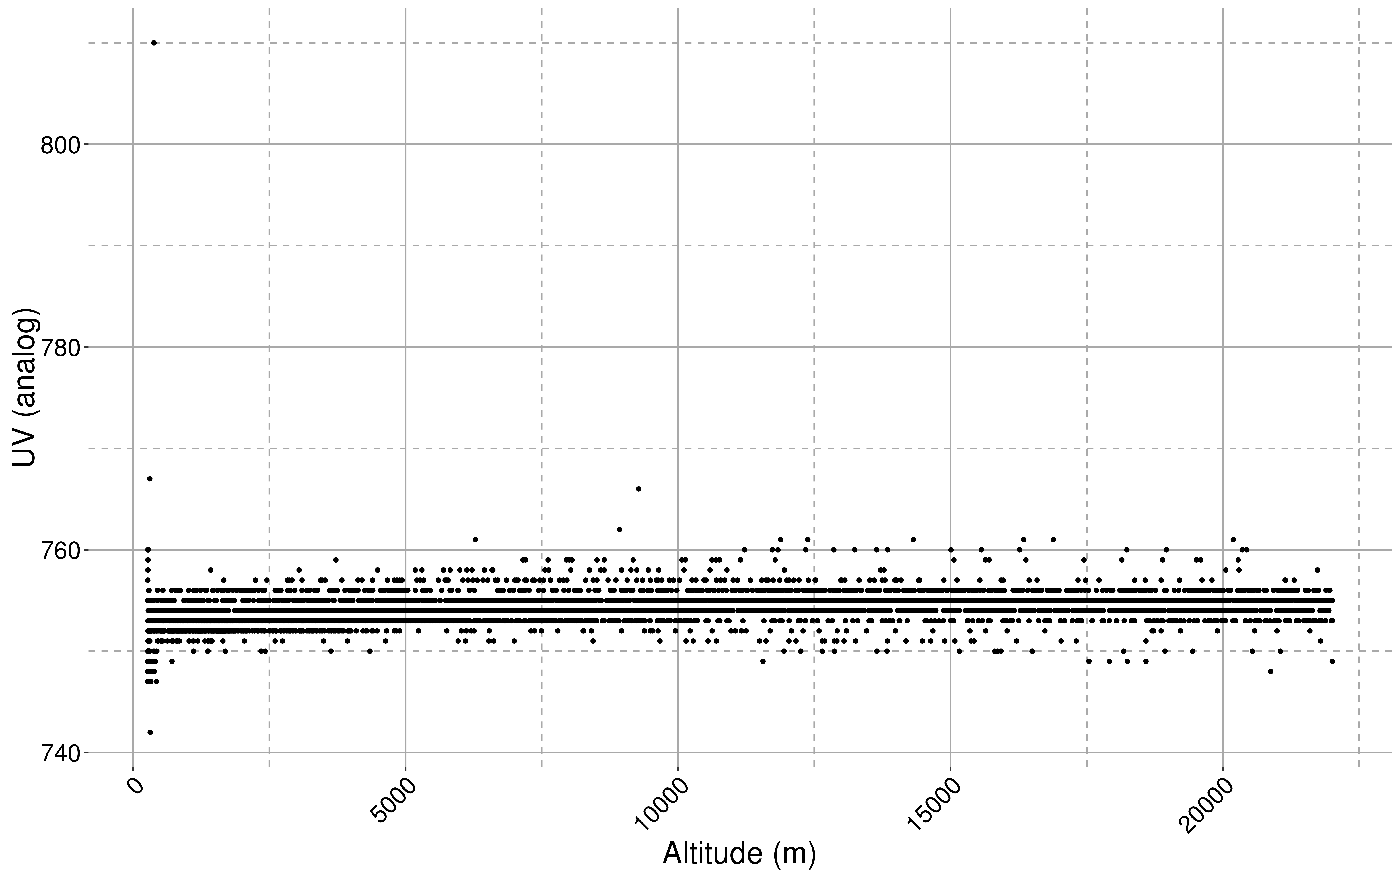
Weather_Balloon/Data/Flight_1/uv_alt.png
