rasusmilch/HAB/Weather_Balloon/Data/Flight_1/uv_time.png

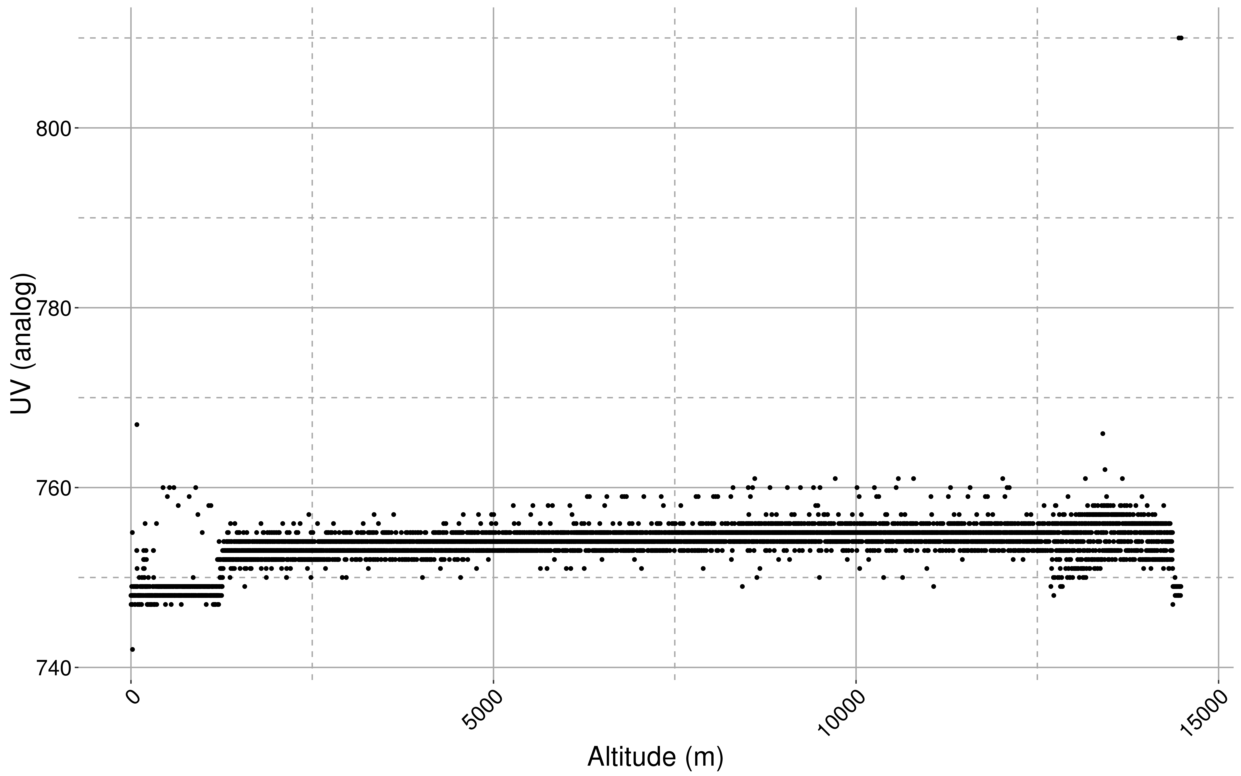
Weather_Balloon/Data/Flight_1/uv_time.png
