rasusmilch/HAB/Weather_Balloon/Data/Flight_1/voltage_time.png

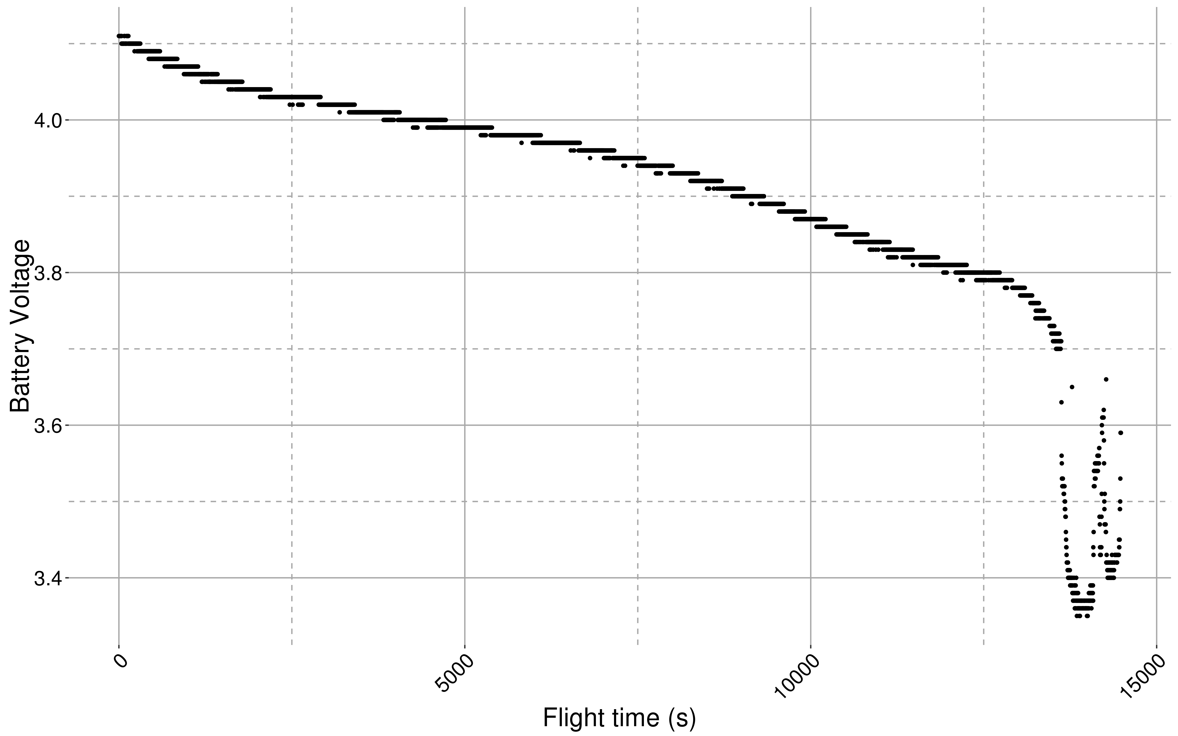
Weather_Balloon/Data/Flight_1/voltage_time.png
