rasusmilch/HAB/Weather_Balloon/Documentation/Design Document/WeatherBalloon/_weather___balloon_8cpp__incl.png

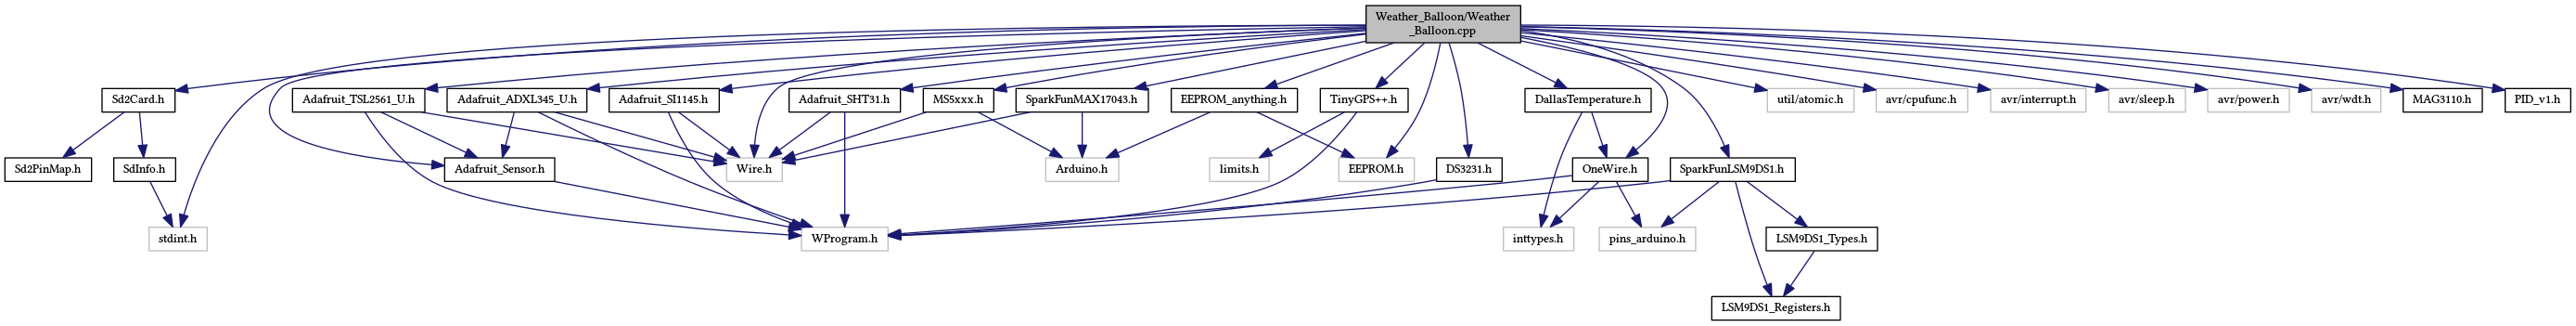
Weather_Balloon/Documentation/Design Document/WeatherBalloon/_weather___balloon_8cpp__incl.png
