rasusmilch/HAB/Weather_Balloon/Documentation/Design Document/WeatherBalloon/_weather___balloon_8cpp_a2c2e98945e78daa792b87b30868c3907_cgraph.png

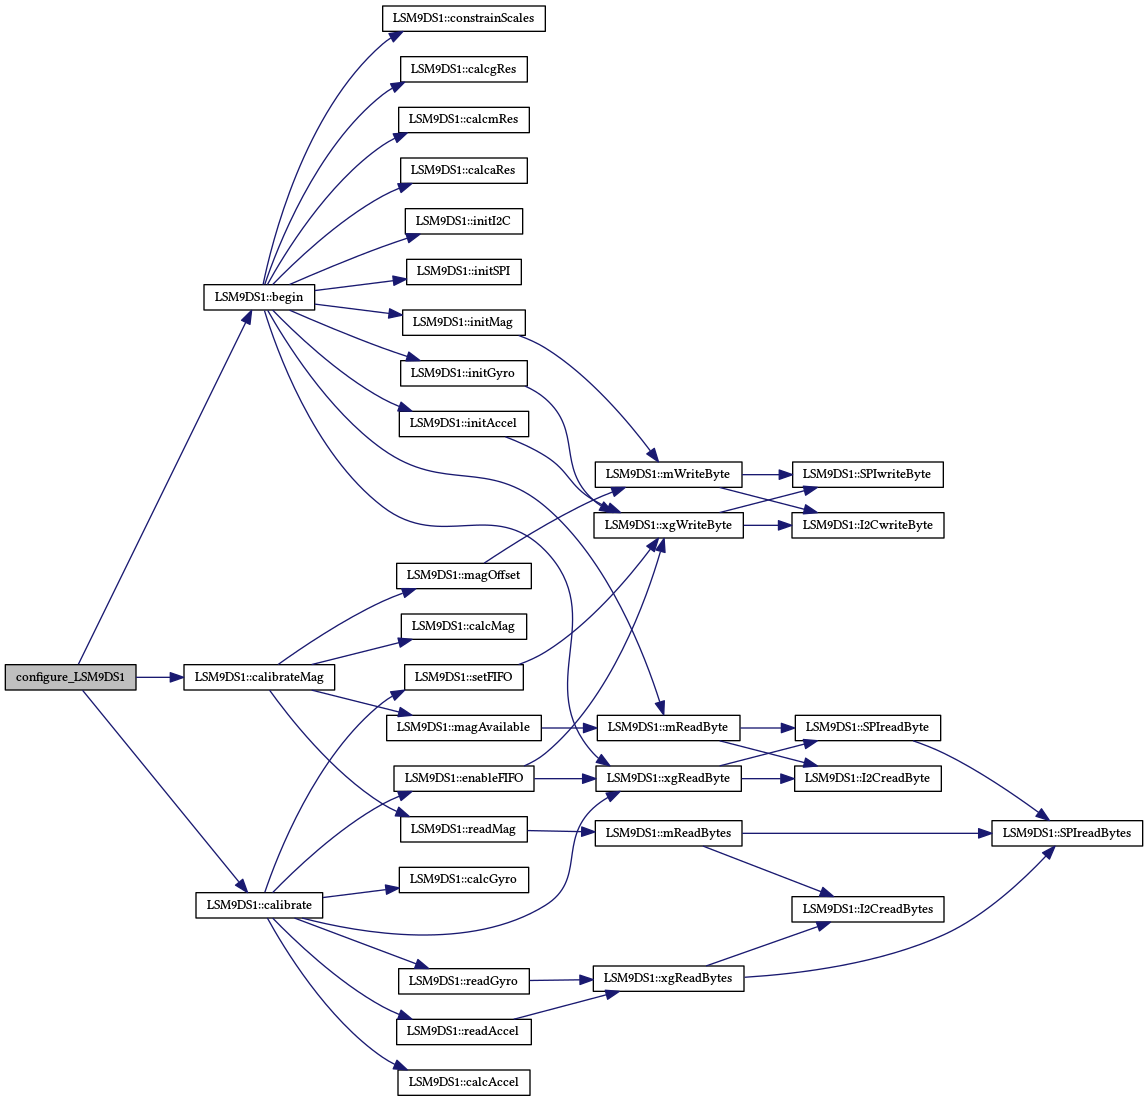
Weather_Balloon/Documentation/Design Document/WeatherBalloon/_weather___balloon_8cpp_a2c2e98945e78daa792b87b30868c3907_cgraph.png
