rasusmilch/HAB/Weather_Balloon/Documentation/Design Document/WeatherBalloon/_weather___balloon_8cpp_a3d30b497ce4c43d95b30a95944f9d8be_icgraph.png

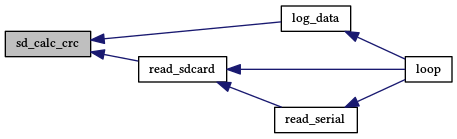
Weather_Balloon/Documentation/Design Document/WeatherBalloon/_weather___balloon_8cpp_a3d30b497ce4c43d95b30a95944f9d8be_icgraph.png
