rasusmilch/HAB/Weather_Balloon/Documentation/Design Document/WeatherBalloon/_weather___balloon_8cpp_a3f8e34eb2b9d824174dced9eefeecf90_cgraph.png

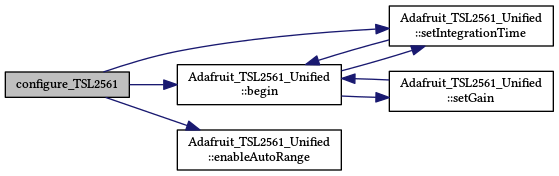
Weather_Balloon/Documentation/Design Document/WeatherBalloon/_weather___balloon_8cpp_a3f8e34eb2b9d824174dced9eefeecf90_cgraph.png
