rasusmilch/HAB/Weather_Balloon/Documentation/Design Document/WeatherBalloon/_weather___balloon_8cpp_a63f902cc1f2e24f8a484f7ef780dda08_icgraph.png

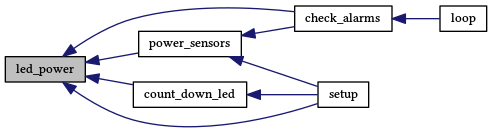
Weather_Balloon/Documentation/Design Document/WeatherBalloon/_weather___balloon_8cpp_a63f902cc1f2e24f8a484f7ef780dda08_icgraph.png
