rasusmilch/HAB/Weather_Balloon/Documentation/Design Document/WeatherBalloon/_weather___balloon_8cpp_a538a7506e344ec9bf046564b160e9e7f_icgraph.png

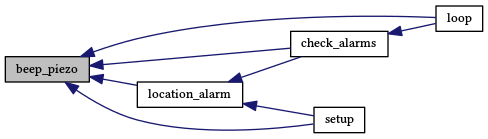
Weather_Balloon/Documentation/Design Document/WeatherBalloon/_weather___balloon_8cpp_a538a7506e344ec9bf046564b160e9e7f_icgraph.png
