rasusmilch/HAB/Weather_Balloon_Info/2016-09-12 19.48.49.jpg

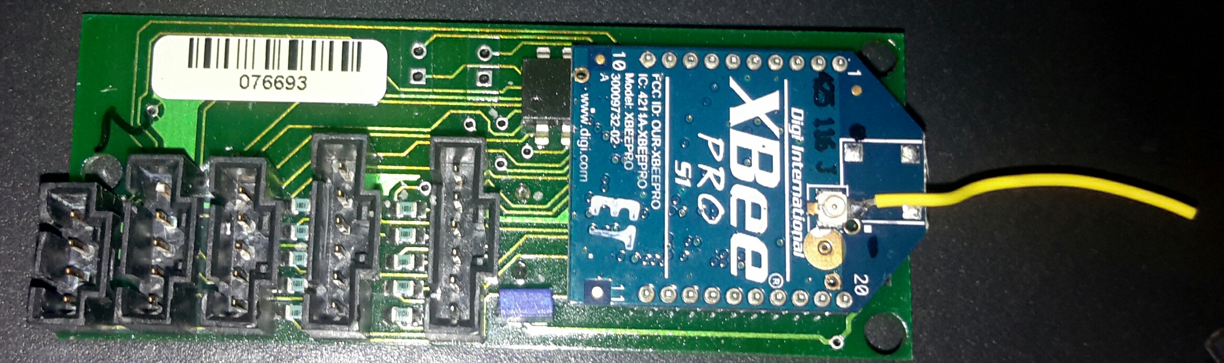
Weather_Balloon_Info/2016-09-12 19.48.49.jpg
