rasusmilch/HAB/Weather_Balloon_Info/20160920_234428.jpg

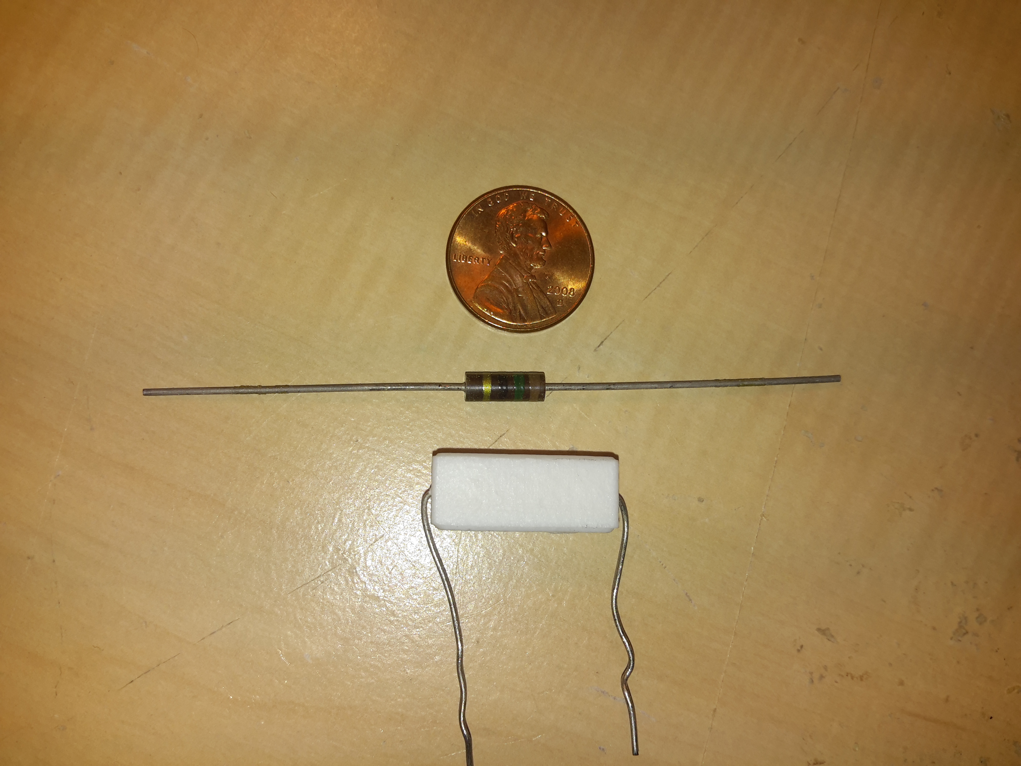
Weather_Balloon_Info/20160920_234428.jpg
