rasusmilch/HAB/Weather_Balloon_Info/analog - Ultra low power_ simple flashing circuit - Electrical Engineering Stack Exchange_files/htPjV.jpg

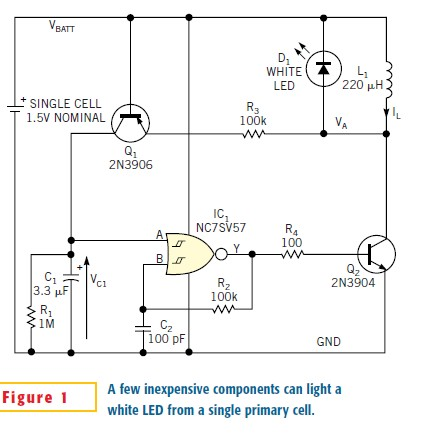
Weather_Balloon_Info/analog - Ultra low power_ simple flashing circuit - Electrical Engineering Stack Exchange_files/htPjV.jpg
