rasusmilch/HAB/Weather_Balloon_Info/analog - Ultra low power_ simple flashing circuit - Electrical Engineering Stack Exchange_files/vi6JC.jpg

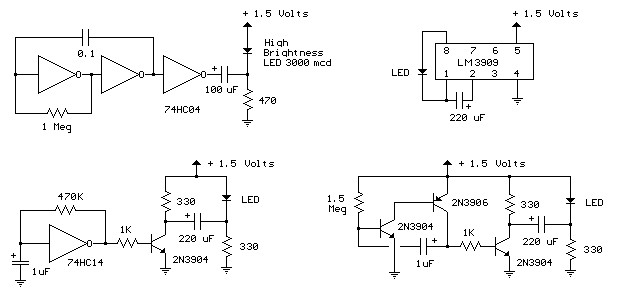
Weather_Balloon_Info/analog - Ultra low power_ simple flashing circuit - Electrical Engineering Stack Exchange_files/vi6JC.jpg
