rasusmilch/HAB/Weather_Balloon_Info/APRS/Mini-schematic.png

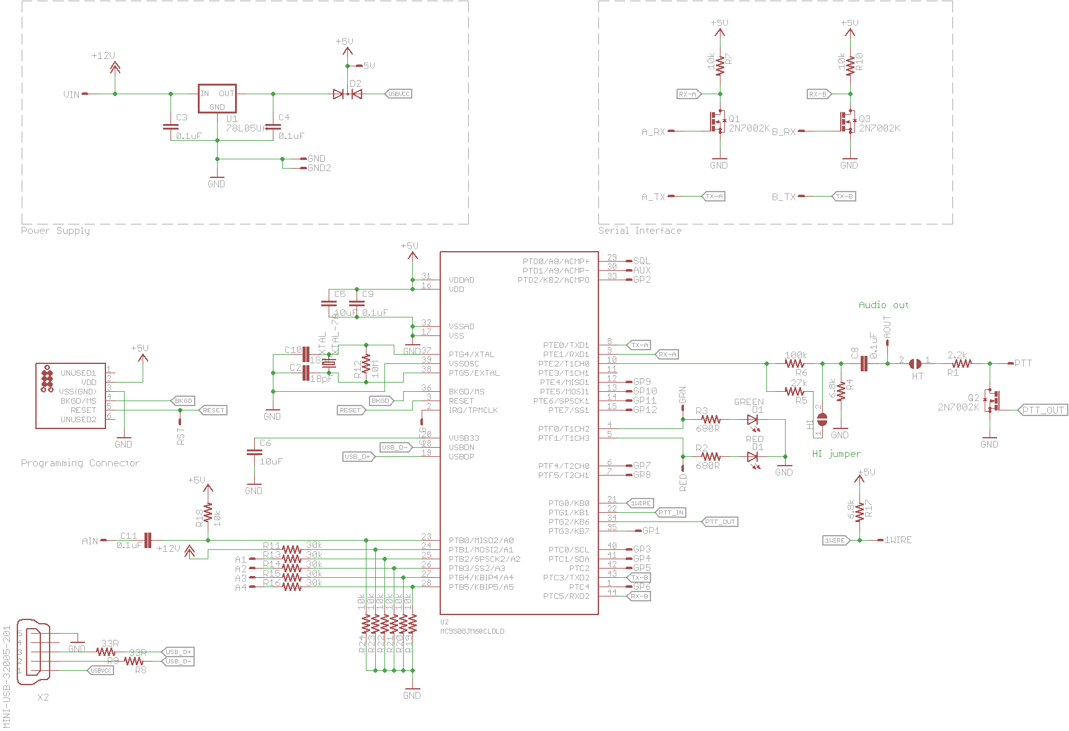
Weather_Balloon_Info/APRS/Mini-schematic.png
