rasusmilch/HAB/Weather_Balloon_Info/APRS/Radioshield2-schematic.png

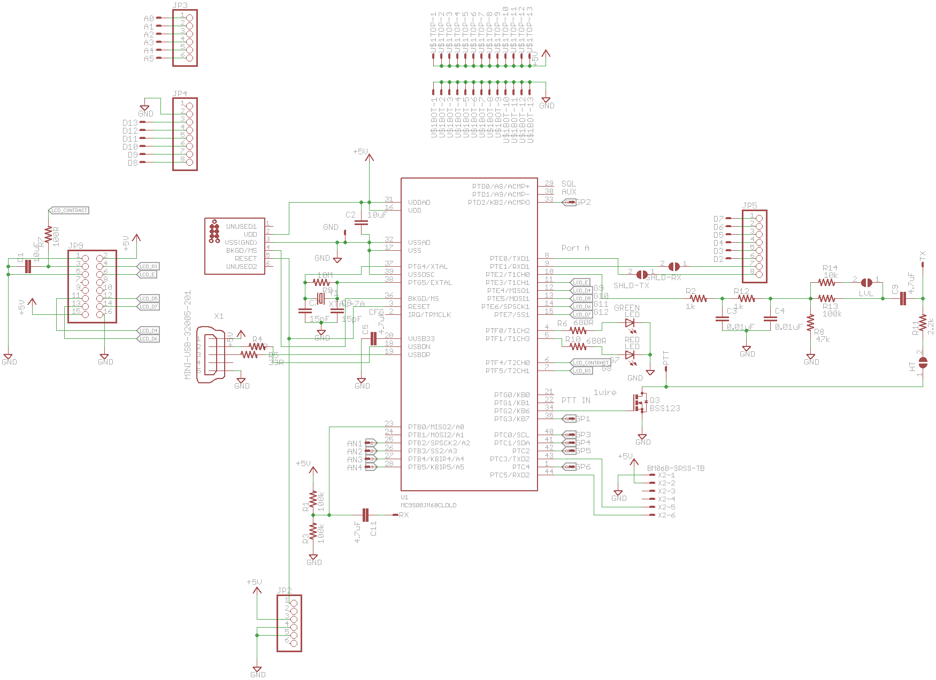
Weather_Balloon_Info/APRS/Radioshield2-schematic.png
