rasusmilch/HAB/Weather_Balloon_Info/atmosphere-composition-all.png

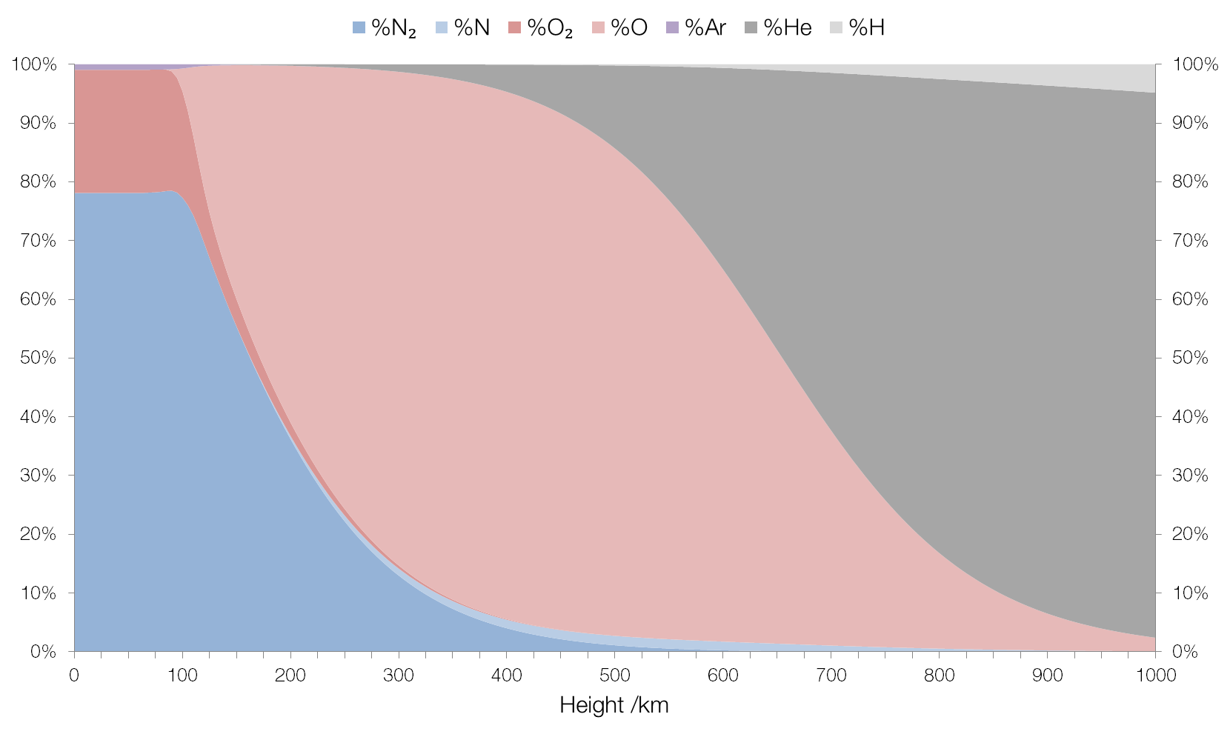
Weather_Balloon_Info/atmosphere-composition-all.png
