rasusmilch/HAB/Weather_Balloon_Info/AVR/Attiny85 Pinout.png

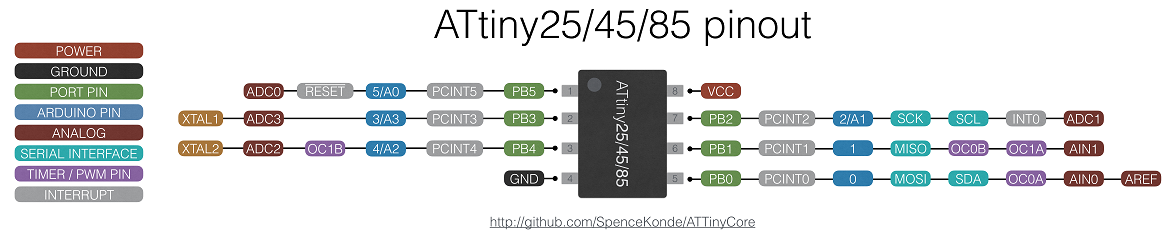
Weather_Balloon_Info/AVR/Attiny85 Pinout.png
