rasusmilch/HAB/Weather_Balloon_Info/Cellular_Modem/adafruit_products_808schem.png

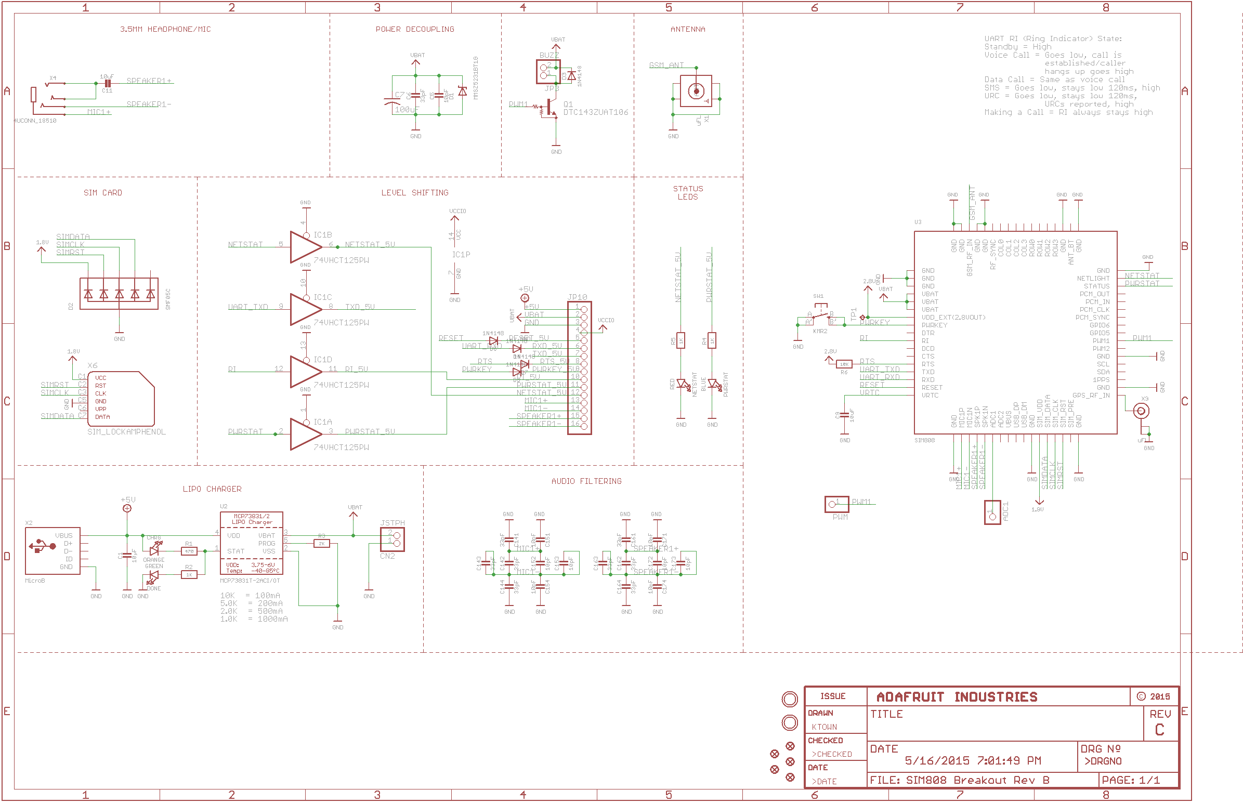
Weather_Balloon_Info/Cellular_Modem/adafruit_products_808schem.png
