rasusmilch/HAB/Weather_Balloon_Info/common-gases.png

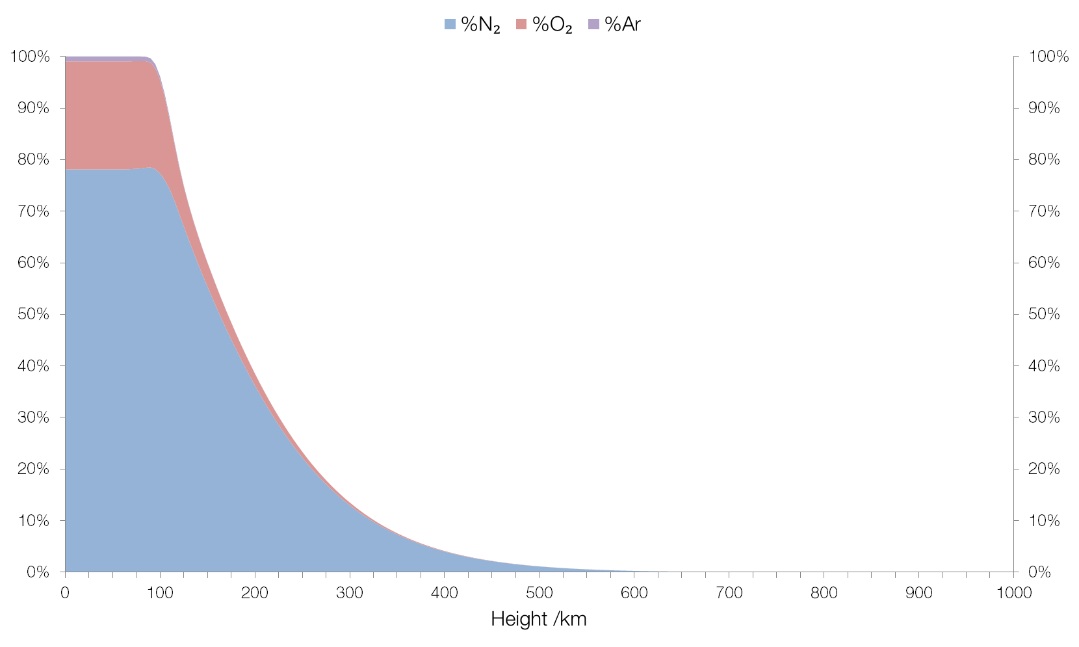
Weather_Balloon_Info/common-gases.png
