rasusmilch/HAB/Weather_Balloon_Info/Data Logging Shield Rev A/adafruit_products_adafruitlogshieldsch.png

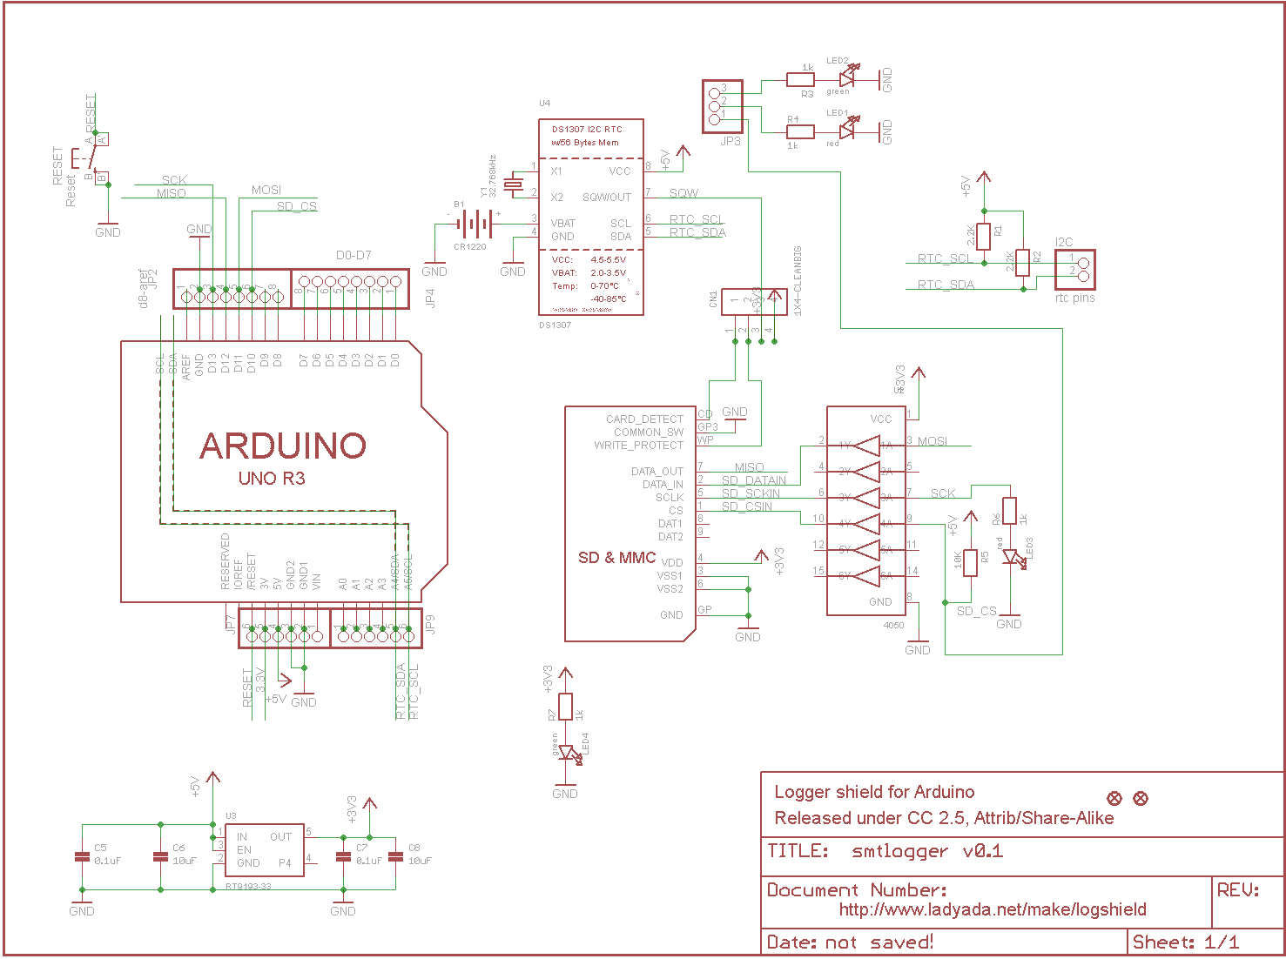
Weather_Balloon_Info/Data Logging Shield Rev A/adafruit_products_adafruitlogshieldsch.png
