rasusmilch/HAB/Weather_Balloon_Info/Radios/SI4432-Wireless-Module_PinOut.png

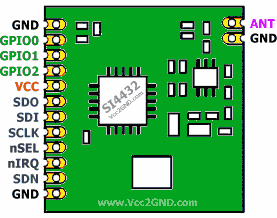
Weather_Balloon_Info/Radios/SI4432-Wireless-Module_PinOut.png
