rasusmilch/HAB/Weather_Balloon_Info/Radios/SKU122791d.jpg

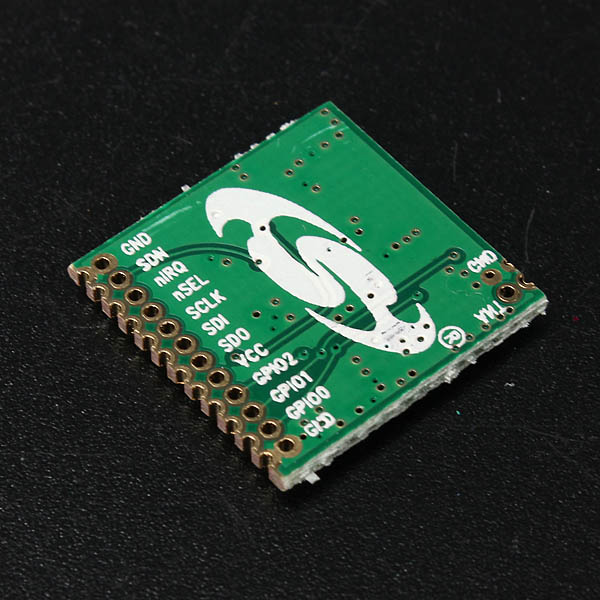
Weather_Balloon_Info/Radios/SKU122791d.jpg
