rasusmilch/HAB/Weather_Balloon_Info/uncommon-gases.png

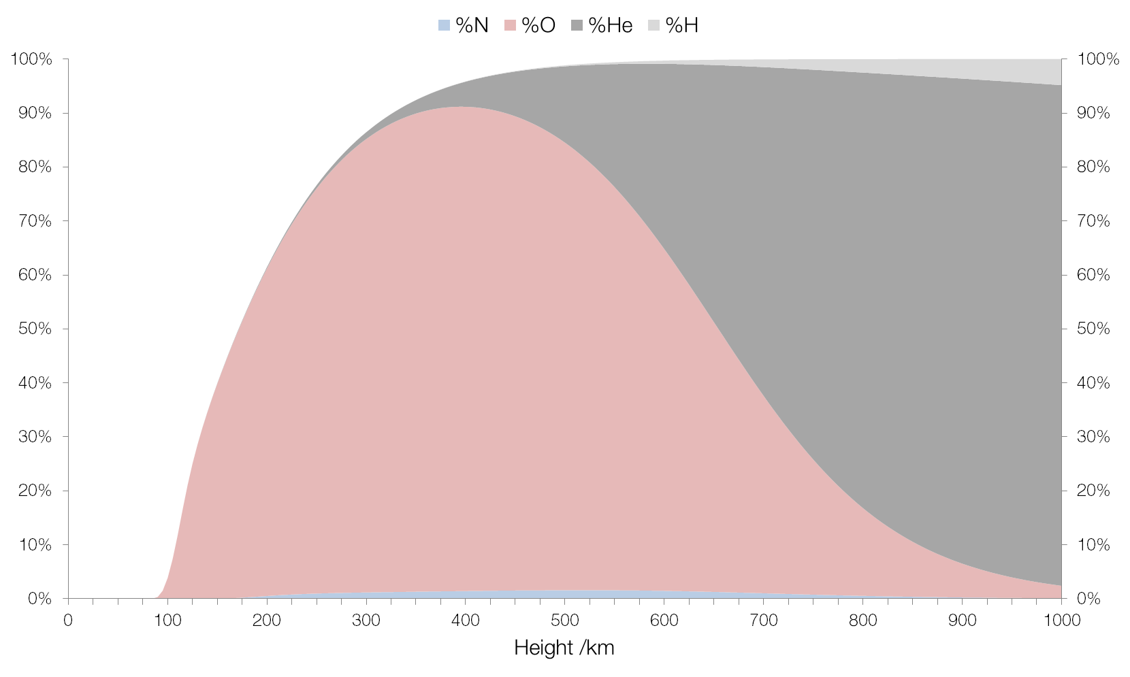
Weather_Balloon_Info/uncommon-gases.png
