rasusmilch/HAB/Weather_Balloon/Documentation/UML_Doxygen/latex/md_Weather_Balloon_library_Firmata_test_readme.tex

\#\+Testing Firmata

Tests tests are written using the \href{https://github.com/mmurdoch/arduinounit}{\tt Arduino\+Unit} library (version 2.\+0).

Follow the instructions in the https\+://github.com/mmurdoch/arduinounit/blob/master/readme.\+md \char`\"{}\+Arduino\+Unit readme\char`\"{} to install the library.

Compile and upload the test sketch as you would any other sketch. Then open the Serial Monitor to view the test results.

If you make changes to \hyperlink{_firmata_8cpp}{Firmata.\+cpp}, run the tests in /test/ to ensure that your changes have not produced any unexpected errors.

You should also perform manual tests against actual hardware.
