rasusmilch/HAB/Weather_Balloon/Documentation/UML_Doxygen/latex/test_2readme_8md.tex

\hypertarget{test_2readme_8md}{}\section{Weather\+\_\+\+Balloon/library/\+Firmata/test/readme.md File Reference}
\label{test_2readme_8md}\index{Weather\+\_\+\+Balloon/library/\+Firmata/test/readme.\+md@{Weather\+\_\+\+Balloon/library/\+Firmata/test/readme.\+md}}
