rasusmilch/HAB/Weather_Balloon/Documentation/UML_Doxygen/latex/firmata_debug_8h.tex

\hypertarget{firmata_debug_8h}{}\section{Weather\+\_\+\+Balloon/library/\+Firmata/utility/firmata\+Debug.h File Reference}
\label{firmata_debug_8h}\index{Weather\+\_\+\+Balloon/library/\+Firmata/utility/firmata\+Debug.\+h@{Weather\+\_\+\+Balloon/library/\+Firmata/utility/firmata\+Debug.\+h}}
This graph shows which files directly or indirectly include this file\+:\nopagebreak
\begin{figure}[H]
\begin{center}
\leavevmode
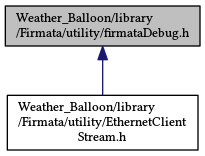
[picture p108: Weather_Balloon/Documentation/UML_Doxygen/html/firmata_debug_8h__dep__incl.png]

\end{center}
\end{figure}
\subsection*{Macros}
\begin{DoxyCompactItemize}
\item 
\#define \hyperlink{firmata_debug_8h_aa13ce4e79fa7e62c8716cc31e158e5a6}{D\+E\+B\+U\+G\+\_\+\+B\+E\+G\+IN}(baud)
\item 
\#define \hyperlink{firmata_debug_8h_a8e30ff0704664fcb13dabf0c4dc5c8f5}{D\+E\+B\+U\+G\+\_\+\+P\+R\+I\+N\+T\+LN}(x)
\item 
\#define \hyperlink{firmata_debug_8h_af6551f0b4c3964c3128f808e7bf987c7}{D\+E\+B\+U\+G\+\_\+\+P\+R\+I\+NT}(x)
\end{DoxyCompactItemize}

\subsection{Macro Definition Documentation}
\index{firmata\+Debug.\+h@{firmata\+Debug.\+h}!D\+E\+B\+U\+G\+\_\+\+B\+E\+G\+IN@{D\+E\+B\+U\+G\+\_\+\+B\+E\+G\+IN}}
\index{D\+E\+B\+U\+G\+\_\+\+B\+E\+G\+IN@{D\+E\+B\+U\+G\+\_\+\+B\+E\+G\+IN}!firmata\+Debug.\+h@{firmata\+Debug.\+h}}
\subsubsection[{\texorpdfstring{D\+E\+B\+U\+G\+\_\+\+B\+E\+G\+IN}{DEBUG\_BEGIN}}]{\setlength{\rightskip}{0pt plus 5cm}\#define D\+E\+B\+U\+G\+\_\+\+B\+E\+G\+IN(
\begin{DoxyParamCaption}
\item[{}]{baud}
\end{DoxyParamCaption}
)}\hypertarget{firmata_debug_8h_aa13ce4e79fa7e62c8716cc31e158e5a6}{}\label{firmata_debug_8h_aa13ce4e79fa7e62c8716cc31e158e5a6}

Definition at line 9 of file firmata\+Debug.\+h.

\index{firmata\+Debug.\+h@{firmata\+Debug.\+h}!D\+E\+B\+U\+G\+\_\+\+P\+R\+I\+NT@{D\+E\+B\+U\+G\+\_\+\+P\+R\+I\+NT}}
\index{D\+E\+B\+U\+G\+\_\+\+P\+R\+I\+NT@{D\+E\+B\+U\+G\+\_\+\+P\+R\+I\+NT}!firmata\+Debug.\+h@{firmata\+Debug.\+h}}
\subsubsection[{\texorpdfstring{D\+E\+B\+U\+G\+\_\+\+P\+R\+I\+NT}{DEBUG\_PRINT}}]{\setlength{\rightskip}{0pt plus 5cm}\#define D\+E\+B\+U\+G\+\_\+\+P\+R\+I\+NT(
\begin{DoxyParamCaption}
\item[{}]{x}
\end{DoxyParamCaption}
)}\hypertarget{firmata_debug_8h_af6551f0b4c3964c3128f808e7bf987c7}{}\label{firmata_debug_8h_af6551f0b4c3964c3128f808e7bf987c7}

Definition at line 11 of file firmata\+Debug.\+h.

\index{firmata\+Debug.\+h@{firmata\+Debug.\+h}!D\+E\+B\+U\+G\+\_\+\+P\+R\+I\+N\+T\+LN@{D\+E\+B\+U\+G\+\_\+\+P\+R\+I\+N\+T\+LN}}
\index{D\+E\+B\+U\+G\+\_\+\+P\+R\+I\+N\+T\+LN@{D\+E\+B\+U\+G\+\_\+\+P\+R\+I\+N\+T\+LN}!firmata\+Debug.\+h@{firmata\+Debug.\+h}}
\subsubsection[{\texorpdfstring{D\+E\+B\+U\+G\+\_\+\+P\+R\+I\+N\+T\+LN}{DEBUG\_PRINTLN}}]{\setlength{\rightskip}{0pt plus 5cm}\#define D\+E\+B\+U\+G\+\_\+\+P\+R\+I\+N\+T\+LN(
\begin{DoxyParamCaption}
\item[{}]{x}
\end{DoxyParamCaption}
)}\hypertarget{firmata_debug_8h_a8e30ff0704664fcb13dabf0c4dc5c8f5}{}\label{firmata_debug_8h_a8e30ff0704664fcb13dabf0c4dc5c8f5}

Definition at line 10 of file firmata\+Debug.\+h.

Referenced by Ethernet\+Client\+Stream\+::maintain().
