rasusmilch/HAB/Weather_Balloon/Documentation/UML_Doxygen/latex/firmata_debug_8h__dep__incl.pdf

Weather_Balloon/library
/Firmata/utility/firmataDebug.h

Weather_Balloon/library
/Firmata/utility/EthernetClient Stream.h
