rasusmilch/HAB/Weather_Balloon_Info/APRS/BoardOverview.pdf

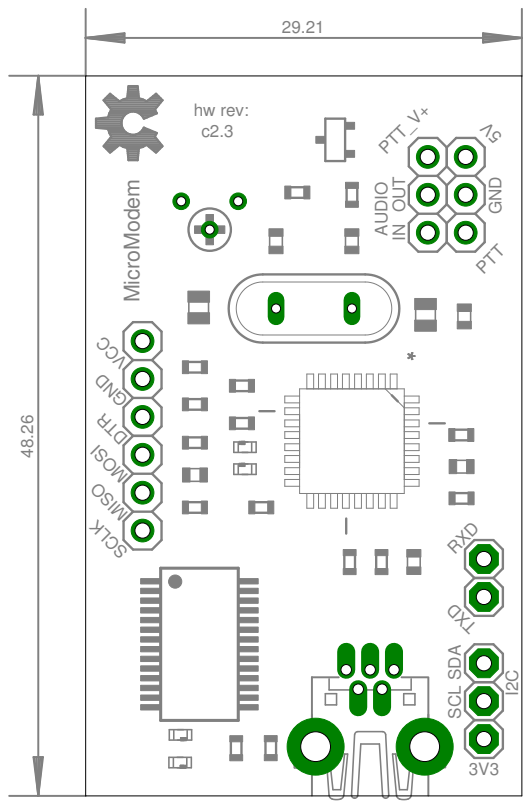
[picture p109: page 1]

OUT IN PT _V+ 5V GND PT MicroModem hw rev: M SI O SCLK MOSI DTRGNDVCC I2C AUDIO c2.3 * SDA SCL RXD TXD 3V3 48.26 29.21 *
