rasusmilch/HAB/Weather_Balloon_Info/APRS/Schematic.pdf

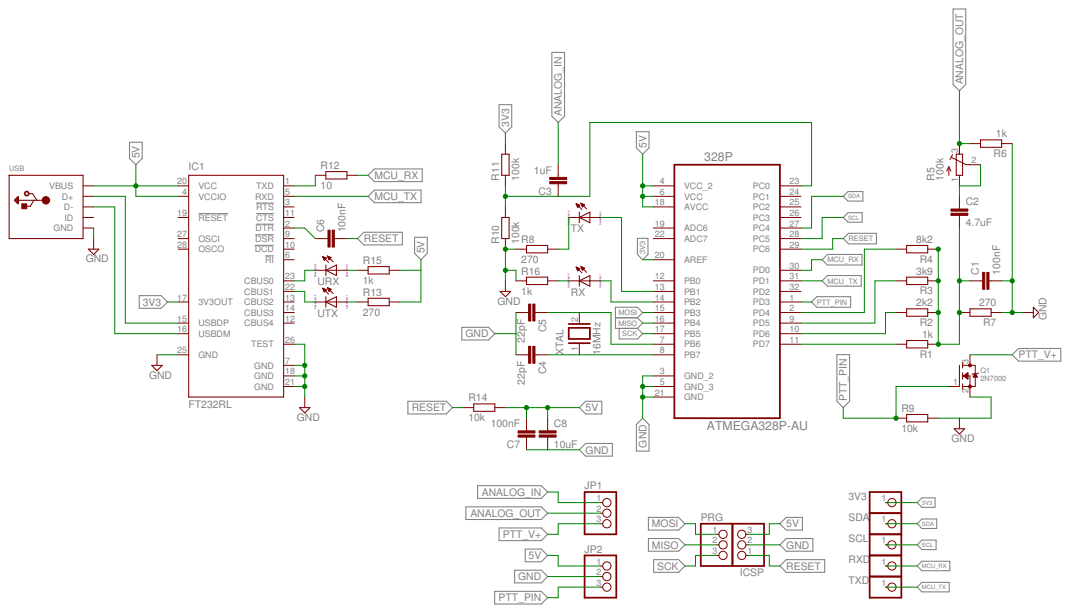
[picture p110: page 1]

SpiceOrder 2 SpiceOrder 1 SpiceOrder 2 SpiceOrder 1 SpiceOrder 2 SpiceOrder 1 SpiceOrder 2 SpiceOrder 1 FT232RL 1k 2k2 3k9 8k2 1k 270 270 10k 100k 100k 2N7000 GND 100k 100nF 1uF 4.7uF GNGND D 16MHz 22pF 22pF 10 GND GND 270 GND 100nF 10k 100nF 10uF ATMEGA328P-AU 1k 1k IC1VCC 20 3V3OUT 17 USBDP 15 USBDM 16 OSCO 28 OSCI 27 GND 7 TXD 1 RXD 5 RTS 3 CTS 11 DTR 2 DSR 9 DCD 10 RI 6 CBUS0 23 CBUS1 22 CBUS2 13 CBUS3 14 CBUS4 12 VCCIO 4 RESET 19 GND 25 GND 18 TEST 26 GND 21 R1 R2 R3 R4 R6 R7 R8 R9 R10 R11 Q1 1 2 3 R5 1 3 2 C1 C3 C2 TXRXJP1123 JP2123 XTAL 2 1 C4 C5 PRG123 ICSP 123 USB R12 D+D- VBUS GNDID URX UTX R13 C6 R14 C7 C8 VCC_2 4 VCC 6 AVCC 18 ADC6 19 ADC7 22 AREF 20 PB0 12 PB1 13 PB2 14 PB3 15 PB4 16 PB5 17 PB6 7 PB7 8 GND_2 3 GND_3 5 GND 21 PC0 23 PC1 24 PC2 25 PC3 26 PC4 27 PC5 28 PC6 29 PD0 30 PD1 31 PD2 32 PD3 1 PD4 2 PD5 9 PD6 10 PD7 11 328P SDA 1 SCL 1 RXD 1 TXD 1 3V3 1 R15 R16 GND GND GND GND GND ANALOG_OUT ANALOG_OUT PTT_V+ PTT_V+ 5V 5V 5V 5V 5V 5V ANALOG_IN ANALOG_IN PTT_PIN PTT_PIN PTT_PIN MCU_TX MCU_TX MCU_TX MCU_RX MCU_RX SCK MCU_RX SCK RESET RESET RESET RESET MOSI MOSI MISO MISO 3V3 3V3 3V3 3V3 SCL SCL SDA SDA
