rasusmilch/HAB/Weather_Balloon/Board/Weather Balloon-B.Fab.pdf

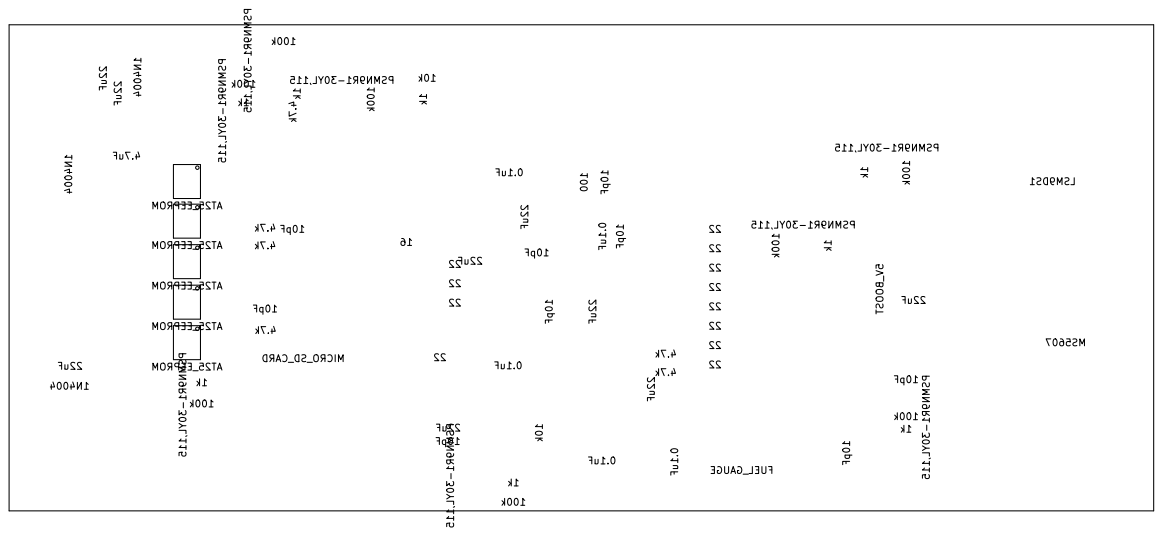
[picture p112: page 1]

File: Weather Balloon.kicad_pcb Sheet: Robert Susmilch 22uF

Id: 1/1 Title: High Altitude Balloon Controller
