rasusmilch/HAB/Weather_Balloon/Board/Weather Balloon-Margin.pdf

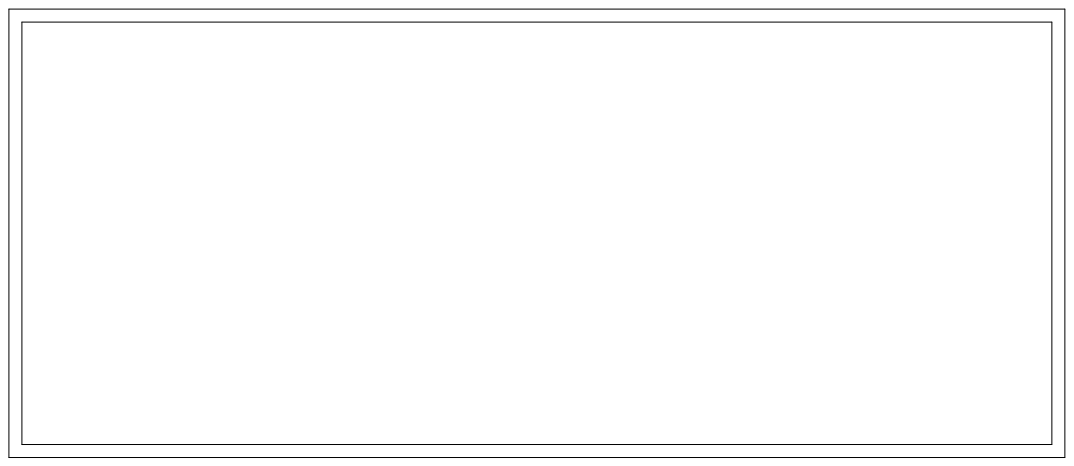
[picture p115: page 1]

File: Weather Balloon.kicad_pcb Sheet: Robert Susmilch

Id: 1/1 Title: High Altitude Balloon Controller
