rasusmilch/HAB/Weather_Balloon/Board/Weather Balloon.pdf

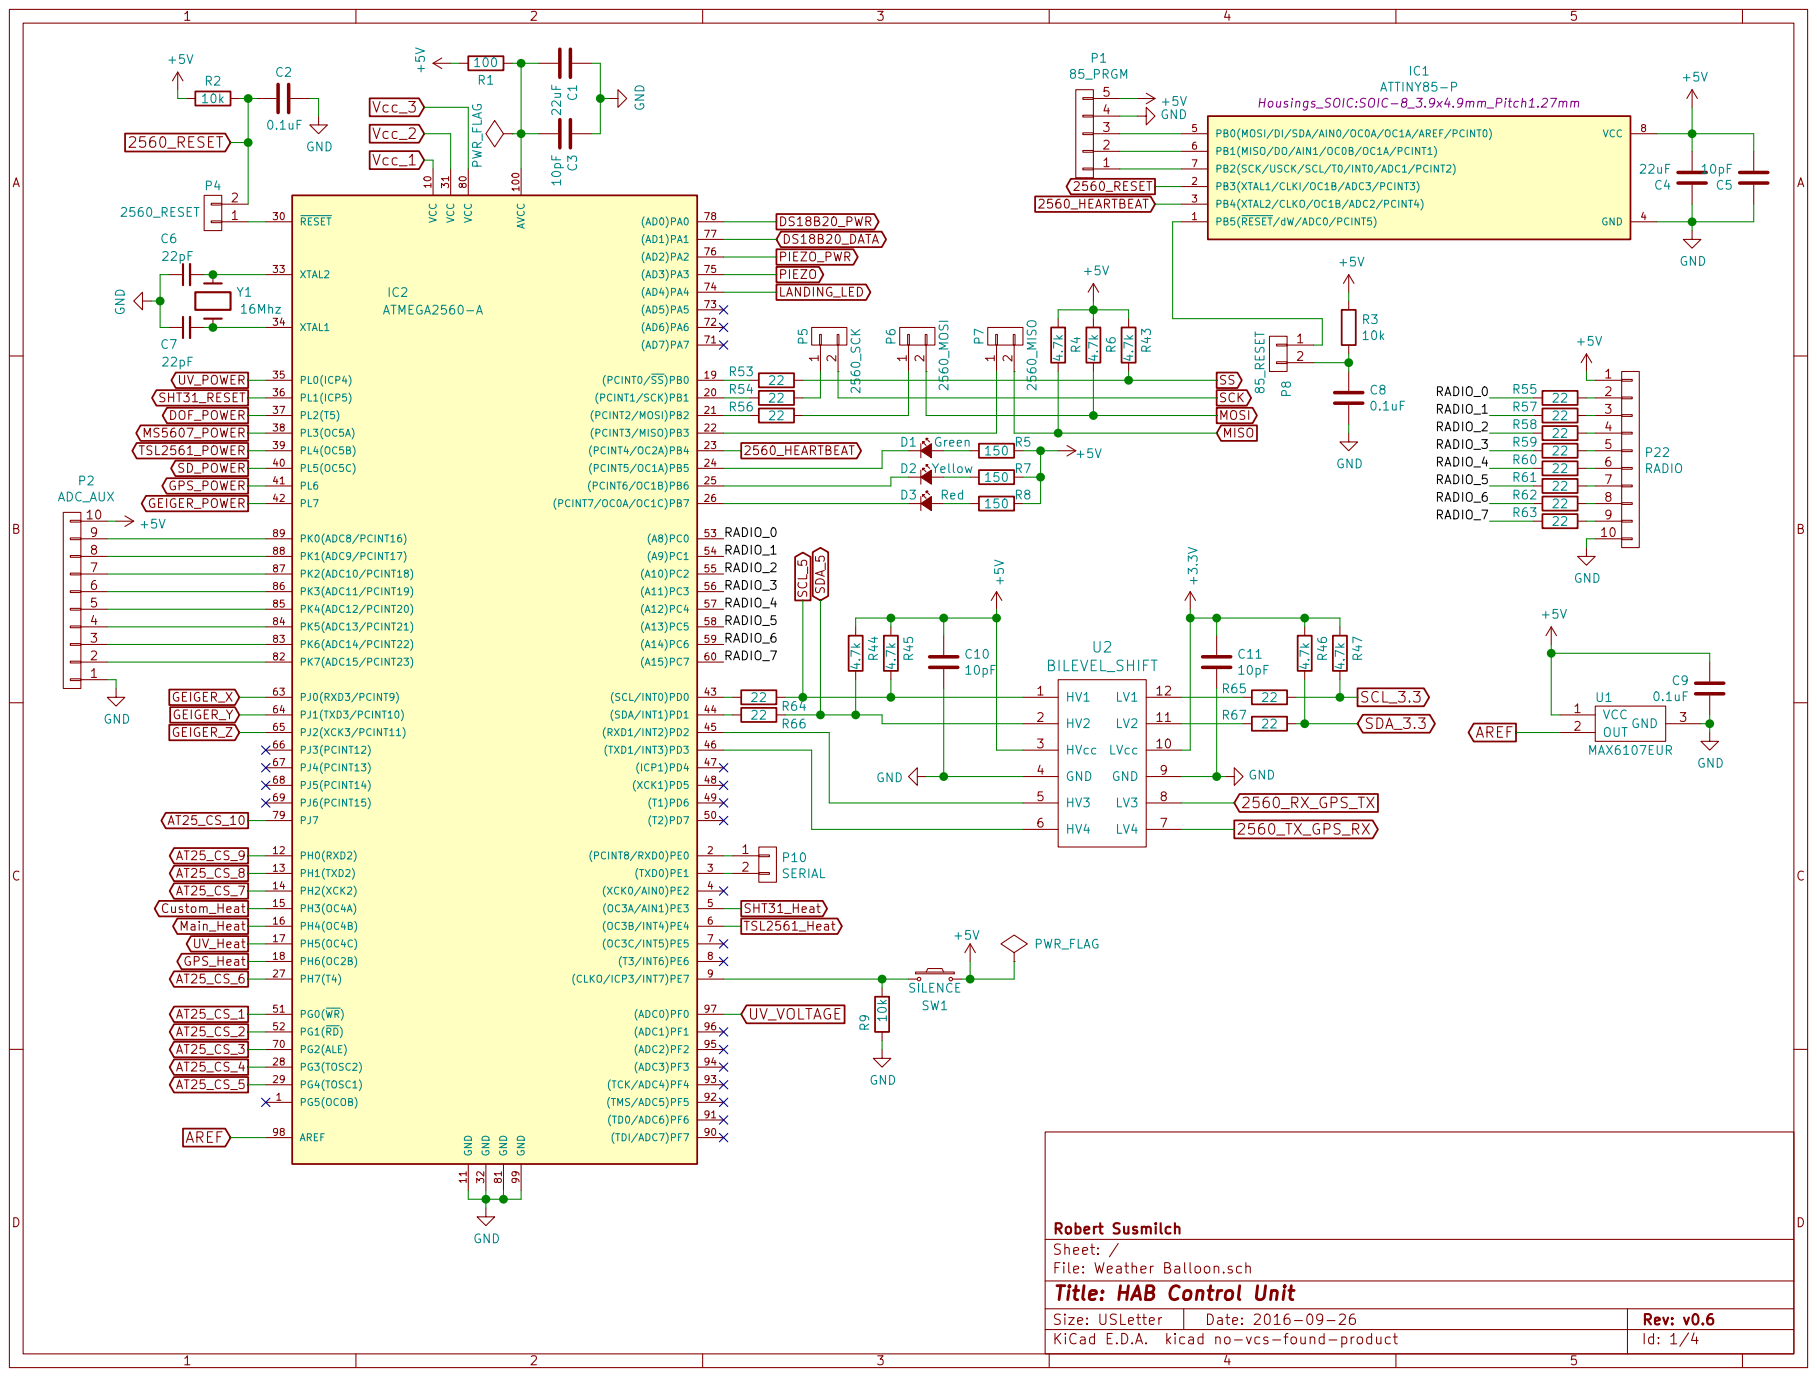
[picture p118: page 1]

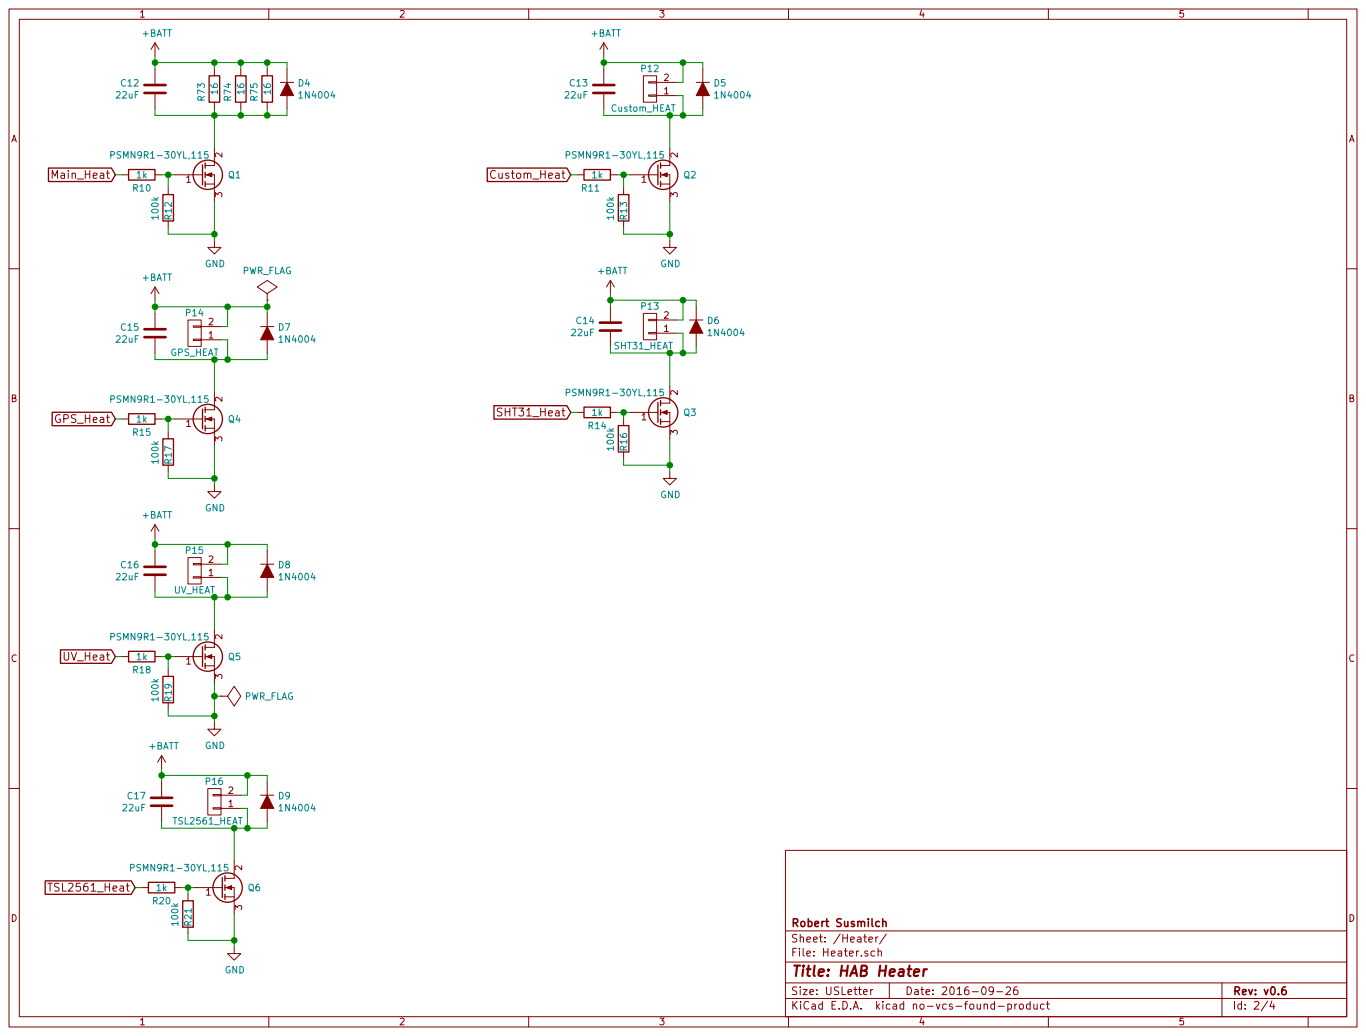
[picture p119: page 2]

Id: 2/4 Title: HAB Heater File: Heater.sch Sheet: /Heater/ Robert Susmilch

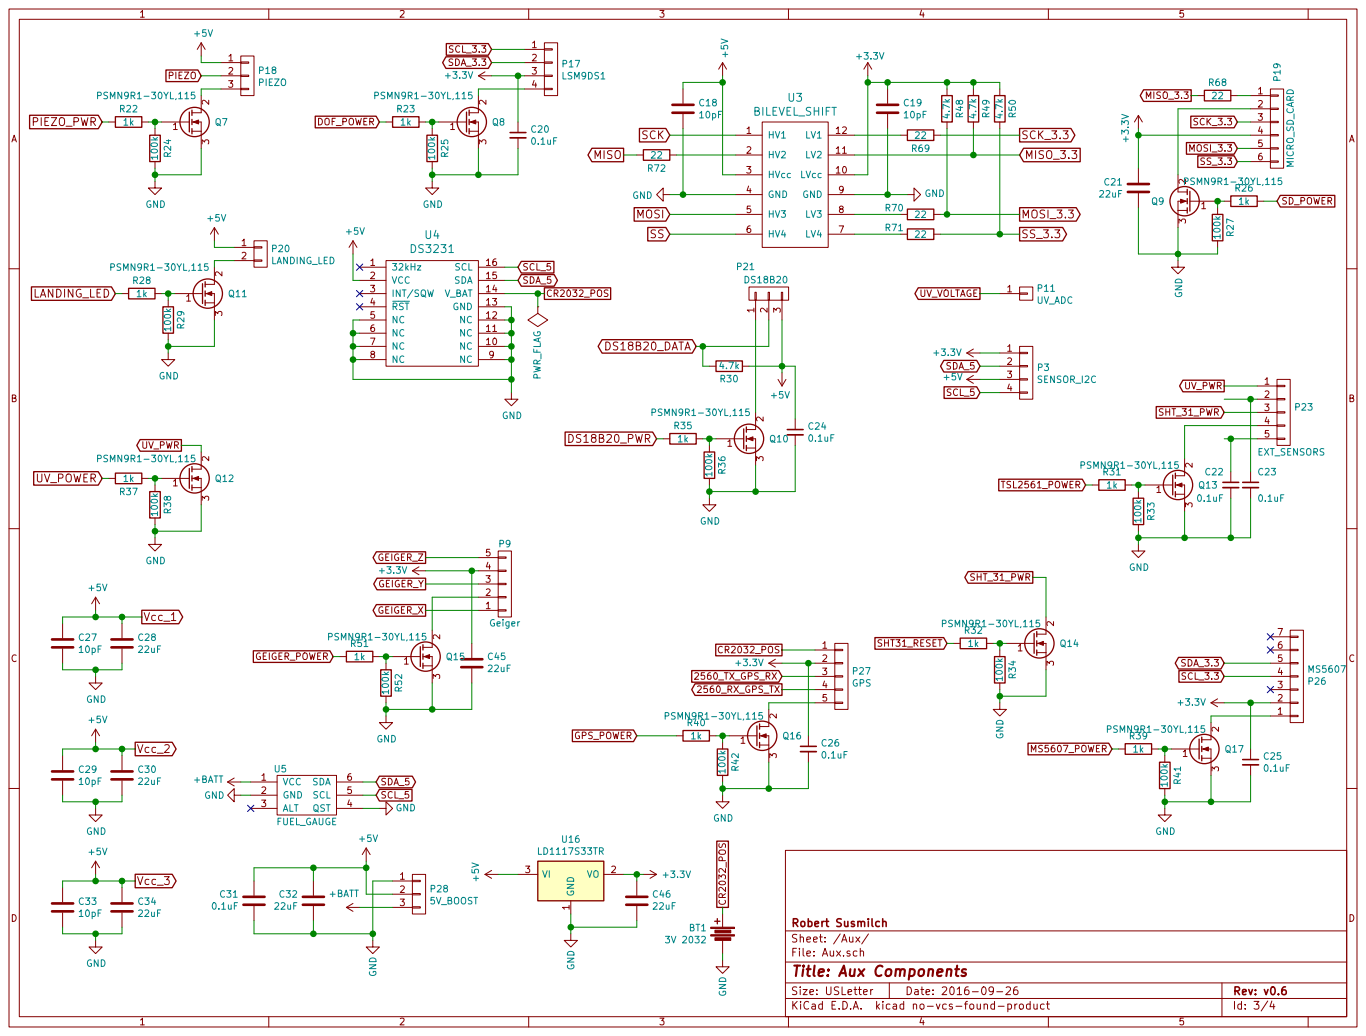
[picture p120: page 3]

File: Aux.sch Sheet: /Aux/ Robert Susmilch

Id: 3/4 Title: Aux Components

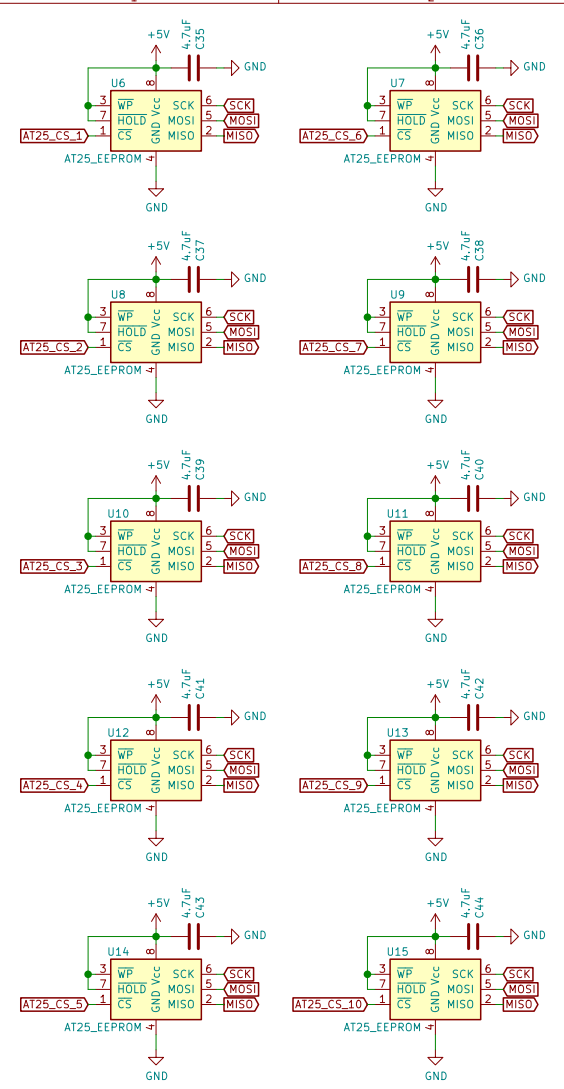
[picture p121: page 4]

To be used as backup to SD card for critical data.
Sheet: /AT25_EEPROM/ Robert Susmilch

File: AT25_EEPROM.sch
Id: 4/4 Title: Serial EEPROM Backup
