rasusmilch/HAB/Weather_Balloon_Info/APRS/BeRTOS_APRS.pdf

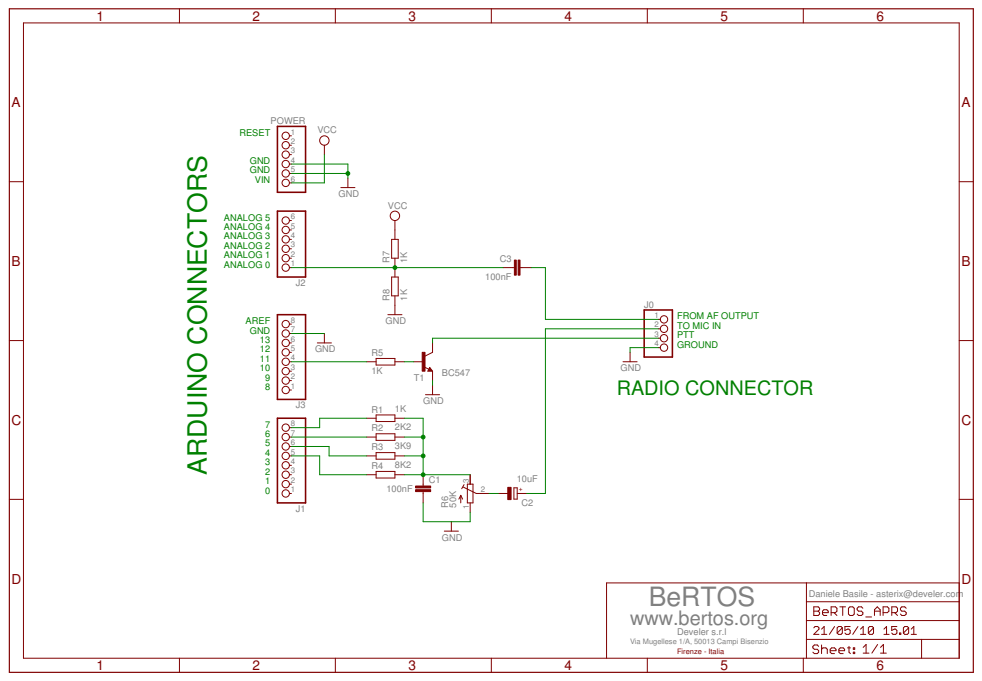
[picture p122: page 1]
