rasusmilch/HAB/Weather_Balloon/Board/HAB Back.pdf

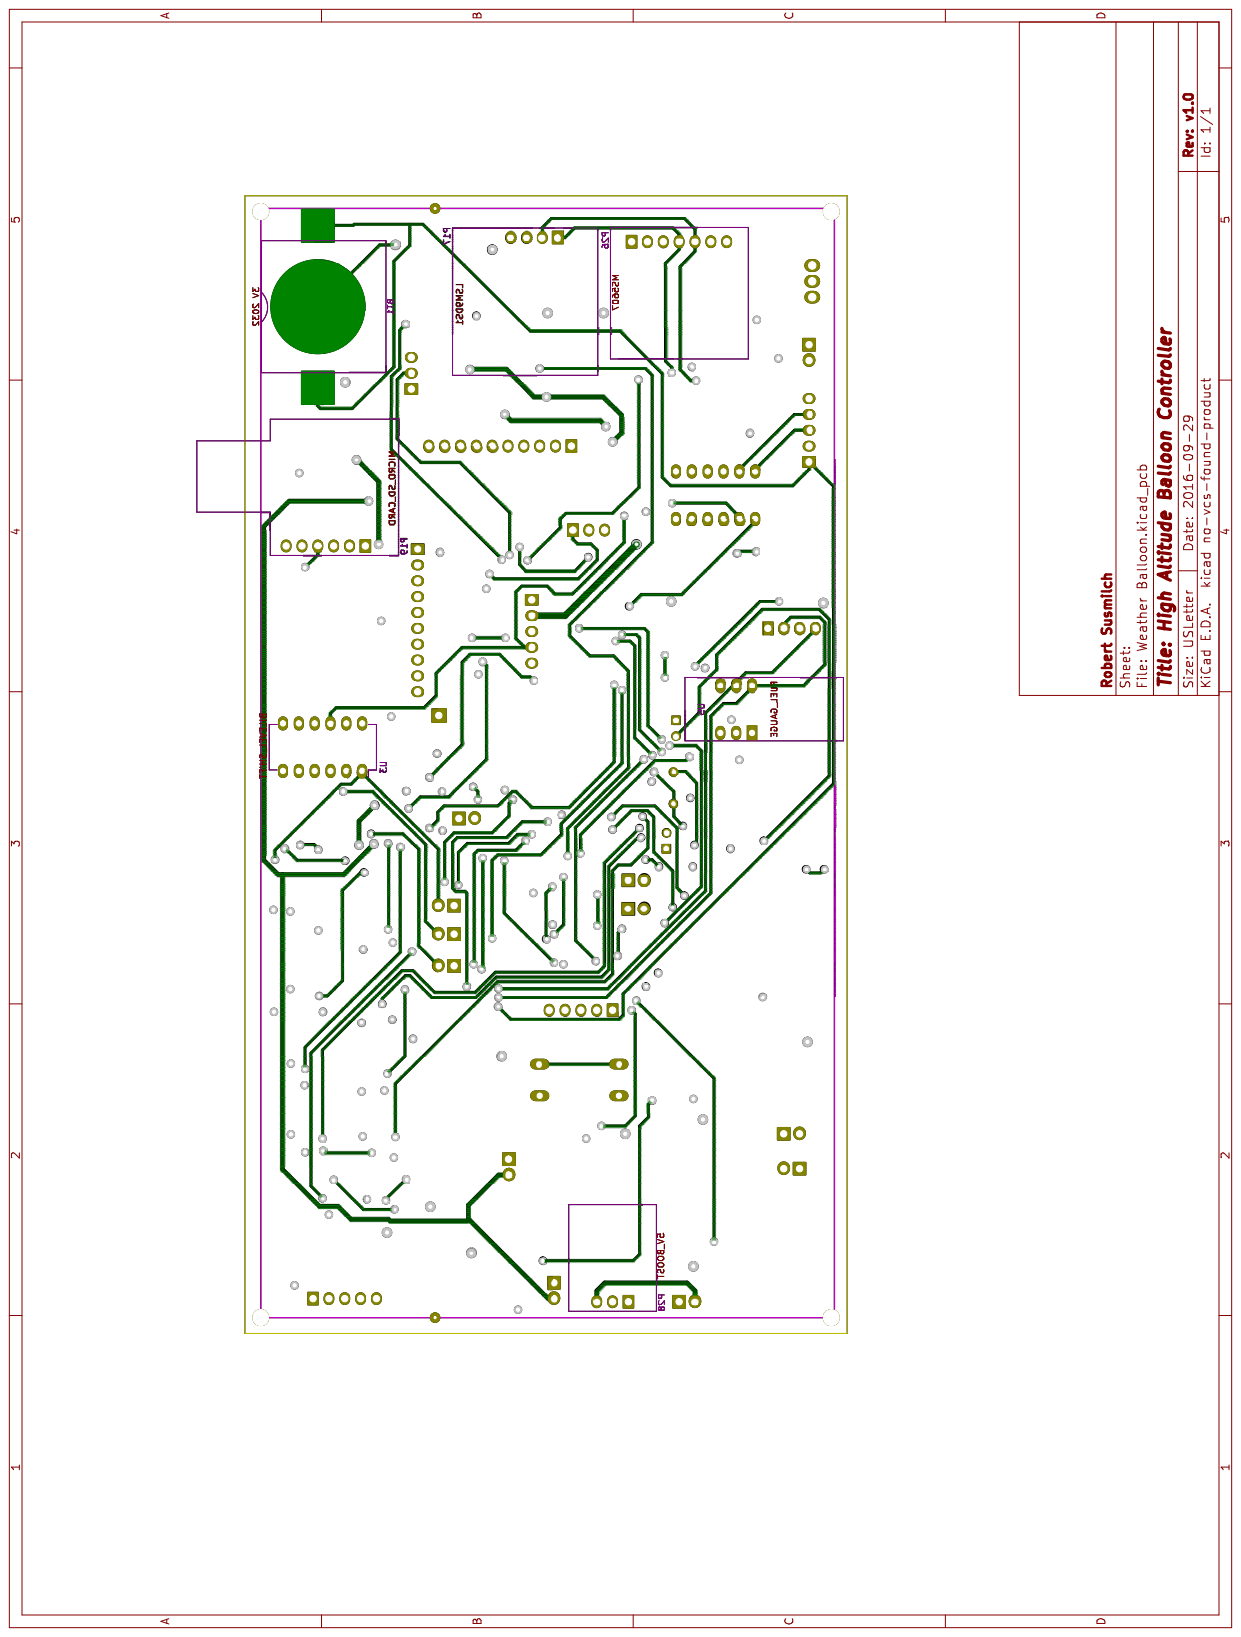
[picture p123: page 1]
