rasusmilch/HAB/Weather_Balloon/Board/Weather Balloon-F.SilkS.pdf

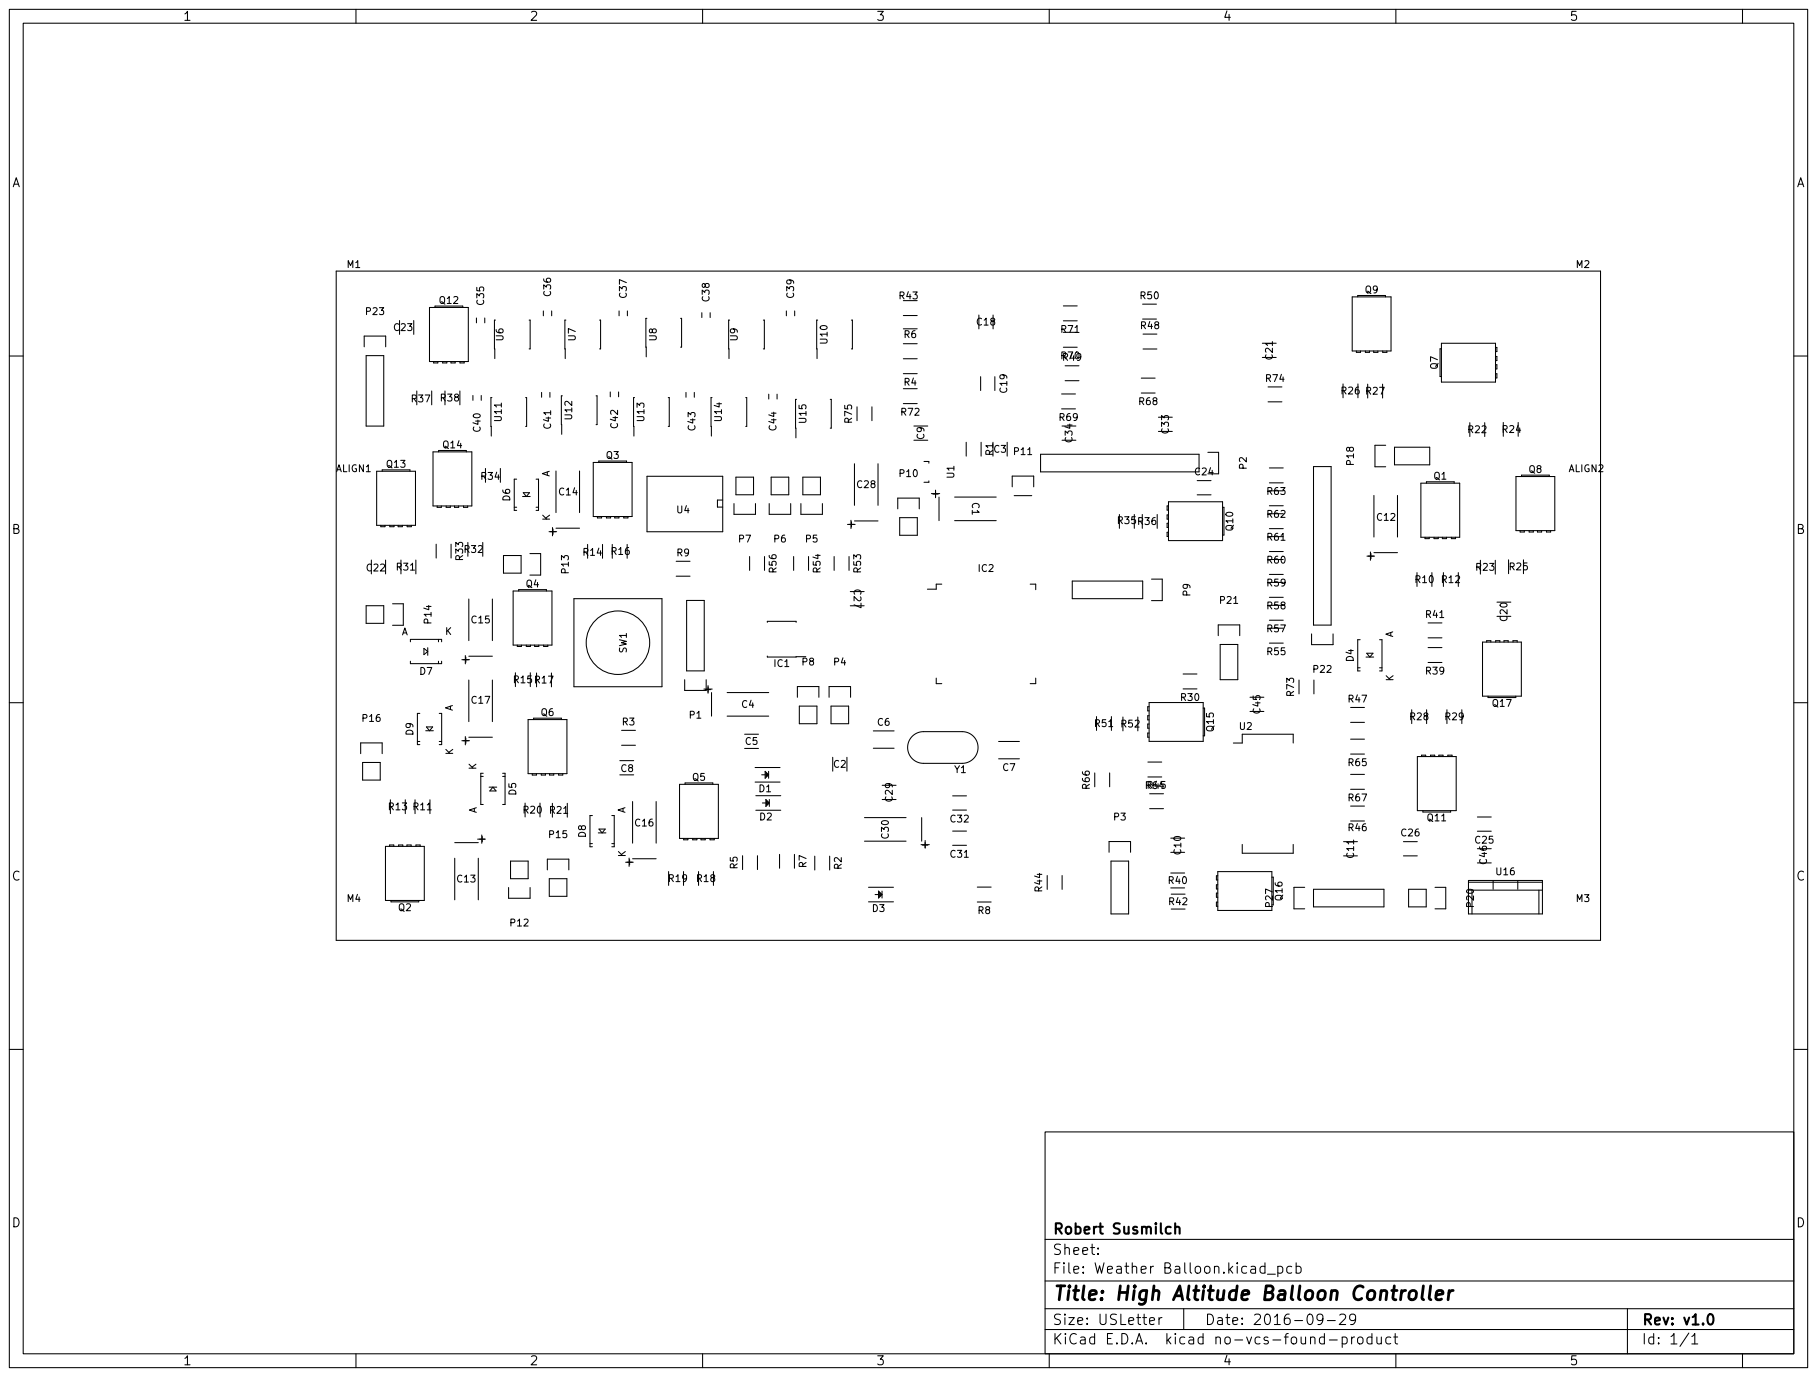
[picture p124: page 1]

Id: 1/1 Title: High Altitude Balloon Controller
