rasusmilch/HAB/Weather_Balloon_Info/GPS/SparkFun_Venus_GPS_Logger_v10.pdf

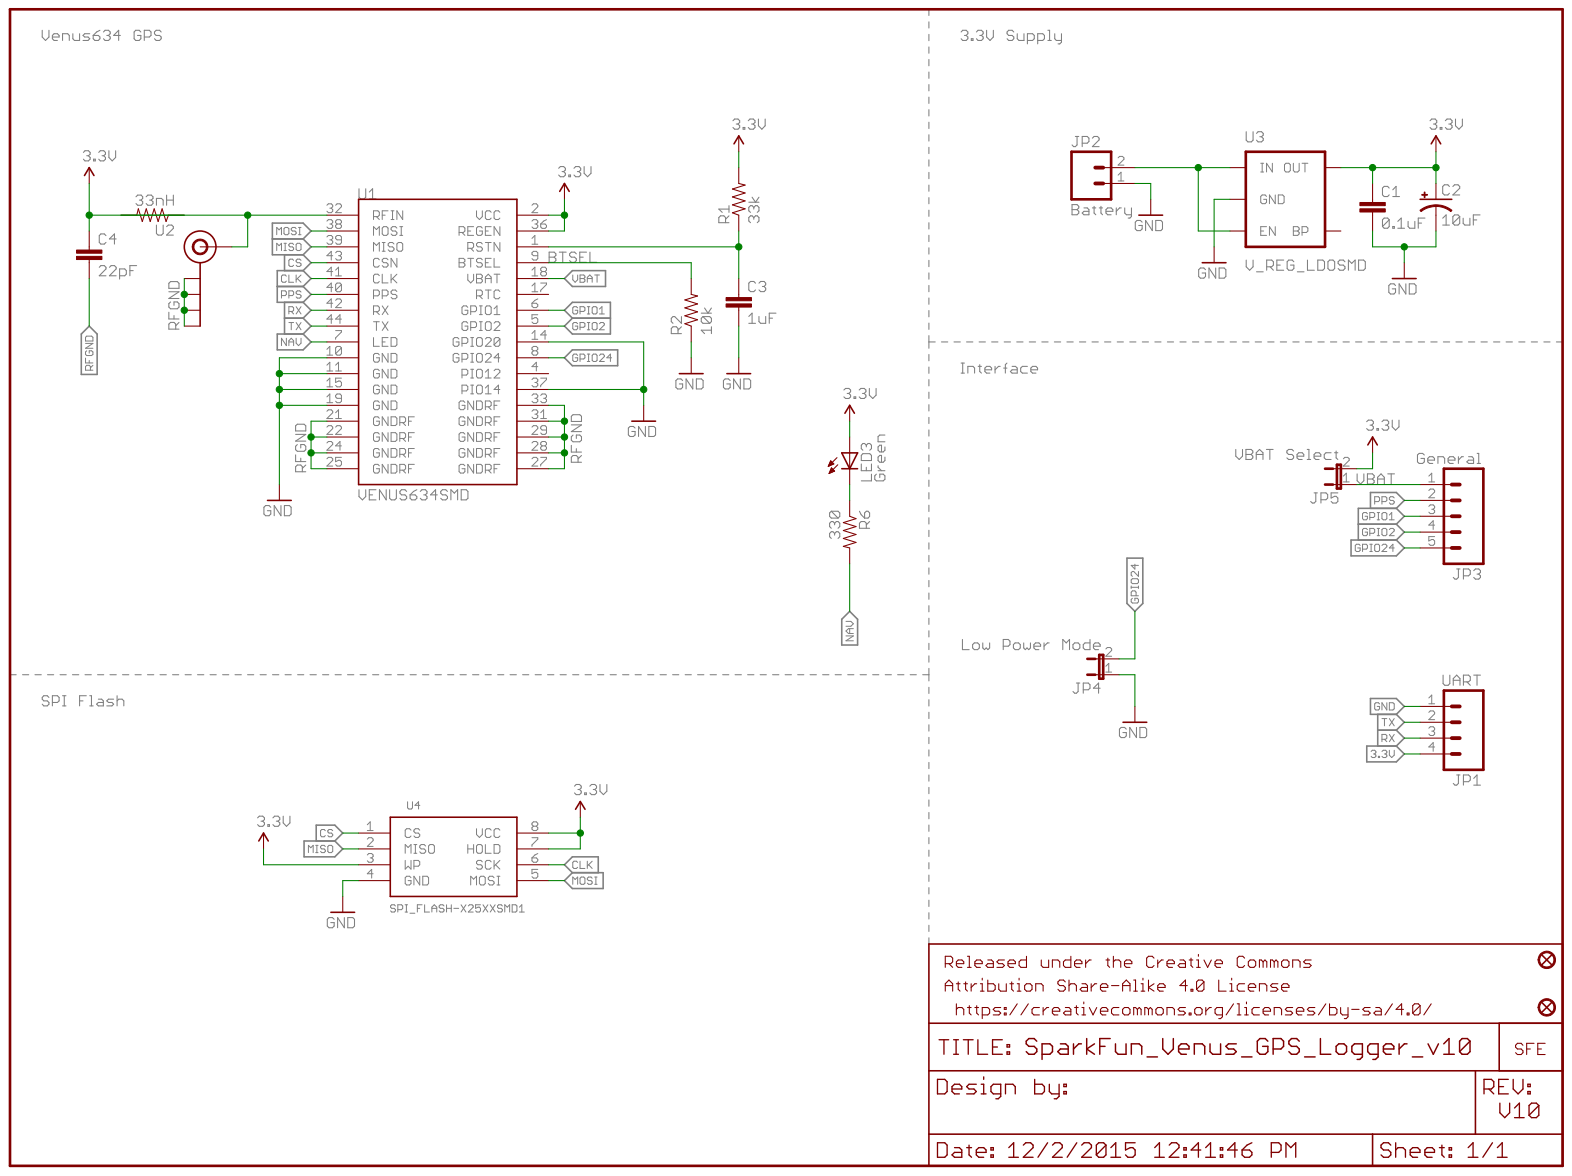
[picture p125: page 1]
