rasusmilch/HAB/(list of files, drawings)

Other design files:
Weather_Balloon/Board/Weather Balloon.dsn
Weather_Balloon_Info/APRS/ax25.pcb
Weather_Balloon_Info/APRS/ax25_single.pcb
