rasusmilch/HAB/Weather_Balloon/Board/Weather Balloon.kicad_pcb

## KiCad design Weather_Balloon/Board/Weather Balloon.kicad_pcb (2016-10-11)

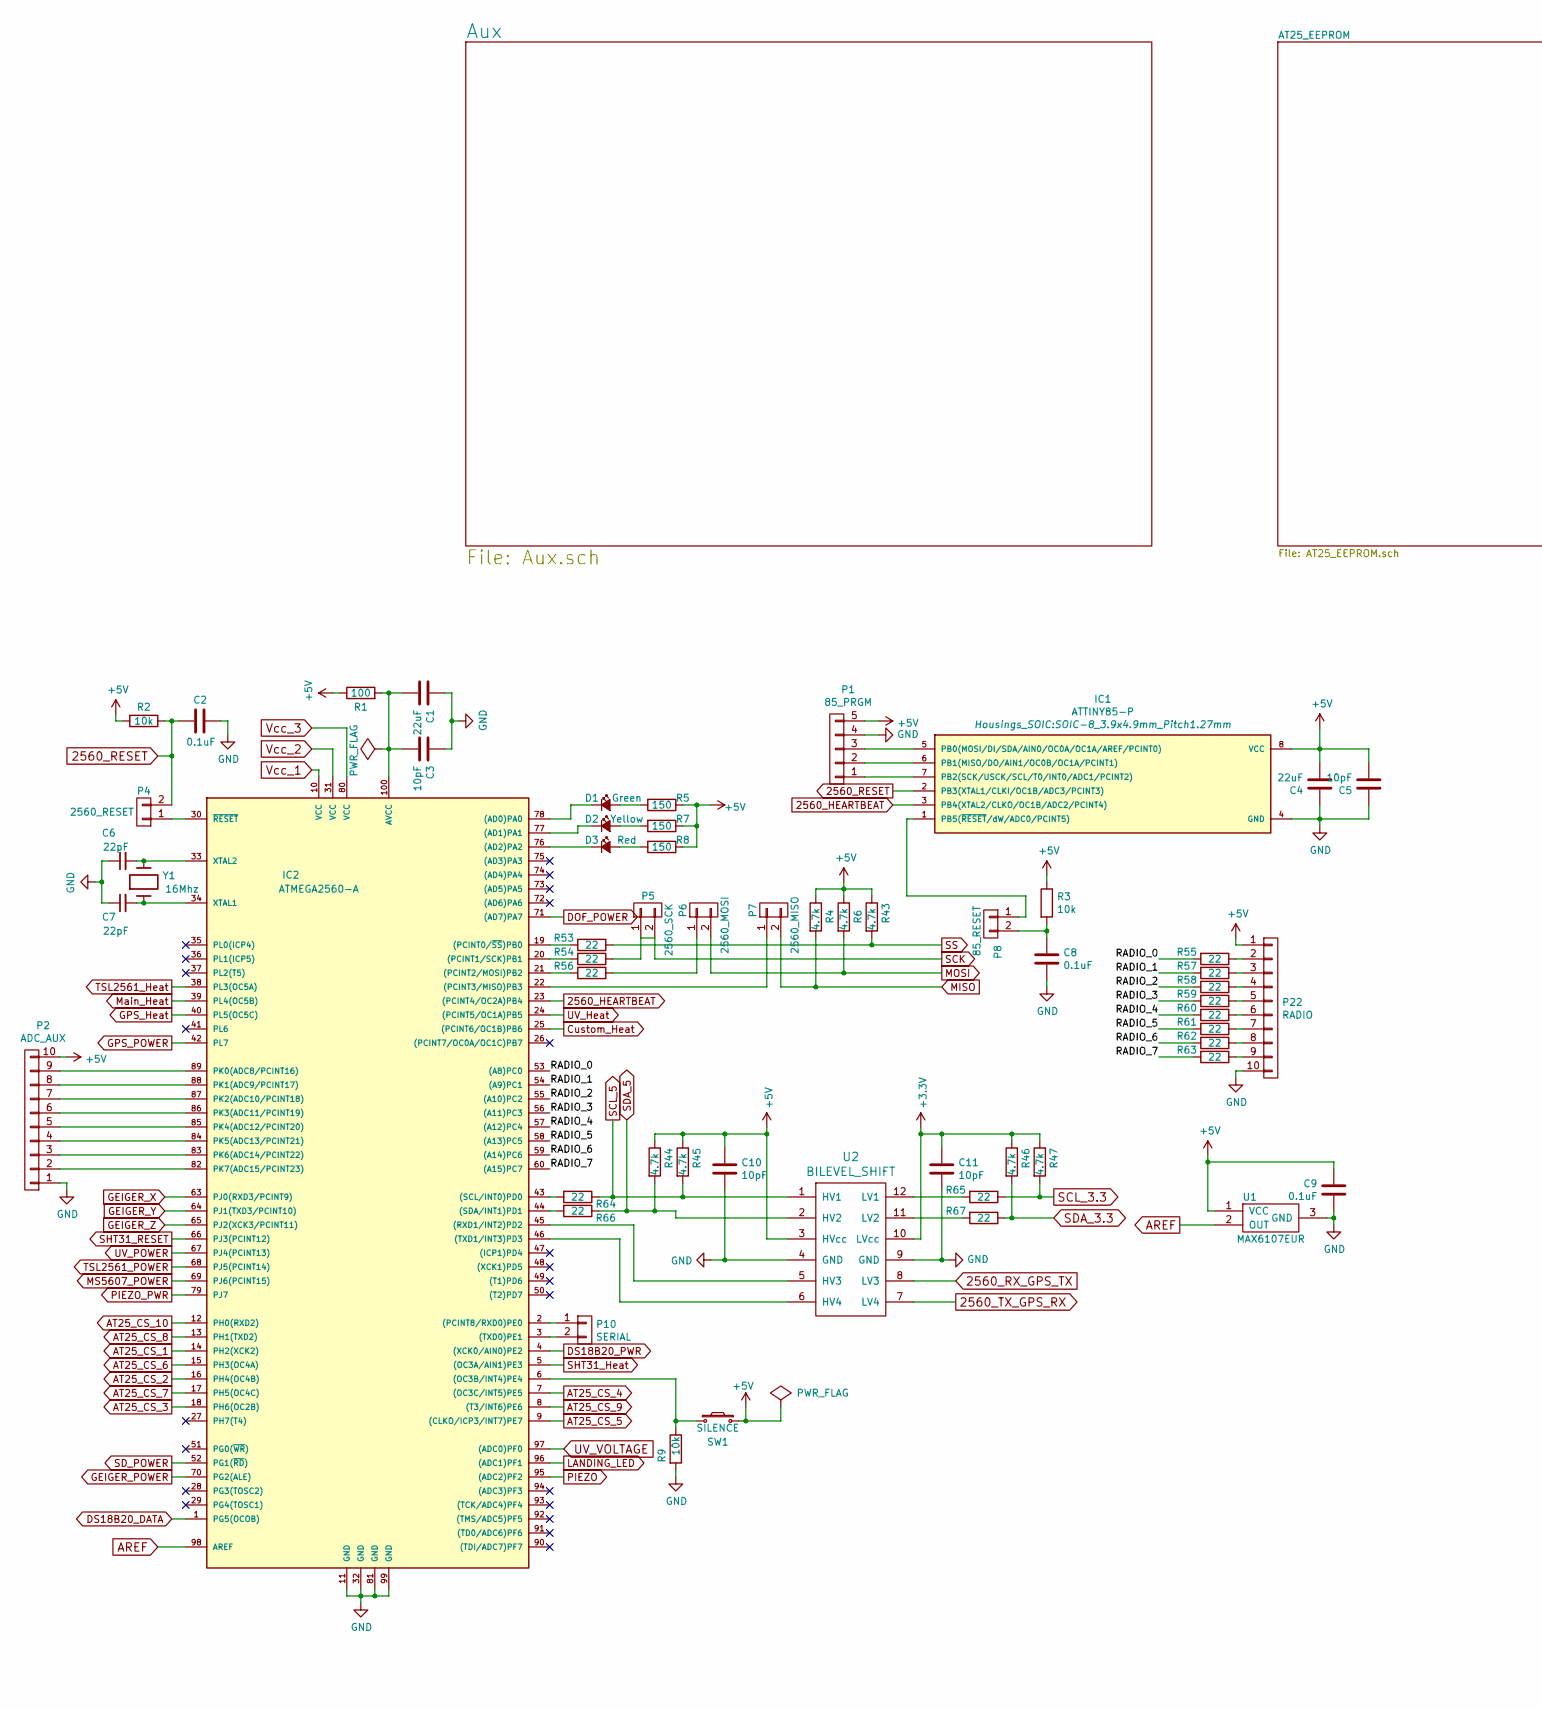
[picture p126: schematic Weather Balloon.sch, HAB Control Unit, part in row 1, column 1]

Parts:
C1, C4: 22uF; TantalC_SizeC_EIA-6032_HandSoldering
C2, C8, C9: 0.1uF; C_1206_HandSoldering
C3, C5, C10, C11: 10pF; C_1206_HandSoldering
C6, C7: 22pF; C_Disc_D3_P2.5
D1: Green; LED_1206
D2: Yellow; LED_1206
D3: Red; LED_1206
IC1: ATTINY85-P; SOIC-8_3.9x4.9mm_Pitch1.27mm
IC2: ATMEGA2560-A; TQFP-100_14x14mm_Pitch0.5mm
P1: 85_PRGM; Pin_Header_Straight_1x05
P2: ADC_AUX; Pin_Header_Straight_1x10
P4: 2560_RESET; Pin_Header_Straight_1x02
P5: 2560_SCK; Pin_Header_Straight_1x02
P6: 2560_MOSI; Pin_Header_Straight_1x02
P7: 2560_MISO; Pin_Header_Straight_1x02
P8: 85_RESET; Pin_Header_Straight_1x02
P10: SERIAL; Pin_Header_Straight_1x02
P22: RADIO; Pin_Header_Straight_1x10
R1: 100; R_1206_HandSoldering
R2, R3, R9: 10k; R_1206_HandSoldering
R4, R6, R43, R44, R45, R46, R47: 4.7k; R_1206_HandSoldering
R5, R7, R8: 150; R_1206_HandSoldering
R53, R54, R55, R56, R57, R58, R59, R60, R61, R62, R63, R64, R65, R66, R67: 22; R_1206_HandSoldering
SW1: SILENCE; SW_PUSH_6mm
U1: MAX6107EUR; SOT-23_Handsoldering
U2: BILEVEL_SHIFT; DIP-12_W7.62mm_LongPads_ALL
Y1: 16Mhz; HC-49V

Connections:
2560_HEARTBEAT: IC1.3 (PB4(XTAL2/CLKO/OC1B/ADC2/PCINT4)), IC2.23 ((PCINT4/OC2A)PB4)
2560_RESET: C2.2, IC1.2 (PB3(XTAL1/CLKI/OC1B/ADC3/PCINT3)), P4.2, R2.1
2560_RX_GPS_TX: U2.8 (LV3); also elsewhere on the board
2560_TX_GPS_RX: U2.7 (LV4); also elsewhere on the board
+3V3: C11.1, R46.1, R47.1, U2.10 (LVcc); also elsewhere on the board
/RADIO_0: IC2.53 ((A8)PC0), R55.2
/RADIO_1: IC2.54 ((A9)PC1), R57.2
/RADIO_2: IC2.55 ((A10)PC2), R58.2
/RADIO_3: IC2.56 ((A11)PC3), R59.2
/RADIO_4: IC2.57 ((A12)PC4), R60.2
/RADIO_5: IC2.58 ((A13)PC5), R61.2
/RADIO_6: IC2.59 ((A14)PC6), R62.2
/RADIO_7: IC2.60 ((A15)PC7), R63.2
AREF: IC2.98 (AREF), U1.2 (OUT)
AT25_CS_1: IC2.14 (PH2(XCK2)); also elsewhere on the board
AT25_CS_2: IC2.16 (PH4(OC4B)); also elsewhere on the board
AT25_CS_3: IC2.18 (PH6(OC2B)); also elsewhere on the board
AT25_CS_4: IC2.7 ((OC3C/INT5)PE5); also elsewhere on the board
AT25_CS_5: IC2.9 ((CLKO/ICP3/INT7)PE7); also elsewhere on the board
AT25_CS_6: IC2.15 (PH3(OC4A)); also elsewhere on the board
AT25_CS_7: IC2.17 (PH5(OC4C)); also elsewhere on the board
AT25_CS_8: IC2.13 (PH1(TXD2)); also elsewhere on the board
AT25_CS_9: IC2.8 ((T3/INT6)PE6); also elsewhere on the board
AT25_CS_10: IC2.12 (PH0(RXD2)); also elsewhere on the board
Custom_Heat: IC2.25 ((PCINT6/OC1B)PB6); also elsewhere on the board
DOF_POWER: IC2.71 ((AD7)PA7); also elsewhere on the board
DS18B20_DATA: IC2.1 (PG5(OCOB)); also elsewhere on the board
DS18B20_PWR: IC2.4 ((XCK0/AIN0)PE2); also elsewhere on the board
GEIGER_POWER: IC2.70 (PG2(ALE)); also elsewhere on the board
GEIGER_X: IC2.63 (PJ0(RXD3/PCINT9)); also elsewhere on the board
GEIGER_Y: IC2.64 (PJ1(TXD3/PCINT10)); also elsewhere on the board
GEIGER_Z: IC2.65 (PJ2(XCK3/PCINT11)); also elsewhere on the board
GND: C1.1, C2.1, C3.1, C4.1, C5.1, C6.1, C7.1, C8.2, C9.2, C10.2, C11.2, IC1.4 (GND), IC2.11 (GND), IC2.32 (GND), IC2.81 (GND), IC2.99 (GND), P1.4, P2.1, P22.10, R9.2, U1.3 (GND), U2.4 (GND), U2.9 (GND); also elsewhere on the board
GPS_Heat: IC2.40 (PL5(OC5C)); also elsewhere on the board
GPS_POWER: IC2.42 (PL7); also elsewhere on the board
LANDING_LED: IC2.96 ((ADC1)PF1); also elsewhere on the board
MISO: P7.2, R4.2; also elsewhere on the board
MOSI: P6.2, R6.2; also elsewhere on the board
MS5607_POWER: IC2.69 (PJ6(PCINT15)); also elsewhere on the board
Main_Heat: IC2.39 (PL4(OC5B)); also elsewhere on the board
unnamed: C1.2, C3.2, IC2.100 (AVCC), R1.2
unnamed: C6.2, IC2.33 (XTAL2), Y1.2
unnamed: C7.2, IC2.34 (XTAL1), Y1.1
unnamed: C8.1, P8.2, R3.2
unnamed: D1.1 (K), IC2.78 ((AD0)PA0)
unnamed: D1.2 (A), R5.2
unnamed: D2.1 (K), IC2.77 ((AD1)PA1)
unnamed: D2.2 (A), R7.2
unnamed: D3.1 (K), IC2.76 ((AD2)PA2)
unnamed: D3.2 (A), R8.2
unnamed: IC1.1 (PB5(~RESET~/dW/ADC0/PCINT5)), P8.1
unnamed: IC1.5 (PB0(MOSI/DI/SDA/AIN0/OC0A/OC1A/AREF/PCI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), P1.3
unnamed: IC1.6 (PB1(MISO/DO/AIN1/OC0B/OC1A/PCINT1)), P1.2
unnamed: IC1.7 (PB2(SCK/USCK/SCL/T0/INT0/ADC1/PCINT2)), P1.1
unnamed: IC2.2 ((PCINT8/RXD0)PE0), P10.1
unnamed: IC2.3 ((TXD0)PE1), P10.2
unnamed: IC2.6 ((OC3B/INT4)PE4), R9.1, SW1.1
unnamed: IC2.19 ((PCINT0/~SS~)PB0), R53.2
unnamed: IC2.20 ((PCINT1/SCK)PB1), R54.2
unnamed: IC2.21 ((PCINT2/MOSI)PB2), R56.2
unnamed: IC2.22 ((PCINT3/MISO)PB3), P7.1
unnamed: IC2.30 (~RESET), P4.1
unnamed: IC2.43 ((SCL/INT0)PD0), R64.2
unnamed: IC2.44 ((SDA/INT1)PD1), R66.2
unnamed: IC2.45 ((RXD1/INT2)PD2), U2.5 (HV3)
unnamed: IC2.46 ((TXD1/INT3)PD3), U2.6 (HV4)
unnamed: IC2.82 (PK7(ADC15/PCINT23)), P2.2
unnamed: IC2.83 (PK6(ADC14/PCINT22)), P2.3
unnamed: IC2.84 (PK5(ADC13/PCINT21)), P2.4
unnamed: IC2.85 (PK4(ADC12/PCINT20)), P2.5
unnamed: IC2.86 (PK3(ADC11/PCINT19)), P2.6
unnamed: IC2.87 (PK2(ADC10/PCINT18)), P2.7
unnamed: IC2.88 (PK1(ADC9/PCINT17)), P2.8
unnamed: IC2.89 (PK0(ADC8/PCINT16)), P2.9
unnamed: P6.1, R56.1
unnamed: P22.2, R55.1
unnamed: P22.3, R57.1
unnamed: P22.4, R58.1
unnamed: P22.5, R59.1
unnamed: P22.6, R60.1
unnamed: P22.7, R61.1
unnamed: P22.8, R62.1
unnamed: P22.9, R63.1
unnamed: R65.2, U2.12 (LV1)
unnamed: R67.2, U2.11 (LV2)
PIEZO: IC2.95 ((ADC2)PF2); also elsewhere on the board
PIEZO_PWR: IC2.79 (PJ7); also elsewhere on the board
SCK: P5.1, P5.2, R54.1; also elsewhere on the board
SCL_3.3: R47.2, R65.1; also elsewhere on the board
SCL_5: R45.2, R64.1, U2.1 (HV1); also elsewhere on the board
SDA_3.3: R46.2, R67.1; also elsewhere on the board
SDA_5: R44.2, R66.1, U2.2 (HV2); also elsewhere on the board
SD_POWER: IC2.52 (PG1(~RD~)); also elsewhere on the board
SHT31_Heat: IC2.5 ((OC3A/AIN1)PE3); also elsewhere on the board
SHT31_RESET: IC2.66 (PJ3(PCINT12)); also elsewhere on the board
SS: R43.2, R53.1; also elsewhere on the board
TSL2561_Heat: IC2.38 (PL3(OC5A)); also elsewhere on the board
TSL2561_POWER: IC2.68 (PJ5(PCINT14)); also elsewhere on the board
UV_Heat: IC2.24 ((PCINT5/OC1A)PB5); also elsewhere on the board
UV_POWER: IC2.67 (PJ4(PCINT13)); also elsewhere on the board
UV_VOLTAGE: IC2.97 ((ADC0)PF0); also elsewhere on the board
Vcc_1: C4.2, C5.2, C9.1, C10.1, IC1.8 (VCC), IC2.10 (VCC), IC2.31 (VCC), IC2.80 (VCC), P1.5, P2.10, P22.1, R1.1, R2.2, R3.1, R4.1, R5.1, R6.1, R7.1, R8.1, R43.1, R44.1, R45.1, SW1.2, U1.1 (VCC), U2.3 (HVcc); also elsewhere on the board

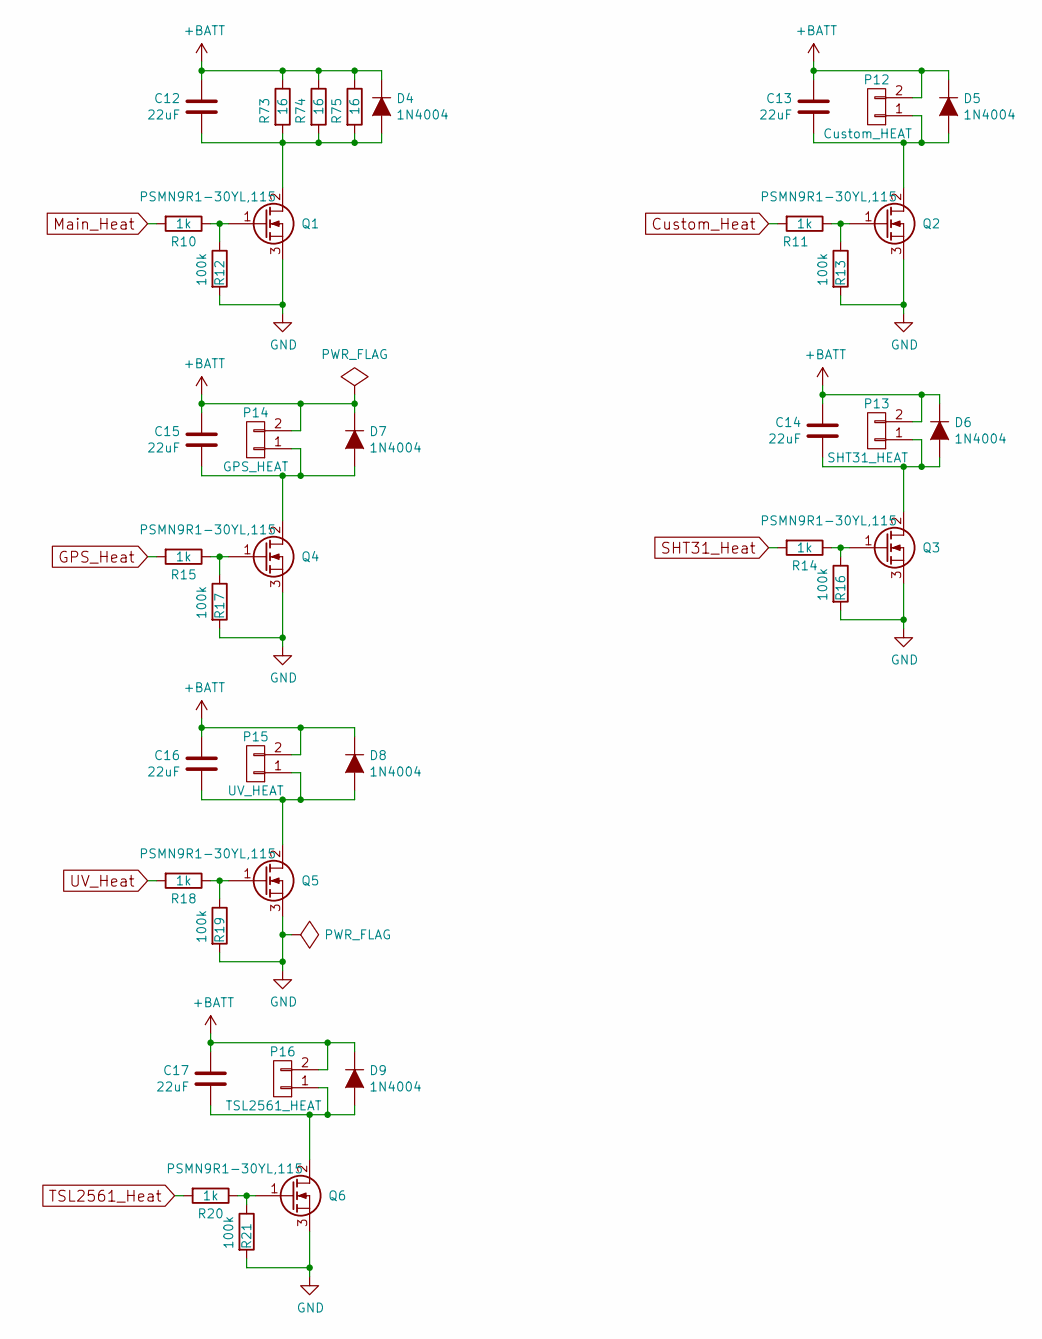
[picture p127: schematic Heater.sch, HAB Heater]

Parts:
C12, C13, C14, C15, C16, C17: 22uF; TantalC_SizeC_EIA-6032_HandSoldering
D4, D5, D6, D7, D8, D9: 1N4004; SMA_Handsoldering
P12: Custom_HEAT; Pin_Header_Straight_1x02
P13: SHT31_HEAT; Pin_Header_Straight_1x02
P14: GPS_HEAT; Pin_Header_Straight_1x02
P15: UV_HEAT; Pin_Header_Straight_1x02
P16: TSL2561_HEAT; Pin_Header_Straight_1x02
Q1, Q2, Q3, Q4, Q5, Q6: PSMN9R1-30YL,115; SOT-669_LFPAK
R10, R11, R14, R15, R18, R20: 1k; R_1206_HandSoldering
R12, R13, R16, R17, R19, R21: 100k; R_1206_HandSoldering
R73, R74, R75: 16; R_1206_WIDE

Connections:
+BATT: C12.1, C13.1, C14.1, C15.1, C16.1, C17.1, D4.1 (K), D5.1 (K), D6.1 (K), D7.1 (K), D8.1 (K), D9.1 (K), P12.2, P13.2, P14.2, P15.2, P16.2, R73.1, R74.1, R75.1; also elsewhere on the board
Custom_Heat: R11.2; also elsewhere on the board
GND: Q1.3 (S), Q2.3 (S), Q3.3 (S), Q4.3 (S), Q5.3 (S), Q6.3 (S), R12.2, R13.2, R16.2, R17.2, R19.2, R21.2; also elsewhere on the board
GPS_Heat: R15.2; also elsewhere on the board
Main_Heat: R10.2; also elsewhere on the board
unnamed: C12.2, D4.2 (A), Q1.2 (D), R73.2, R74.2, R75.2
unnamed: C13.2, D5.2 (A), P12.1, Q2.2 (D)
unnamed: C14.2, D6.2 (A), P13.1, Q3.2 (D)
unnamed: C15.2, D7.2 (A), P14.1, Q4.2 (D)
unnamed: C16.2, D8.2 (A), P15.1, Q5.2 (D)
unnamed: C17.2, D9.2 (A), P16.1, Q6.2 (D)
unnamed: Q1.1 (G), R10.1, R12.1
unnamed: Q2.1 (G), R11.1, R13.1
unnamed: Q3.1 (G), R14.1, R16.1
unnamed: Q4.1 (G), R15.1, R17.1
unnamed: Q5.1 (G), R18.1, R19.1
unnamed: Q6.1 (G), R20.1, R21.1
SHT31_Heat: R14.2; also elsewhere on the board
TSL2561_Heat: R20.2; also elsewhere on the board
UV_Heat: R18.2; also elsewhere on the board

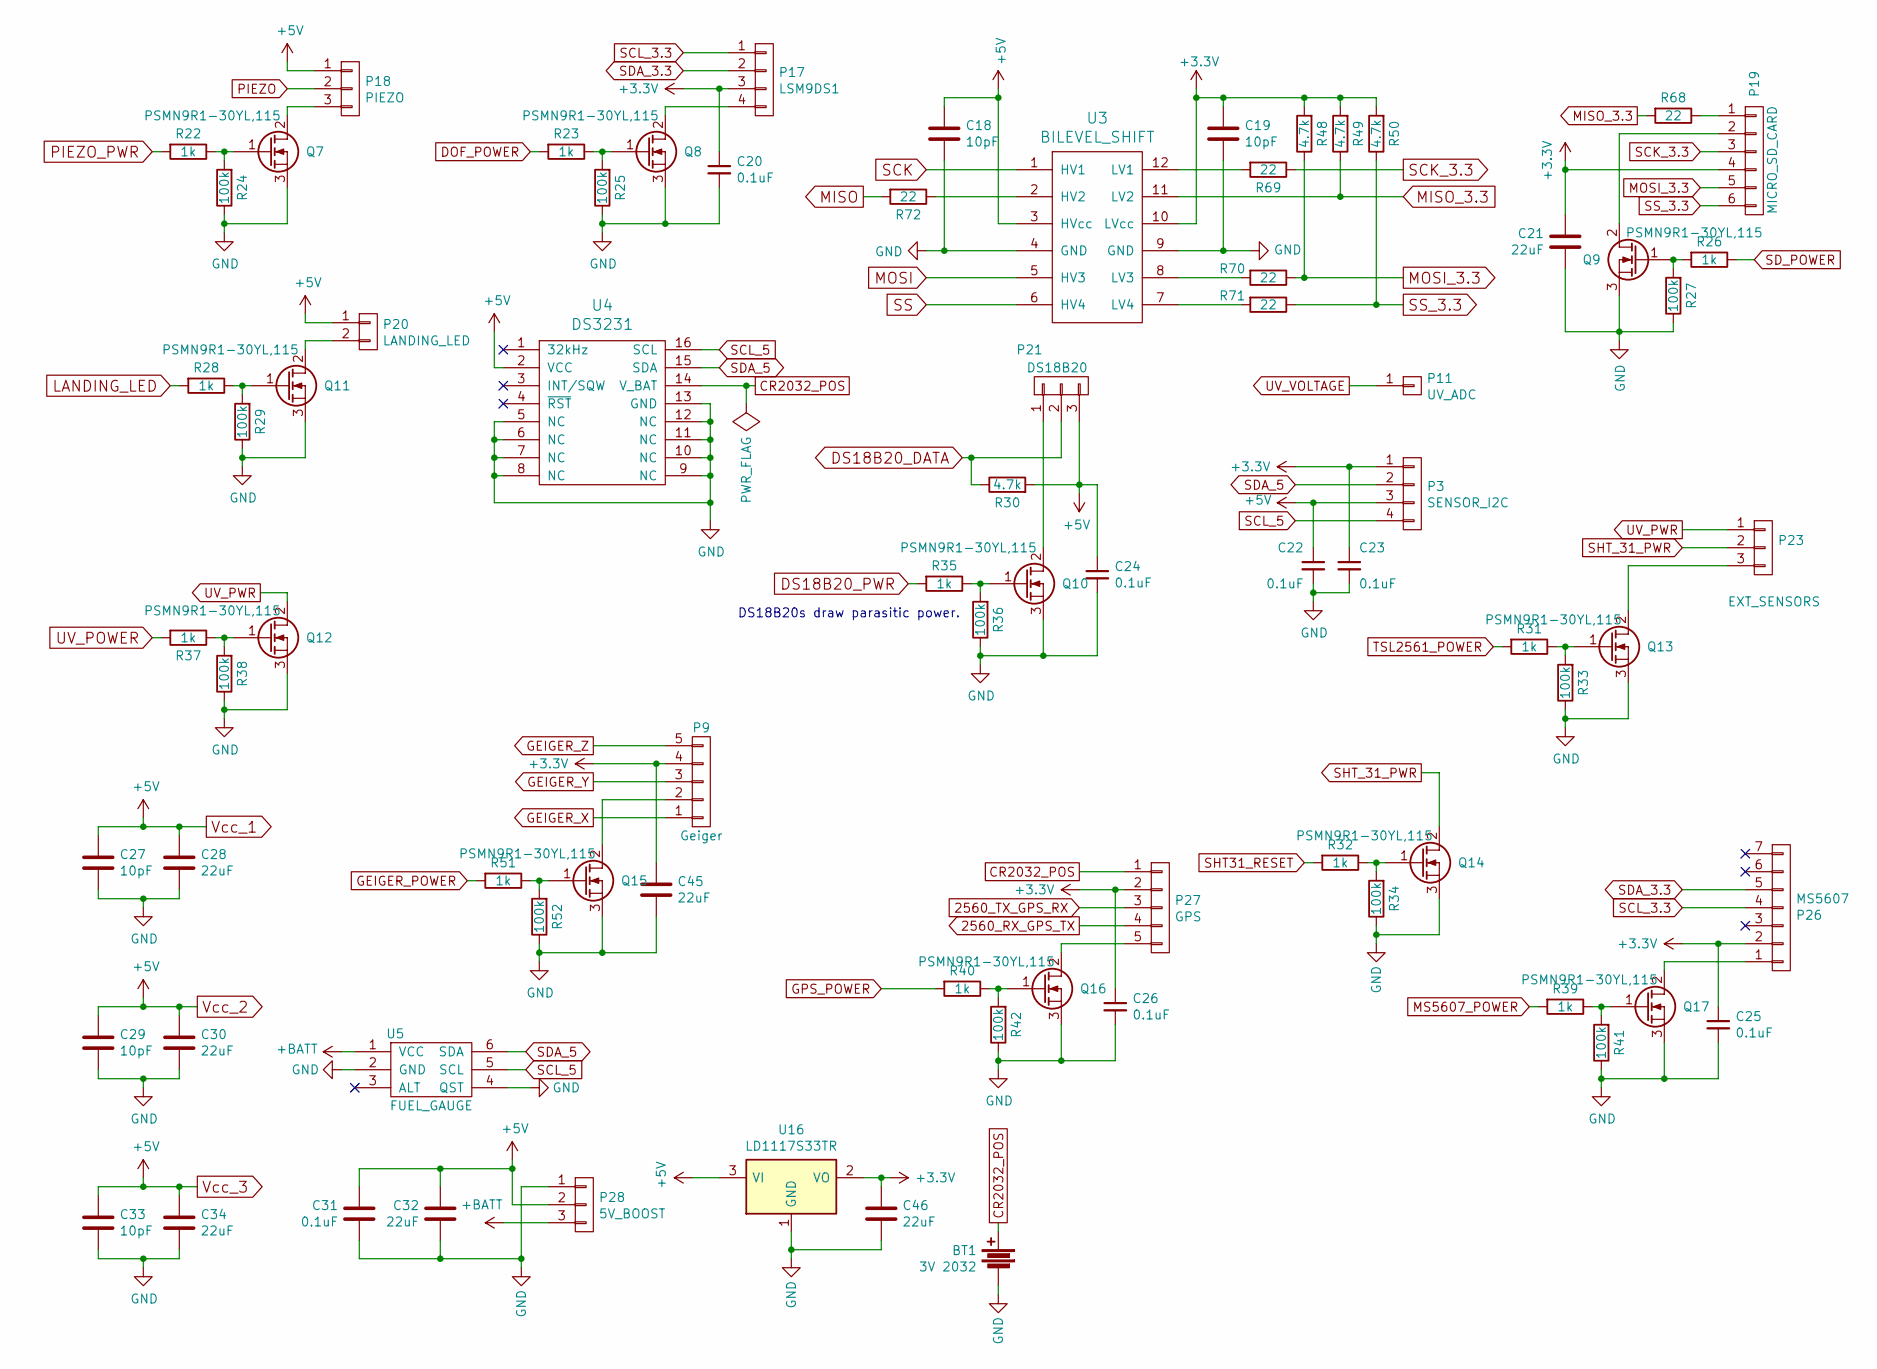
[picture p128: schematic Aux.sch, Aux Components]

Parts:
BT1: 3V 2032; CR2032
C18, C19, C27, C29, C33: 10pF; C_1206_HandSoldering
C20, C22, C23, C24, C25, C26, C31: 0.1uF; C_1206_HandSoldering
C21, C32, C34, C45, C46: 22uF; C_1206_HandSoldering
C28, C30: 22uF; TantalC_SizeC_EIA-6032_HandSoldering
P3: SENSOR_I2C; Pin_Header_Straight_1x04
P9: Geiger; Pin_Header_Straight_1x05
P11: UV_ADC; Pin_Header_Straight_1x01
P17: LSM9DS1; LSM9DS1_ALL
P18: PIEZO; Pin_Header_Straight_1x03
P19: MICRO_SD_CARD; MicroSD_ALL
P20: LANDING_LED; Pin_Header_Straight_1x02
P21: DS18B20; Pin_Header_Straight_1x03
P23: EXT_SENSORS; Pin_Header_Straight_1x03
P26: MS5607; MS5607_ALL
P27: GPS; Pin_Header_Straight_1x05
P28: 5V_BOOST; Voltage_Booster_ALL
Q7, Q8, Q9, Q10, Q11, Q12, Q13, Q14, Q15, Q16, Q17: PSMN9R1-30YL,115; SOT-669_LFPAK
R22, R23, R26, R28, R31, R32, R35, R37, R39, R40, R51: 1k; R_1206_HandSoldering
R24, R25, R27, R29, R33, R34, R36, R38, R41, R42, R52: 100k; R_1206_HandSoldering
R30, R48, R49, R50: 4.7k; R_1206_HandSoldering
R68, R69, R70, R71, R72: 22; R_1206_HandSoldering
U3: BILEVEL_SHIFT; DIP-12_W7.62mm_LongPads_ALL
U4: DS3231; SO-16-W
U5: FUEL_GAUGE; FUEL_GAUGE_ALL
U16: LD1117S33TR; TO-220

Connections:
2560_RX_GPS_TX: P27.4; also elsewhere on the board
2560_TX_GPS_RX: P27.3; also elsewhere on the board
+3V3: C19.1, C20.1, C21.1, C23.1, C25.1, C26.1, C45.2, C46.2, P3.1, P9.4, P17.3, P19.4, P26.2, P27.2, R48.2, R49.2, R50.2, U3.10 (LVcc), U16.2 (VO); also elsewhere on the board
+BATT: P28.3, U5.1 (VCC); also elsewhere on the board
CR2032_POS: BT1.1, P27.1, U4.14 (V_BAT)
DOF_POWER: R23.2; also elsewhere on the board
DS18B20_DATA: P21.2, R30.1; also elsewhere on the board
DS18B20_PWR: R35.2; also elsewhere on the board
GEIGER_POWER: R51.2; also elsewhere on the board
GEIGER_X: P9.1; also elsewhere on the board
GEIGER_Y: P9.3; also elsewhere on the board
GEIGER_Z: P9.5; also elsewhere on the board
GND: BT1.2, C18.2, C19.2, C20.2, C21.2, C22.2, C23.2, C24.2, C25.2, C26.2, C27.2, C28.2, C29.2, C30.2, C31.1, C32.1, C33.2, C34.2, C45.1, C46.1, P28.1, Q7.3 (S), Q8.3 (S), Q9.3 (S), Q10.3 (S), Q11.3 (S), Q12.3 (S), Q13.3 (S), Q14.3 (S), Q15.3 (S), Q16.3 (S), Q17.3 (S), R24.1, R25.1, R27.1, R29.1, R33.1, R34.1, R36.1, R38.1, R41.1, R42.1, R52.1, U3.4 (GND), U3.9 (GND), U4.5 (NC), U4.6 (NC), U4.7 (NC), U4.8 (NC), U4.9 (NC), U4.10 (NC), U4.11 (NC), U4.12 (NC), U4.13 (GND), U5.2 (GND), U5.4 (QST), U16.1 (GND); also elsewhere on the board
GPS_POWER: R40.2; also elsewhere on the board
LANDING_LED: R28.2; also elsewhere on the board
MISO: R72.2; also elsewhere on the board
MISO_3.3: R49.1, R68.2, U3.11 (LV2)
MOSI: U3.5 (HV3); also elsewhere on the board
MOSI_3.3: P19.5, R48.1, R70.1
MS5607_POWER: R39.2; also elsewhere on the board
unnamed: P9.2, Q15.2 (D)
unnamed: P17.4, Q8.2 (D)
unnamed: P18.3, Q7.2 (D)
unnamed: P19.1, R68.1
unnamed: P19.2, Q9.2 (D)
unnamed: P20.2, Q11.2 (D)
unnamed: P21.1, Q10.2 (D)
unnamed: P23.3, Q13.2 (D)
unnamed: P26.1, Q17.2 (D)
unnamed: P27.5, Q16.2 (D)
unnamed: Q7.1 (G), R22.1, R24.2
unnamed: Q8.1 (G), R23.1, R25.2
unnamed: Q9.1 (G), R26.2, R27.2
unnamed: Q10.1 (G), R35.1, R36.2
unnamed: Q11.1 (G), R28.1, R29.2
unnamed: Q12.1 (G), R37.1, R38.2
unnamed: Q13.1 (G), R31.1, R33.2
unnamed: Q14.1 (G), R32.1, R34.2
unnamed: Q15.1 (G), R51.1, R52.2
unnamed: Q16.1 (G), R40.1, R42.2
unnamed: Q17.1 (G), R39.1, R41.2
unnamed: R69.2, U3.12 (LV1)
unnamed: R70.2, U3.8 (LV3)
unnamed: R71.2, U3.7 (LV4)
unnamed: R72.1, U3.2 (HV2)
PIEZO: P18.2; also elsewhere on the board
PIEZO_PWR: R22.2; also elsewhere on the board
SCK: U3.1 (HV1); also elsewhere on the board
SCK_3.3: P19.3, R69.1
SCL_3.3: P17.1, P26.4; also elsewhere on the board
SCL_5: P3.4, U4.16 (SCL), U5.5 (SCL); also elsewhere on the board
SDA_3.3: P17.2, P26.5; also elsewhere on the board
SDA_5: P3.2, U4.15 (SDA), U5.6 (SDA); also elsewhere on the board
SD_POWER: R26.1; also elsewhere on the board
SHT31_RESET: R32.2; also elsewhere on the board
SHT_31_PWR: P23.2, Q14.2 (D)
SS: U3.6 (HV4); also elsewhere on the board
SS_3.3: P19.6, R50.1, R71.1
TSL2561_POWER: R31.2; also elsewhere on the board
UV_POWER: R37.2; also elsewhere on the board
UV_PWR: P23.1, Q12.2 (D)
UV_VOLTAGE: P11.1; also elsewhere on the board
Vcc_1: C18.1, C22.1, C24.1, C27.1, C28.1, C29.1, C30.1, C31.2, C32.2, C33.1, C34.1, P3.3, P18.1, P20.1, P21.3, P28.2, R30.2, U3.3 (HVcc), U4.2 (VCC), U16.3 (VI); also elsewhere on the board

Notes on the sheet:
DS18B20s draw parasitic power.

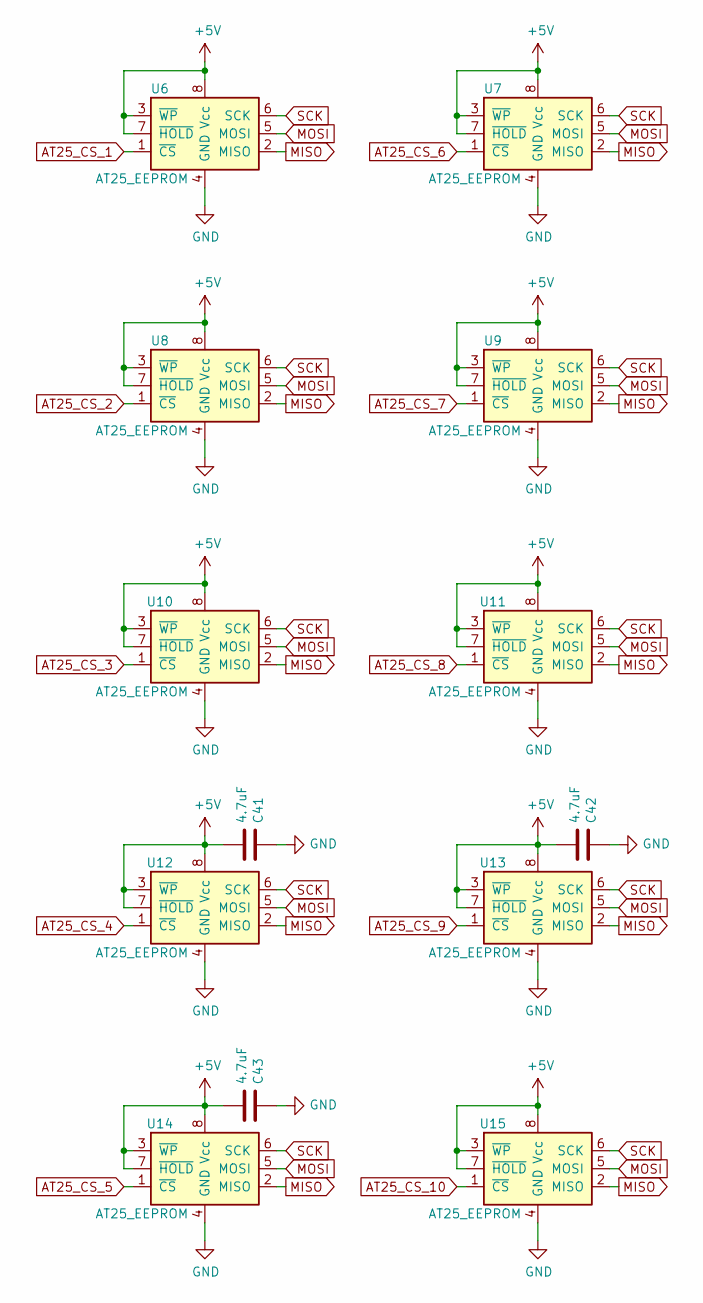
[picture p129: schematic AT25_EEPROM.sch, Serial EEPROM Backup]

Parts:
C41, C42, C43: 4.7uF; C_0603_HandSoldering
U6, U7, U8, U9, U10, U11, U12, U13, U14, U15: AT25_EEPROM; SOIC-8_3.9x4.9mm_Pitch1.27mm

Connections:
AT25_CS_1: U6.1 (~CS); also elsewhere on the board
AT25_CS_2: U8.1 (~CS); also elsewhere on the board
AT25_CS_3: U10.1 (~CS); also elsewhere on the board
AT25_CS_4: U12.1 (~CS); also elsewhere on the board
AT25_CS_5: U14.1 (~CS); also elsewhere on the board
AT25_CS_6: U7.1 (~CS); also elsewhere on the board
AT25_CS_7: U9.1 (~CS); also elsewhere on the board
AT25_CS_8: U11.1 (~CS); also elsewhere on the board
AT25_CS_9: U13.1 (~CS); also elsewhere on the board
AT25_CS_10: U15.1 (~CS); also elsewhere on the board
GND: C41.1, C42.1, C43.1, U6.4 (GND), U7.4 (GND), U8.4 (GND), U9.4 (GND), U10.4 (GND), U11.4 (GND), U12.4 (GND), U13.4 (GND), U14.4 (GND), U15.4 (GND); also elsewhere on the board
MISO: U6.2 (MISO), U7.2 (MISO), U8.2 (MISO), U9.2 (MISO), U10.2 (MISO), U11.2 (MISO), U12.2 (MISO), U13.2 (MISO), U14.2 (MISO), U15.2 (MISO); also elsewhere on the board
MOSI: U6.5 (MOSI), U7.5 (MOSI), U8.5 (MOSI), U9.5 (MOSI), U10.5 (MOSI), U11.5 (MOSI), U12.5 (MOSI), U13.5 (MOSI), U14.5 (MOSI), U15.5 (MOSI); also elsewhere on the board
SCK: U6.6 (SCK), U7.6 (SCK), U8.6 (SCK), U9.6 (SCK), U10.6 (SCK), U11.6 (SCK), U12.6 (SCK), U13.6 (SCK), U14.6 (SCK), U15.6 (SCK); also elsewhere on the board
Vcc_1: C41.2, C42.2, C43.2, U6.3 (~WP), U6.7 (~HOLD), U6.8 (Vcc), U7.3 (~WP), U7.7 (~HOLD), U7.8 (Vcc), U8.3 (~WP), U8.7 (~HOLD), U8.8 (Vcc), U9.3 (~WP), U9.7 (~HOLD), U9.8 (Vcc), U10.3 (~WP), U10.7 (~HOLD), U10.8 (Vcc), U11.3 (~WP), U11.7 (~HOLD), U11.8 (Vcc), U12.3 (~WP), U12.7 (~HOLD), U12.8 (Vcc), U13.3 (~WP), U13.7 (~HOLD), U13.8 (Vcc), U14.3 (~WP), U14.7 (~HOLD), U14.8 (Vcc), U15.3 (~WP), U15.7 (~HOLD), U15.8 (Vcc); also elsewhere on the board

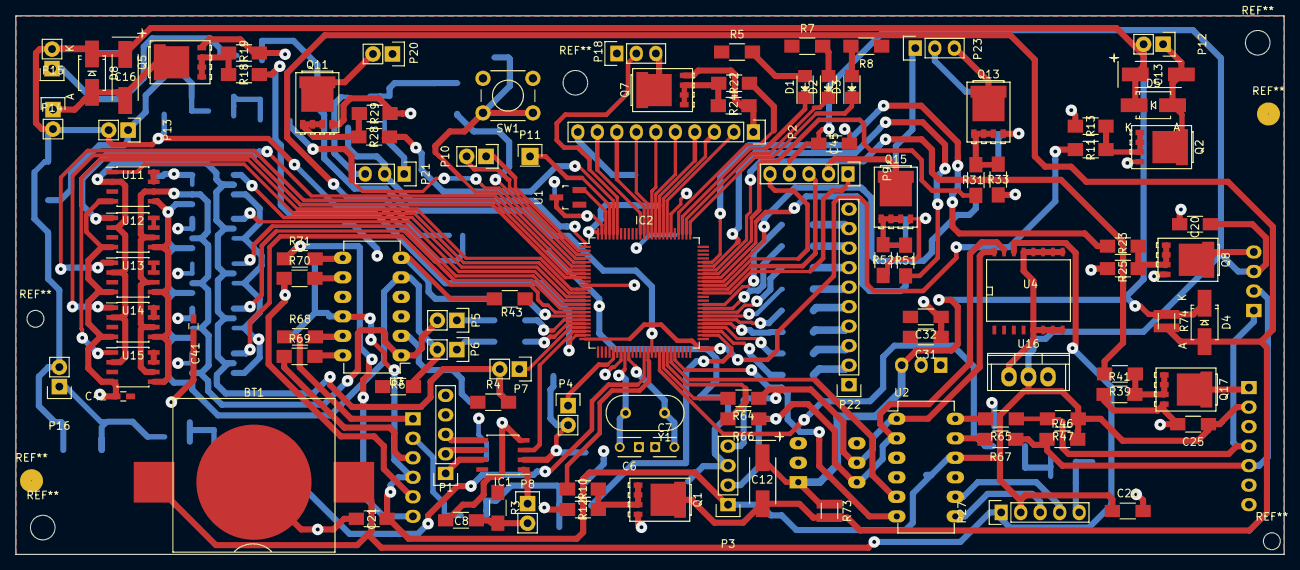
[picture p130: board Weather Balloon.kicad_pcb from above]

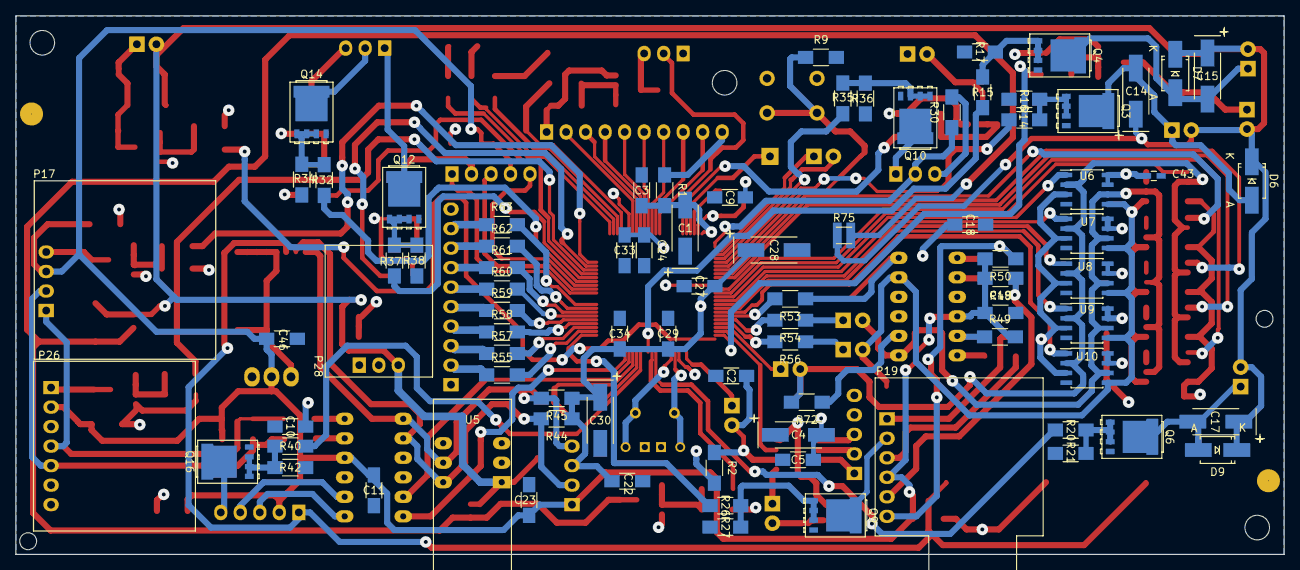
[picture p131: board Weather Balloon.kicad_pcb from below]

Board: 2 copper layers, 165.1 x 70.1 mm, 187 parts (83 on the bottom side), 147 nets.
