rasusmilch/HAB/Weather_Balloon_Info/Data Logging Shield Rev A/Data-Logger-shield-master/Adafruit SMT Datalogger Shield.brd

## EAGLE design Weather_Balloon_Info/Data Logging Shield Rev A/Data-Logger-shield-master/Adafruit SMT Datalogger Shield.brd (2016-09-16)

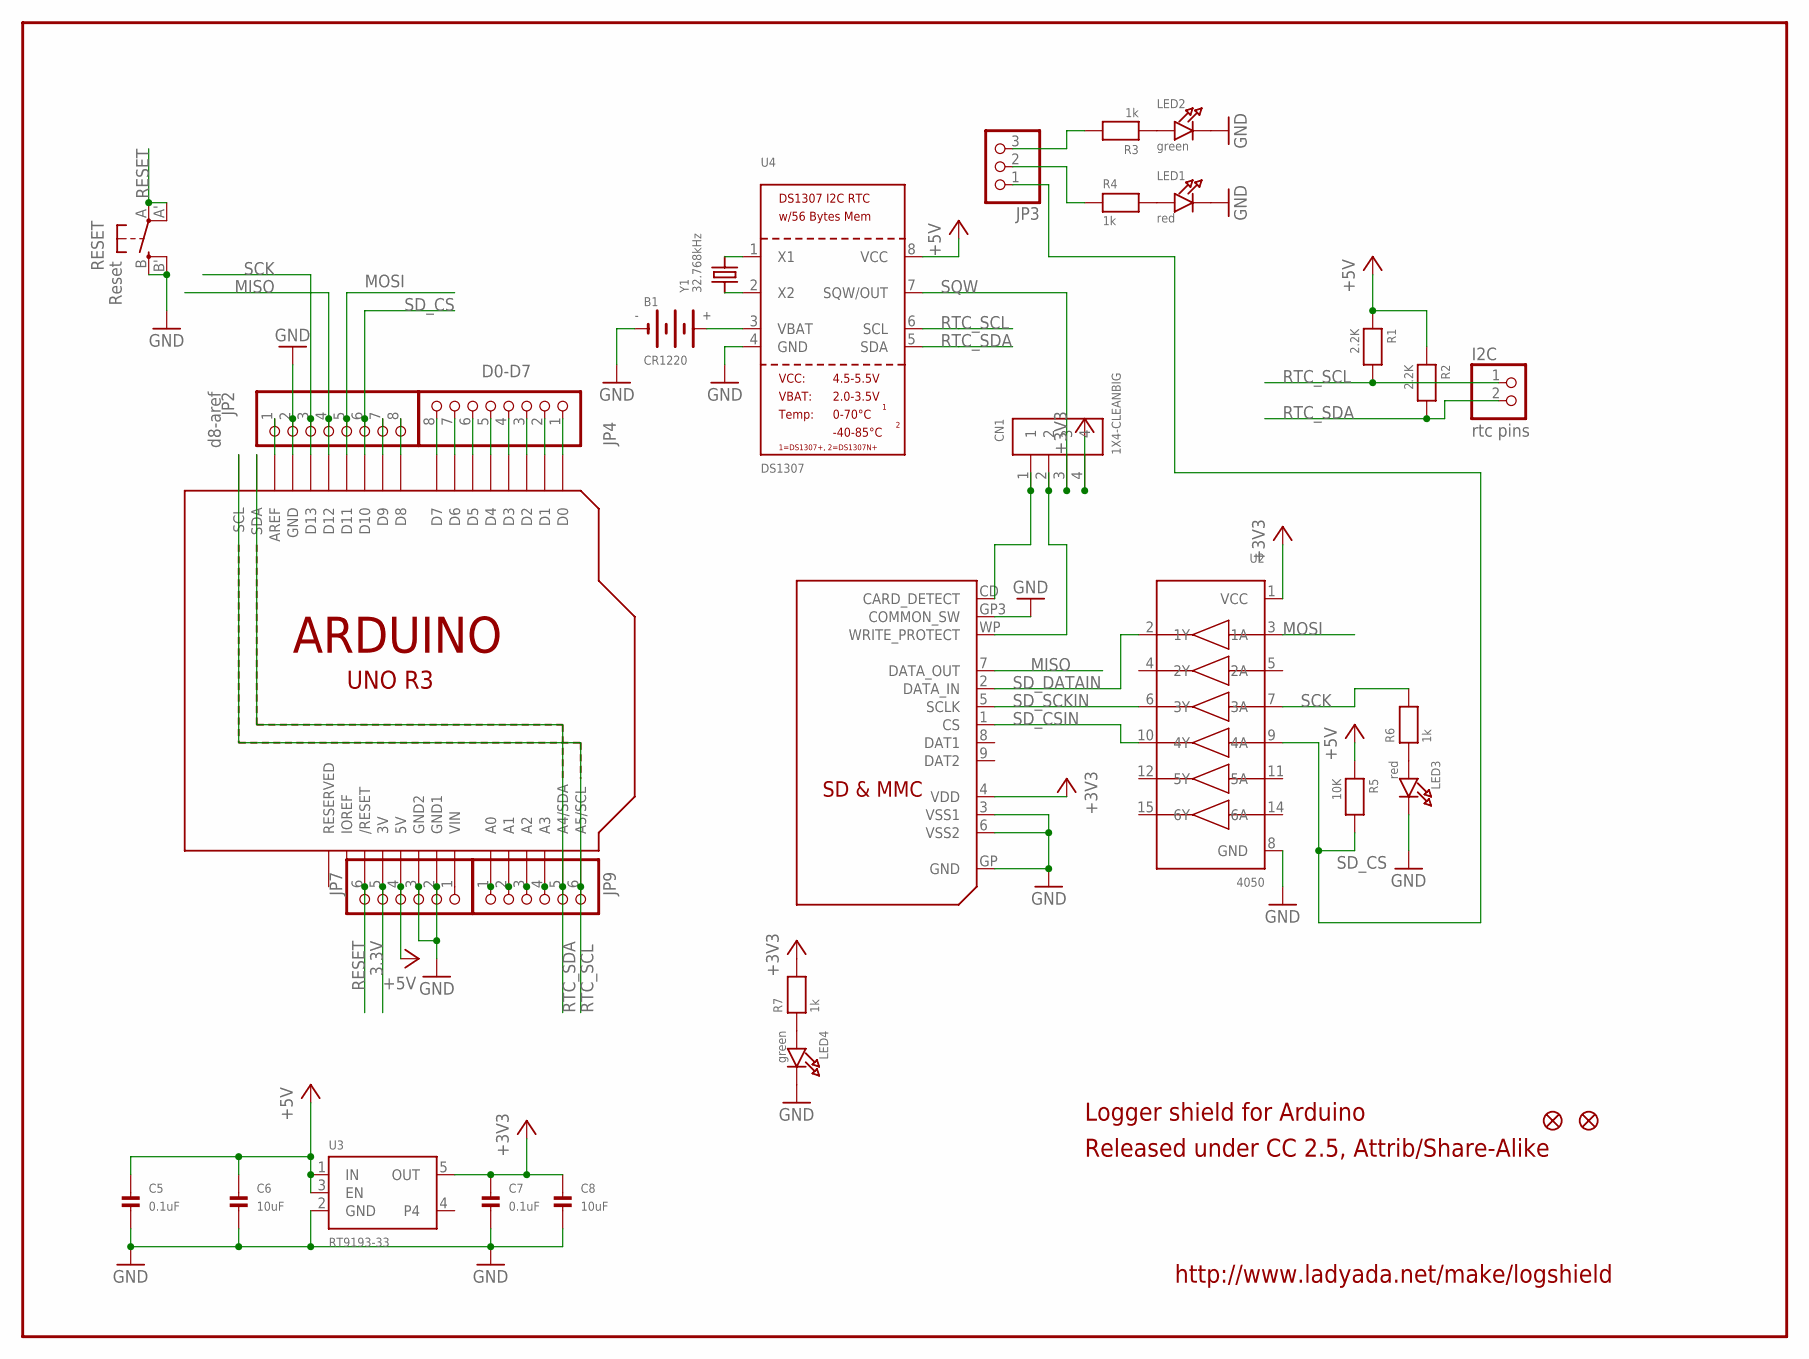
[picture p132: schematic Adafruit SMT Datalogger Shield.sch]

Parts:
B1: CR1220
C5, C7: 0.1uF; 0805
C6, C8: 10uF; 0805
CN1: 1X4-CLEANBIG; 1X04-CLEANBIG
FID1, FID3: FIDUCIAL1X2.5; FIDUCIAL-1X2.5
I2C: rtc pins; 1X02
JP2: d8-aref; 1X08-BIG
JP3: HEADER-1X3ROUND; 1X03_ROUND
JP4: D0-D7; 1X08-BIG
JP7, JP9: PINHD-1X6B; 1X06-BIG
LED1, LED3: red; CHIPLED_0805
LED2, LED4: green; CHIPLED_0805
R1, R2: 2.2K; 0805
R3, R4, R6, R7: 1k; 0805
R5: 10K; 0805
RESET: Reset; EVQ-Q2
U1: ARDUINOR3-DIMENSION; ARDUINOR3
U2: 4050; SOIC16
U3: RT9193-33; SOT23-5
U4: DS1307; SOIC8_150MIL
U$2: SDMMC06132; 06132
Y1: 32.768kHz; CRYSTAL_8X3.8

Connections:
3.3V: JP7.5, U1.3V
+3V3: C7.1, C8.1, CN1.4, R7.2, U2.1 (VCC), U3.5 (OUT), U$2.4 (VDD)
+5V: C5.1, C6.1, JP7.4, R1.1, R2.1, R5.1, U1.5V, U3.1 (IN), U3.3 (EN), U4.8 (VCC)
GND: B1.-, C5.2, C6.2, C7.2, C8.2, JP2.2, JP7.2, JP7.3, LED1.C, LED2.C, LED3.C, LED4.C, RESET.B (S), RESET.B' (S1), U1.GND, U1.GND1, U1.GND2, U2.8 (GND), U3.2 (GND), U4.4 (GND), U$2.3 (VSS1), U$2.6 (VSS2), U$2.GP (GND), U$2.GP3 (COMMON_SW)
MISO: JP2.4, U1.D12, U$2.7 (DATA_OUT)
MOSI: JP2.5, U1.D11, U2.3 (1A)
unnamed: LED1.A, R4.2
unnamed: U4.2 (X2), Y1.P$1 (1)
unnamed: U4.1 (X1), Y1.P$4 (2)
unnamed: LED2.A, R3.1
unnamed: LED3.A, R6.1
unnamed: B1.+$1 (+), U4.3 (VBAT)
unnamed: JP7.1, U1.VIN
unnamed: JP3.3, R3.2
unnamed: JP3.2, R4.1
unnamed: JP4.1, U1.D0
unnamed: JP4.2, U1.D1
unnamed: JP4.3, U1.D2
unnamed: JP4.4, U1.D3
unnamed: JP4.5, U1.D4
unnamed: JP4.6, U1.D5
unnamed: JP4.7, U1.D6
unnamed: JP4.8, U1.D7
unnamed: JP2.1, U1.AREF
unnamed: JP2.7, U1.D9
unnamed: JP2.8, U1.D8
unnamed: LED4.A, R7.1
unnamed: JP9.1, U1.A0
unnamed: JP9.2, U1.A1
unnamed: JP9.3, U1.A2
unnamed: JP9.4, U1.A3
RESET: JP7.6, RESET.A, RESET.A' (P1), U1.RESET (/RESET)
RTC_SCL: I2C.1, JP9.6, R1.2, U1.A5 (A5/SCL), U1.SCL, U4.6 (SCL)
RTC_SDA: I2C.2, JP9.5, R2.2, U1.A4 (A4/SDA), U1.SDA, U4.5 (SDA)
SCK: JP2.3, R6.2, U1.D13, U2.7 (3A)
SD_CD: CN1.1, U$2.CD (CARD_DETECT)
SD_CS: JP2.6, JP3.1, R5.2, U1.D10, U2.9 (4A)
SD_CSIN: U2.10 (4Y), U$2.1 (CS)
SD_DATAIN: U2.2 (1Y), U$2.2 (DATA_IN)
SD_SCKIN: U2.6 (3Y), U$2.5 (SCLK)
SD_WP: CN1.2, U$2.WP (WRITE_PROTECT)
SQW: CN1.3, U4.7 (SQW/OUT)

Notes on the sheet:
http://www.ladyada.net/make/logshield
Released under CC 2.5, Attrib/Share-Alike
Logger shield for Arduino

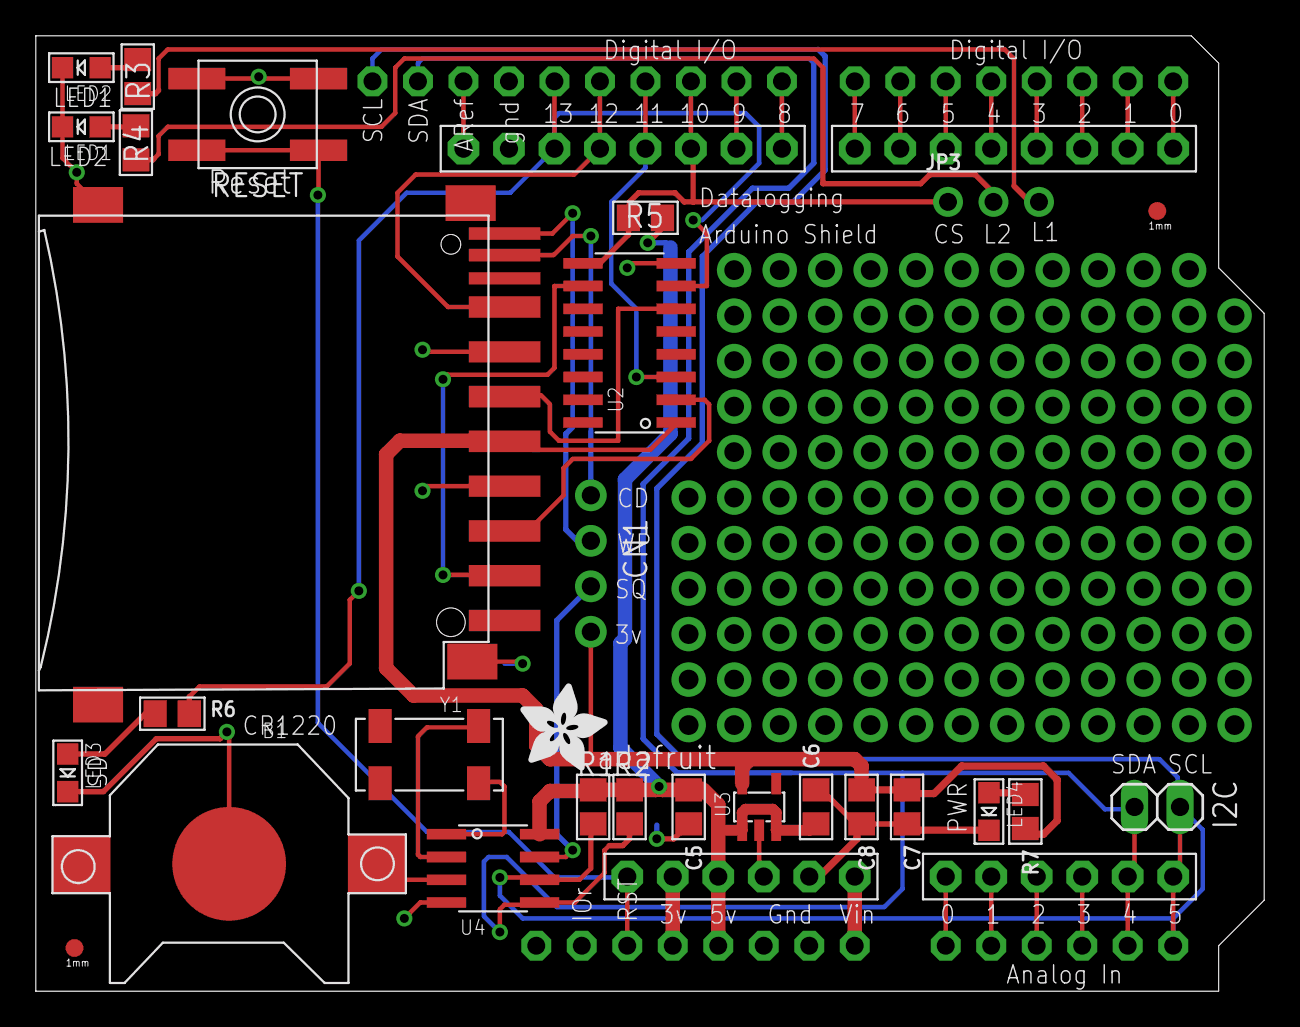
[picture p133: board Adafruit SMT Datalogger Shield.brd from above]

Board: 2 copper layers, 68.6 x 53.3 mm, 34 parts (1 on the bottom side), 42 nets.

Other parts of the board:
U$1: ADAFRUIT_TEXT_30MM
U$5: ADAFRUIT_5MM
