rasusmilch/HAB/Weather_Balloon_Info/Sparkfun Geiger/Geiger_Counter-V_HW4.0_FW1.2/Hardware/Geiger_Counter.brd

## EAGLE design Weather_Balloon_Info/Sparkfun Geiger/Geiger_Counter-V_HW4.0_FW1.2/Hardware/Geiger_Counter.brd (2016-09-16)

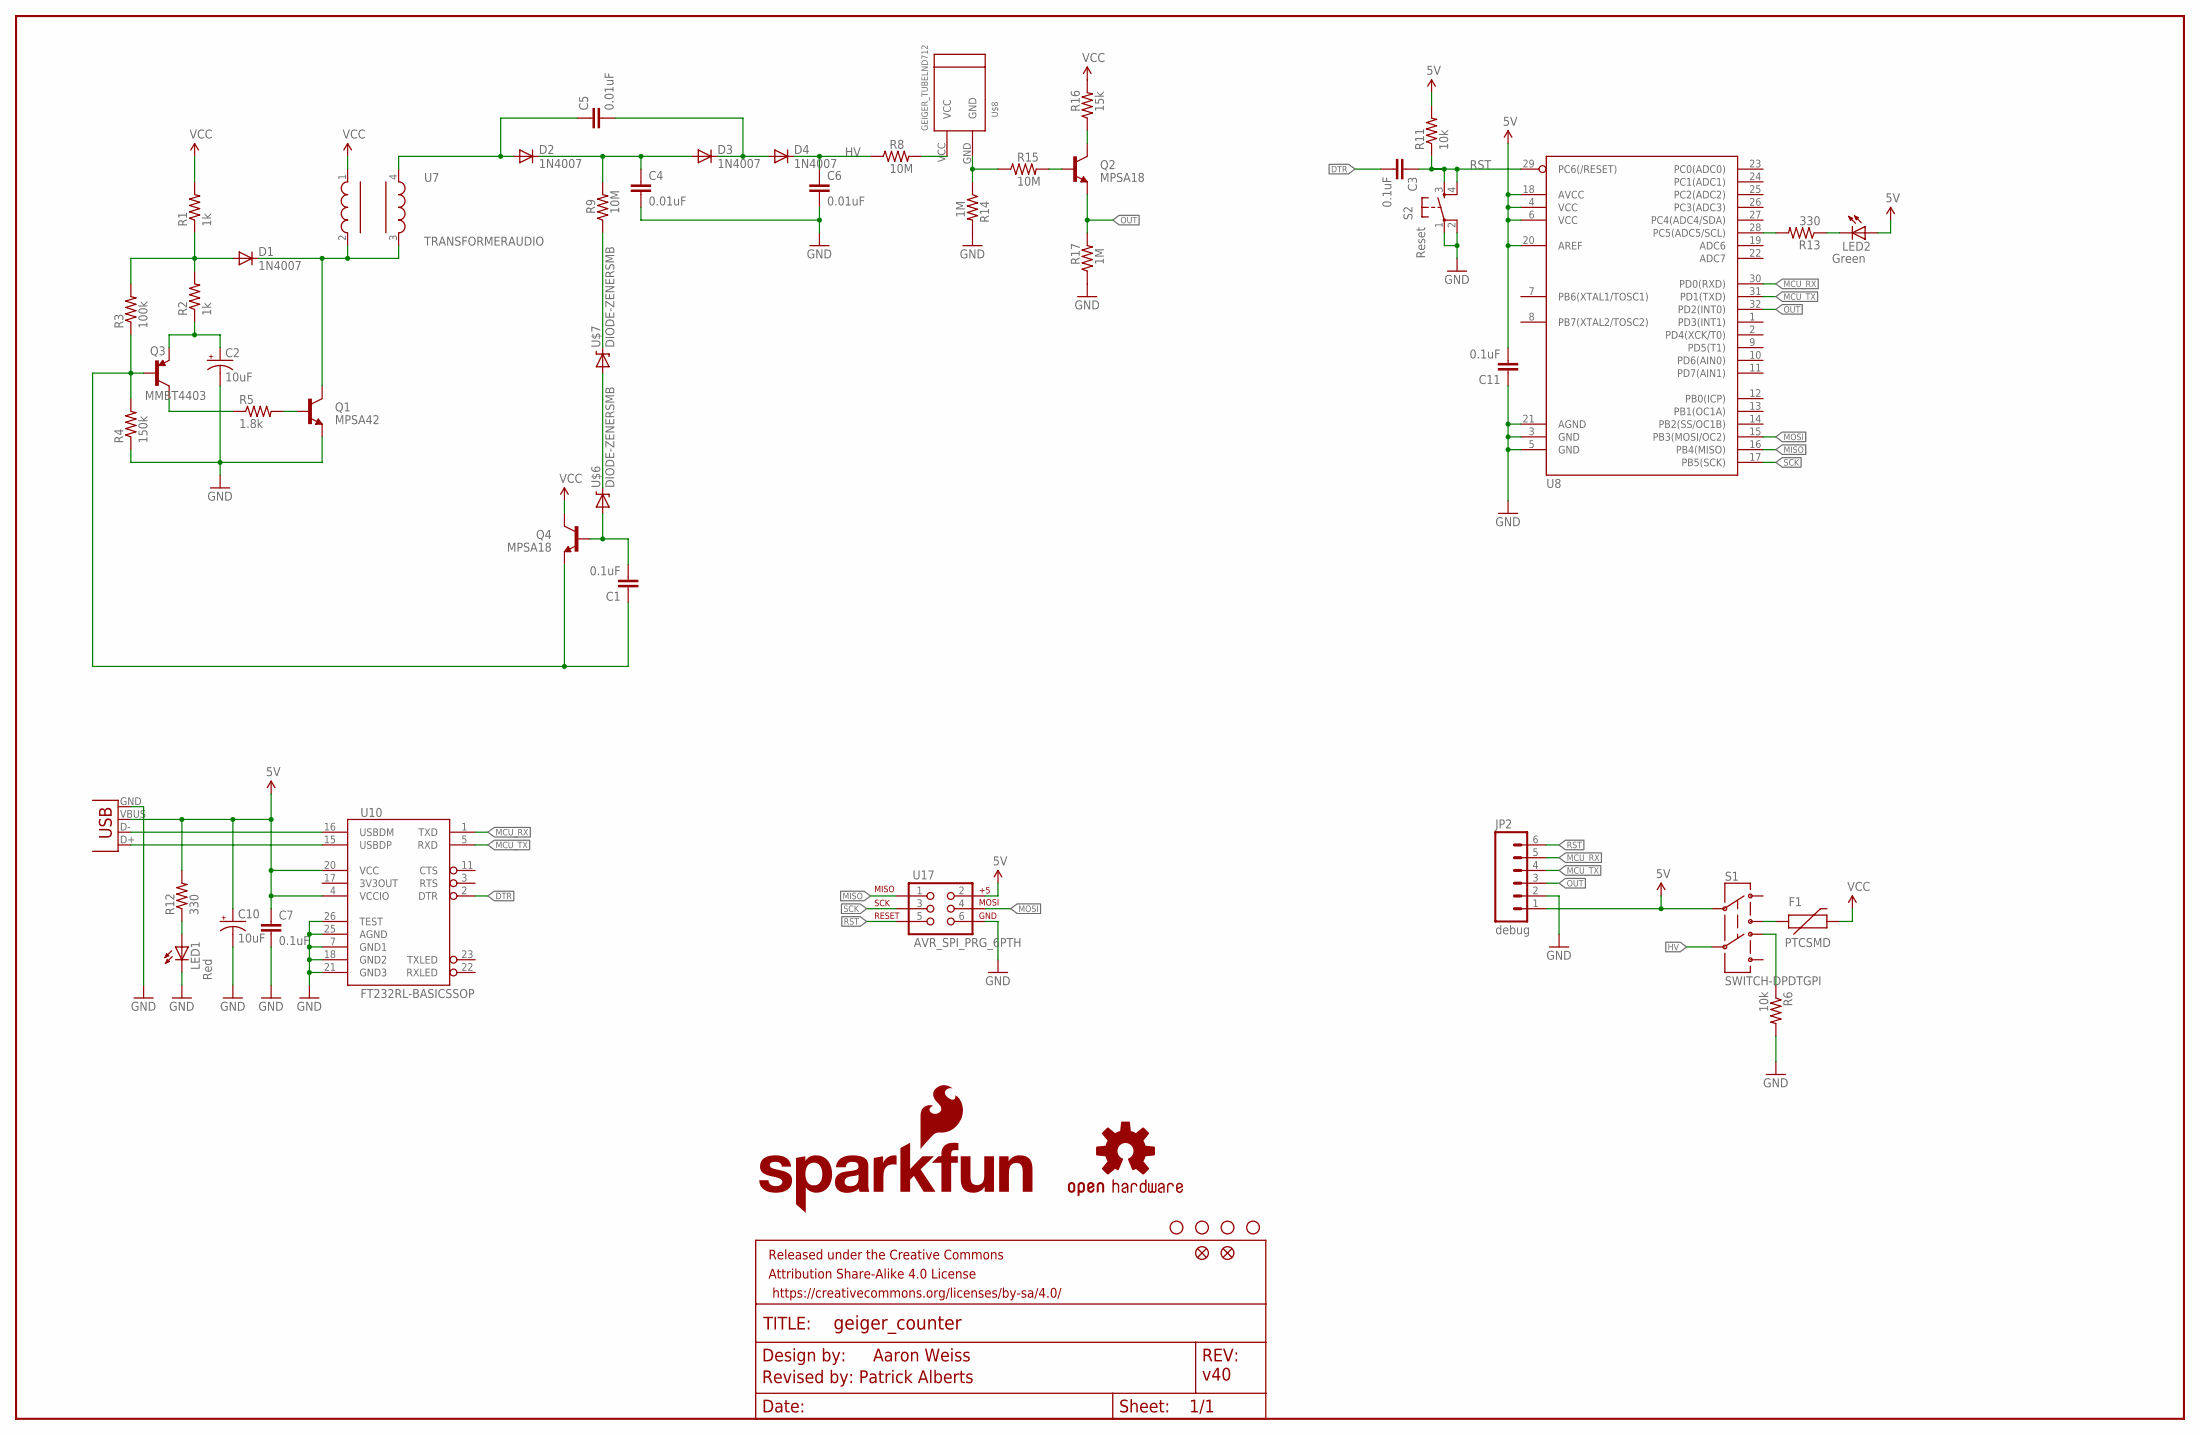
[picture p134: schematic Geiger_Counter.sch]

Parts:
C1, C3, C7, C11: 0.1uF; 0603-CAP
C2, C10: 10uF; EIA3216
C4, C5, C6: 0.01uF; CAP-PTH-LARGE
D1: 1N4007; DIODE-HV
D2, D3, D4: 1N4007; DIODE-1N4001
F1: PTCSMD; PTC-1206
FID1, FID2: FIDUCIAL1X2; FIDUCIAL-1X2
FRAME2: FRAME-LEDGER; CREATIVE_COMMONS
JP2: debug; 1X06
LED1: Red; LED-1206
LED2: Green; LED-1206
LOGO1: OSHW-LOGOM; OSHW-LOGO-M
LOGO2: SFE_LOGO_NAME_FLAME.1_INCH; SFE_LOGO_NAME_FLAME_.1
Q1: MPSA42; SOT23-3
Q2, Q4: MPSA18; TO-92
Q3: MMBT4403; SOT23-3
R1, R2: 1k; 0603-RES
R3: 100k; 0603-RES
R4: 150k; 0603-RES
R5: 1.8k; 0603-RES
R6: 10k; AXIAL-0.3
R8, R9, R15: 10M; AXIAL-0.3
R11: 10k; 0603-RES
R12: 330; 0603
R13: 330; 0603-RES
R14, R17: 1M; AXIAL-0.3
R16: 15k; AXIAL-0.3
S1: SWITCH-DPDTGPI; GPI-152-3013
S2: Reset; TACTILE_SWITCH_SMD
U7: TRANSFORMERAUDIO; TRANSFORMER
U8: ATMEGA328_SMT; TQFP32-08
U10: FT232RL-BASICSSOP; SSOP28DB
U17: AVR_SPI_PRG_6PTH; 2X3
U$1, U$2, U$3, U$4: STAND-OFF
U$6, U$7: DIODE-ZENERSMB; SMB-DIODE
U$8: GEIGER_TUBELND712; GEIGER_TUBE
X1: USBSMD; USB-MINIB

Connections:
5V: C7.1, C10.A (+), C11.2, JP2.1, LED2.A, R11.2, R12.2, S1.C@1 (2), U8.4 (VCC), U8.6 (VCC), U8.18 (AVCC), U8.20 (AREF), U10.4 (VCCIO), U10.20 (VCC), U17.2, X1.VBUS
DTR: C3.2, U10.2 (DTR)
GND: C2.C (-), C4.2, C6.2, C10.C (-), C11.1, JP2.2, LED1.C, Q1.2 (E), R4.1, R6.P$2 (2), R14.P$2 (2), R17.P$1 (1), S2.1, S2.2, U8.3 (GND), U8.5 (GND), U8.21 (AGND), U10.7 (GND1), U10.18 (GND2), U10.21 (GND3), U10.25 (AGND), U10.26 (TEST), U17.6, X1.GND
HV: C6.1, D4.C, R8.P$1 (1), S1.C@2 (5)
MCU_RX: JP2.5, U8.30 (PD0(RXD)), U10.1 (TXD)
MCU_TX: JP2.4, U8.31 (PD1(TXD)), U10.5 (RXD)
MISO: U8.16 (PB4(MISO)), U17.1
MOSI: U8.15 (PB3(MOSI/OC2)), U17.4
unnamed: F1.1, S1.20 (3)
unnamed: D1.A, R1.1, R2.2, R3.2
unnamed: R14.P$1 (1), R15.P$1 (1), U$8.GND
unnamed: C2.A (+), Q3.2 (E), R2.1
unnamed: Q2.2 (B), R15.P$2 (2)
unnamed: Q3.3 (C), R5.1
unnamed: R6.P$1 (1), S1.11 (4)
unnamed: Q2.3 (C), R16.P$1 (1)
unnamed: Q1.1 (B), R5.2
unnamed: D1.C, Q1.3 (C), U7.2, U7.3
unnamed: C4.1, D2.C, D3.A, R9.P$2 (2)
unnamed: C5.2, D3.C, D4.A
unnamed: R8.P$2 (2), U$8.VCC
unnamed: U10.16 (USBDM), X1.D-
unnamed: U10.15 (USBDP), X1.D+
unnamed: R9.P$1 (1), U$7.C
unnamed: LED1.A, R12.1
unnamed: LED2.C, R13.1
unnamed: R13.2, U8.28 (PC5(ADC5/SCL))
unnamed: U$6.C, U$7.A
unnamed: C1.2, Q4.2 (B), U$6.A
OSC1: C5.1, D2.A, U7.4
OSC2: C1.1, Q3.1 (B), Q4.1 (E), R3.1, R4.2
OUT: JP2.3, Q2.1 (E), R17.P$2 (2), U8.32 (PD2(INT0))
RST: C3.1, JP2.6, R11.1, S2.3, S2.4, U8.29 (PC6(/RESET)), U17.5
SCK: U8.17 (PB5(SCK)), U17.3
VCC: F1.2, Q4.3 (C), R1.2, R16.P$2 (2), U7.1

Notes on the sheet:
Aaron Weiss
Revised by: Patrick Alberts
v40

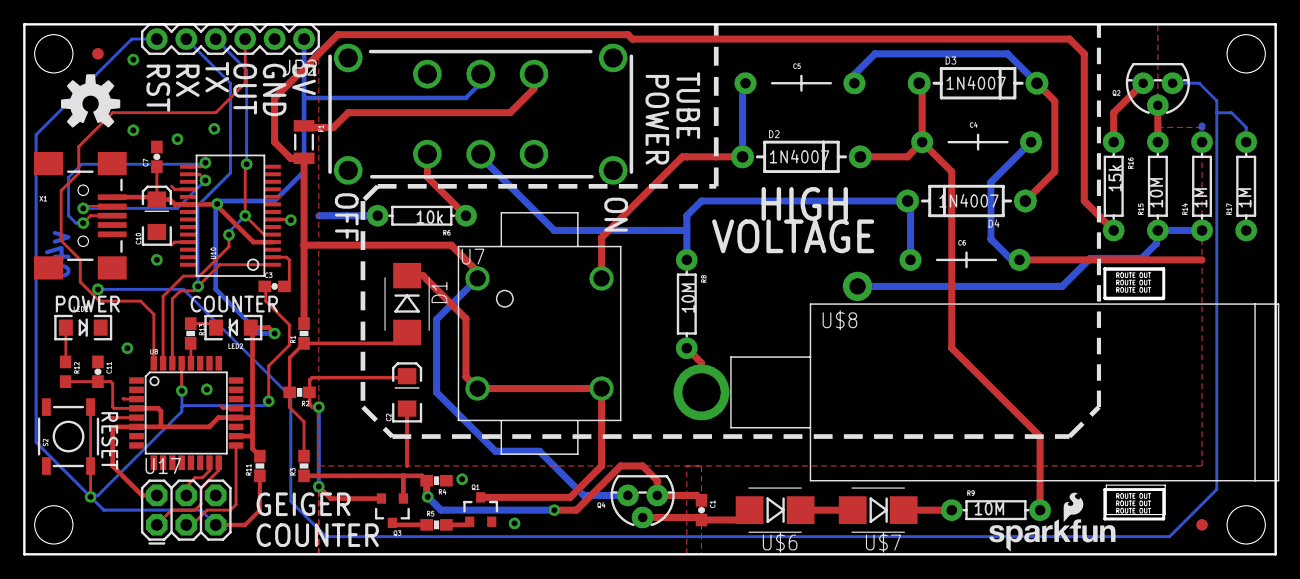
[picture p135: board Geiger_Counter.brd from above]

Board: 2 copper layers, 108.0 x 45.7 mm, 55 parts (0 on the bottom side), 35 nets.
