rasusmilch/HAB/(commit log)

2016-09-10 Beeper working. Magnetometer and 18B20.
2016-09-11 Added accelerometer and non-blocking DS18B20 temperature conversion
2016-09-16 Refactored to use generic Makefile instead of Arduino IDE. Allowing external IDE and more traditional Cpp
    [Adafruit Datalogger Shield.brd, Adafruit Datalogger Shield.sch, Adafruit SMT Datalogger Shield.brd, Adafruit SMT Datalogger Shield.sch, Geiger_Counter-Panel-v40.brd, Geiger_Counter.brd, Geiger_Counter.sch]
2016-09-18 Progress on new sensors, fuel gauge.
    [Gas sensor.sch, Heater.sch, Weather Balloon.kicad_pcb, Weather Balloon.sch]
2016-09-20 Restructured sensor data. GPS works.
2016-09-20 Calibration of accel, mag and gyro.
2016-09-21 Geiger count ISR and reorganize sensor configs. New sensor found struct.
    [geiger_fixedR5R6.brd, geiger_fixedR5R6.sch]
2016-09-25 Logging packed
    [Aux.sch, Gas sensor.sch, Heater.sch, Weather Balloon.sch]
2016-09-27 Initial PCB design with throughhole components. Layout not finilized.
    [AT25_EEPROM.sch, Aux.sch, Gas sensor.sch, Heater.sch, Oven Controller.sch, Weather Balloon.csv, Weather Balloon.dsn, Weather Balloon.sch]
2016-09-29 Before manual trace width adjust
    [AT25_EEPROM.sch, Aux.sch, Heater.sch, Weather Balloon.csv, Weather Balloon.dsn, Weather Balloon.kicad_pcb, Weather Balloon.sch]
2016-10-01 Reorganized folder structure
    [AT25_EEPROM.sch, Aux.sch, Gas sensor.sch, Heater.sch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]
2016-10-01 Restructured folders to move board level files to board directory.
    [AT25_EEPROM.sch, Aux.sch, Gas sensor.sch, Heater.sch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]
2016-10-02 Updated PCB board for larger traces and more compact design.
    [AT25_EEPROM.sch, Aux.sch, Heater.sch, Weather Balloon.dsn, Weather Balloon.kicad_pcb, Weather Balloon.sch]
2016-10-11 PID control and beginning of altitude alarm.
    [Aux.sch, Weather Balloon.csv, Weather Balloon.kicad_pcb, Weather Balloon.sch, _saved_Aux.sch]
2016-10-12 Prototype pre-assembly with debugging enabled
2016-10-14 After flight data retrieval
    [Aux.sch, HAB_data.csv, HAB_data_2.csv, HAB_data_2_edited.csv, HAB_data_edited.csv, Weather Balloon.kicad_pcb, _saved_Aux.sch]
2016-10-15 Investigated serial command read failure on atmega328p. Found nothing. Added pressure calculation to set altitude command.
    [Weather_Balloon.ino, sketch_oct14a.ino]
2016-11-07 Update before move to github
    [HAB_1_4000m.csv, HAB_Flight_1_Full_Resolution.csv, HAB_corrected.csv, HAB_data.csv, HAB_data_2.csv, HAB_data_2_edit_less.csv, HAB_data_2_edited.csv, HAB_data_2_kml.csv]
2016-11-09 Updated board schematic and layout files to remove title block and page outline for presentation.
